ScottMonaghan/robud-pi/robud_face/Images/robud_eye.png

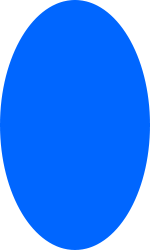
robud_face/Images/robud_eye.png
