ScottMonaghan/robud-pi/data/stl/base/Battery Fastener FR.stl

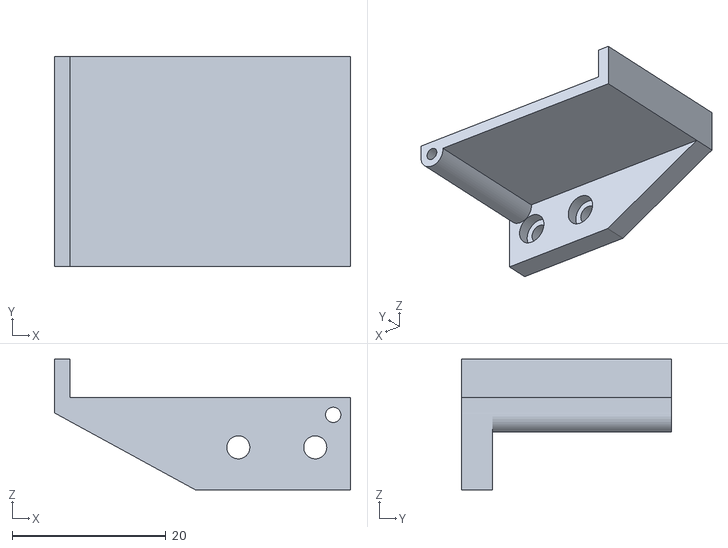
[picture p3: CAD file, 2023-02-08]
data/stl/base/Battery Fastener FR.stl
38.5 x 27.2 x 17.0
