ScottMonaghan/robud-pi/data/stl/robud-head-barrel-wall.stl

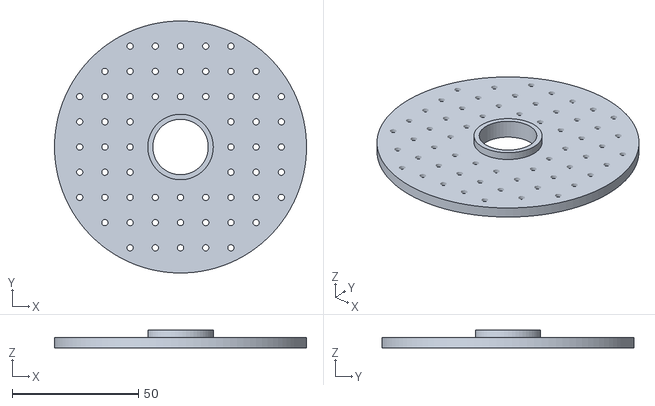
[picture p4: CAD file, 2022-10-22]
data/stl/robud-head-barrel-wall.stl
100.0 x 100.0 x 7.00
