ScottMonaghan/robud-pi/data/stl/tracks/Outer-Chassis-Brace_Left.stl

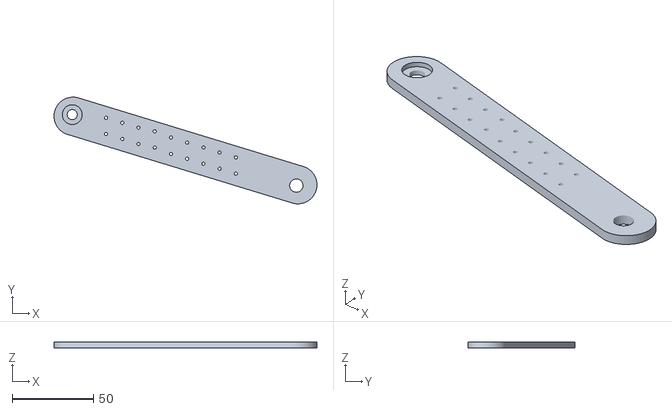
[picture p5: CAD file, 2023-03-19]
data/stl/tracks/Outer-Chassis-Brace_Left.stl
162.1 x 65.8 x 4.00
