ScottMonaghan/robud-pi/data/stl/robud-servo-adapter.stl

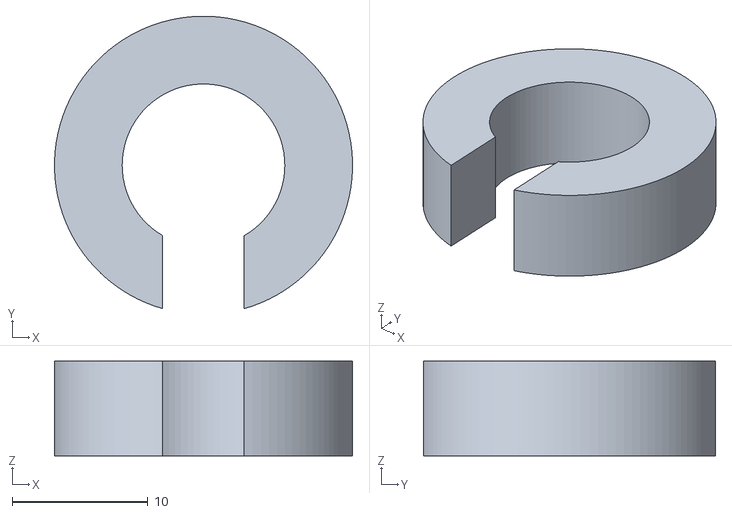
[picture p6: CAD file, 2022-10-22]
data/stl/robud-servo-adapter.stl
22.0 x 21.6 x 7.00
