ScottMonaghan/robud-pi/data/stl/tracks/Front Wheel 1.stl

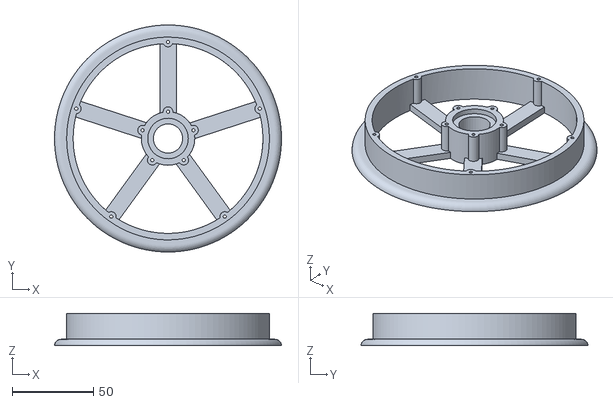
[picture p7: CAD file, 2023-03-19]
data/stl/tracks/Front Wheel 1.stl
140.0 x 140.0 x 20.0
