ScottMonaghan/robud-pi/data/stl/base/Board Fastener.stl

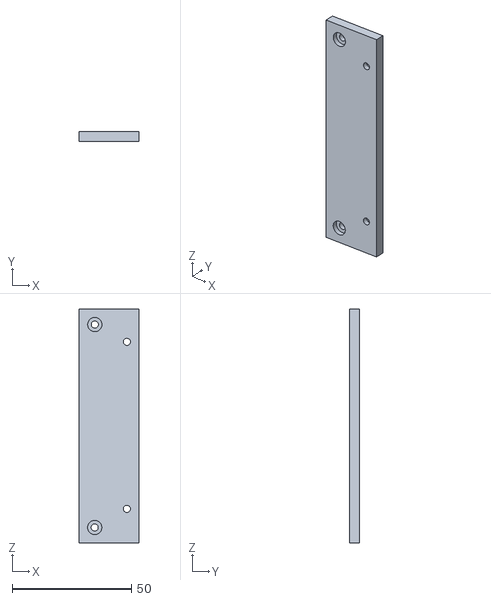
[picture p8: CAD file, 2023-02-08]
data/stl/base/Board Fastener.stl
25.0 x 4.00 x 98.0
