ScottMonaghan/robud-pi/data/stl/robud-display-fastener.stl

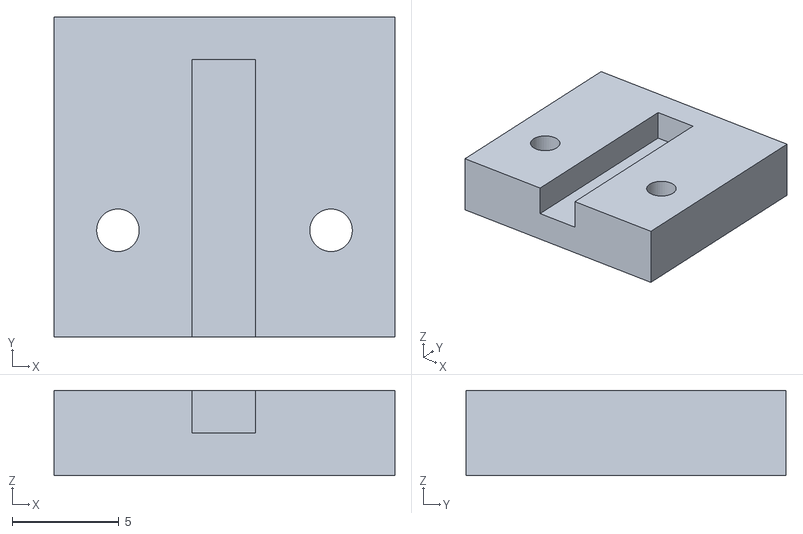
[picture p9: CAD file, 2022-10-22]
data/stl/robud-display-fastener.stl
16.0 x 15.0 x 4.00
