ScottMonaghan/robud-pi/data/stl/tracks/Bearing Peg & Spacer.stl

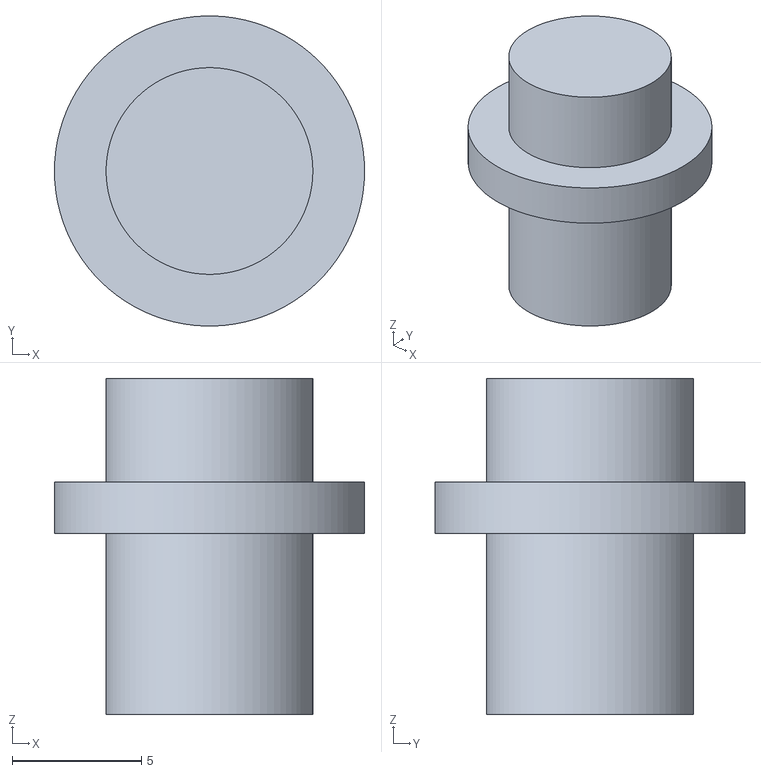
[picture p10: CAD file, 2023-03-19]
data/stl/tracks/Bearing Peg & Spacer.stl
12.0 x 12.0 x 13.0
