ScottMonaghan/robud-pi/data/stl/robud-1-hole-fastener.stl

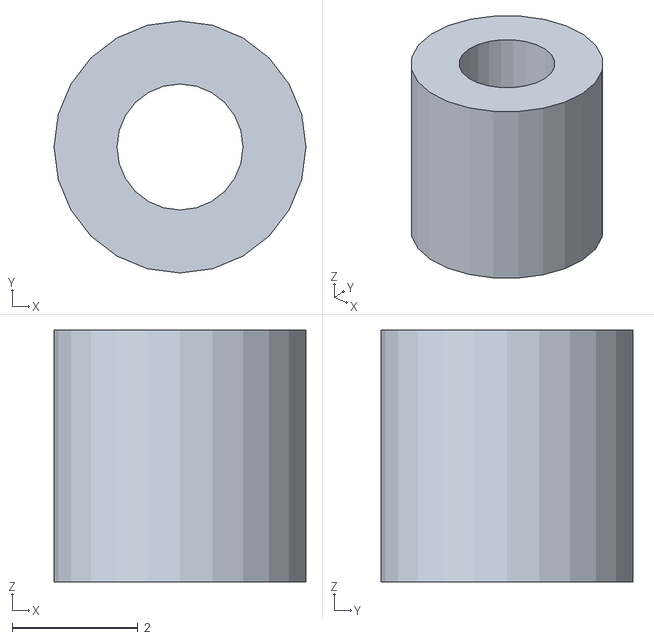
[picture p11: CAD file, 2022-10-22]
data/stl/robud-1-hole-fastener.stl
4.00 x 4.00 x 4.00
