ScottMonaghan/robud-pi/data/stl/robud-horizontal-brace.stl

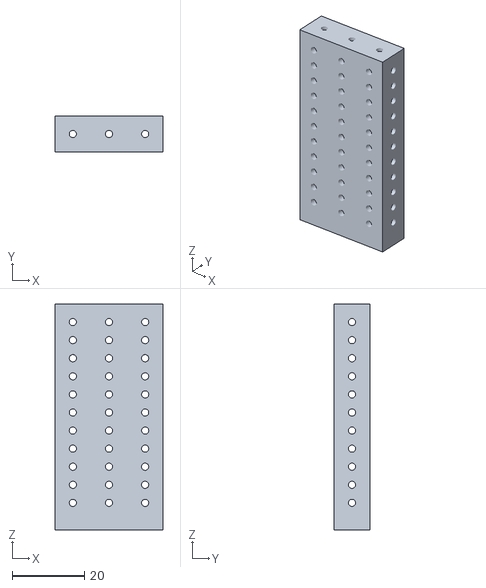
[picture p12: CAD file, 2022-10-22]
data/stl/robud-horizontal-brace.stl
30.0 x 10.0 x 62.5
