ScottMonaghan/robud-pi/data/stl/tracks/Front Wheel Hubcap.stl

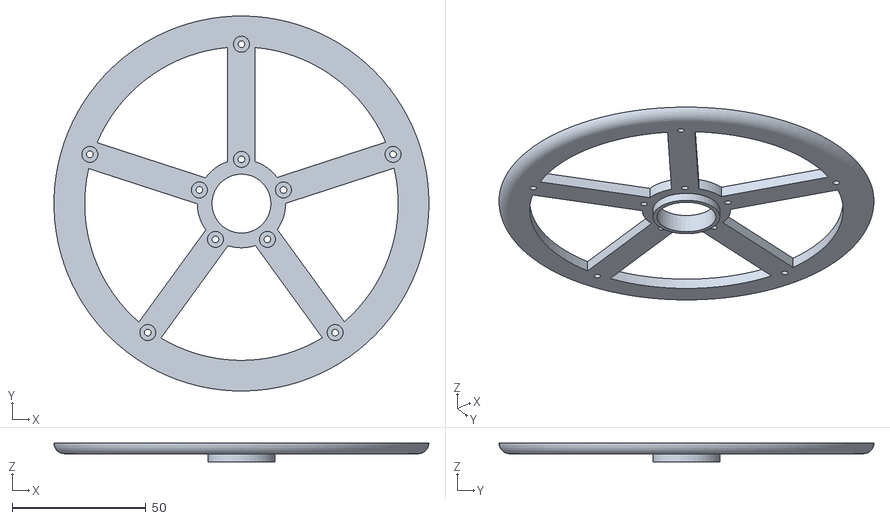
[picture p13: CAD file, 2023-03-19]
data/stl/tracks/Front Wheel Hubcap.stl
140.0 x 140.0 x 7.00
