ScottMonaghan/robud-pi/data/stl/robud-3-hole-fastener.stl

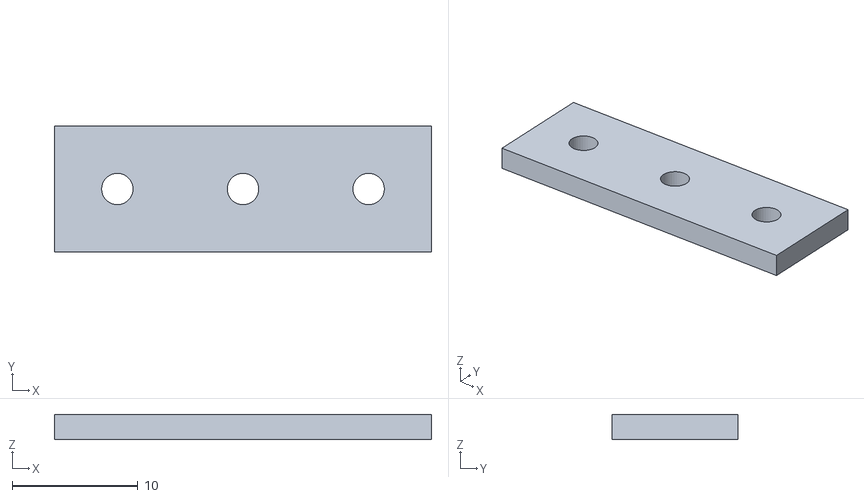
[picture p14: CAD file, 2022-10-22]
data/stl/robud-3-hole-fastener.stl
30.0 x 10.0 x 2.00
