ScottMonaghan/robud-pi/data/stl/tracks/Inner-Chassis-Brace_Right.stl

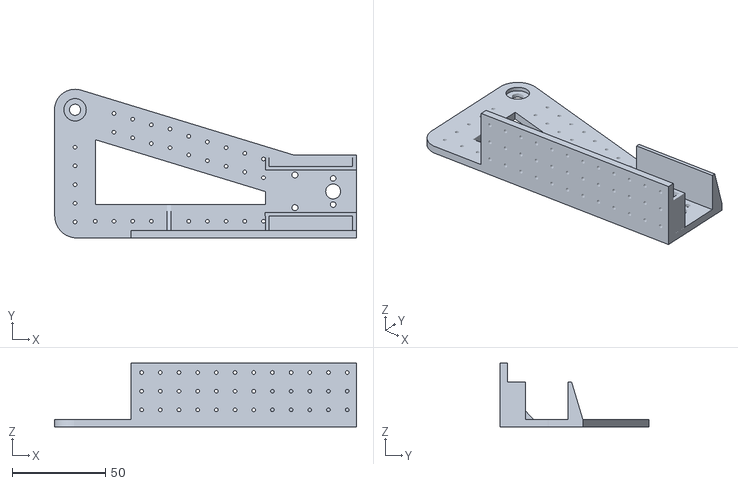
[picture p15: CAD file, 2023-03-19]
data/stl/tracks/Inner-Chassis-Brace_Right.stl
161.6 x 79.5 x 34.0
