ScottMonaghan/robud-pi/data/stl/robud-head-L-bracket.stl

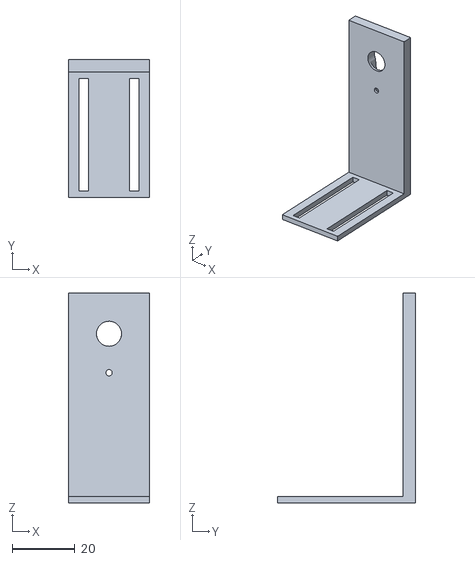
[picture p16: CAD file, 2022-10-22]
data/stl/robud-head-L-bracket.stl
26.0 x 44.0 x 67.0
