ScottMonaghan/robud-pi/data/stl/tracks/hub fastener.stl

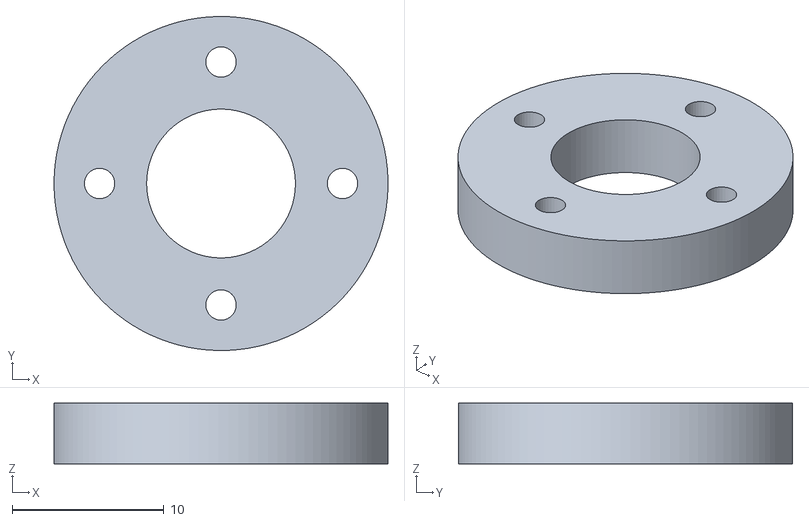
[picture p17: CAD file, 2023-03-19]
data/stl/tracks/hub fastener.stl
22.0 x 22.0 x 4.00
