ScottMonaghan/robud-pi/data/stl/tracks/Printable Belt.stl

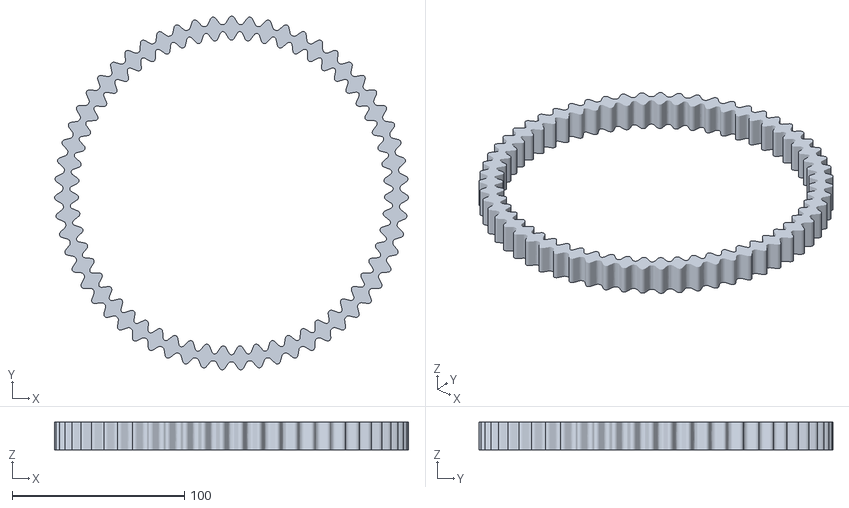
[picture p18: CAD file, 2023-03-19]
data/stl/tracks/Printable Belt.stl
205.4 x 205.3 x 16.0
