ScottMonaghan/robud-pi/data/stl/tracks/Back Wheel Cap.stl

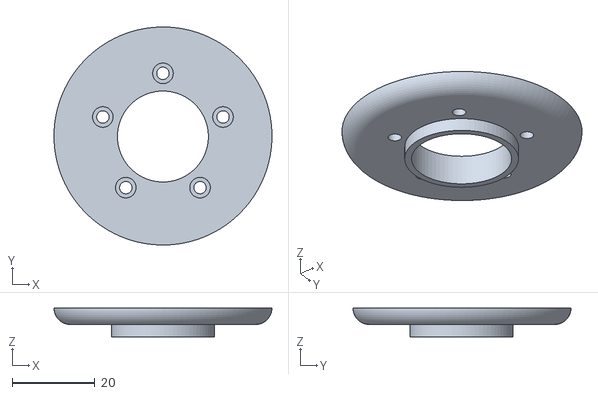
[picture p19: CAD file, 2023-03-19]
data/stl/tracks/Back Wheel Cap.stl
52.7 x 52.7 x 7.00
