ScottMonaghan/robud-pi/data/stl/tracks/Back Wheel Sprocket.stl

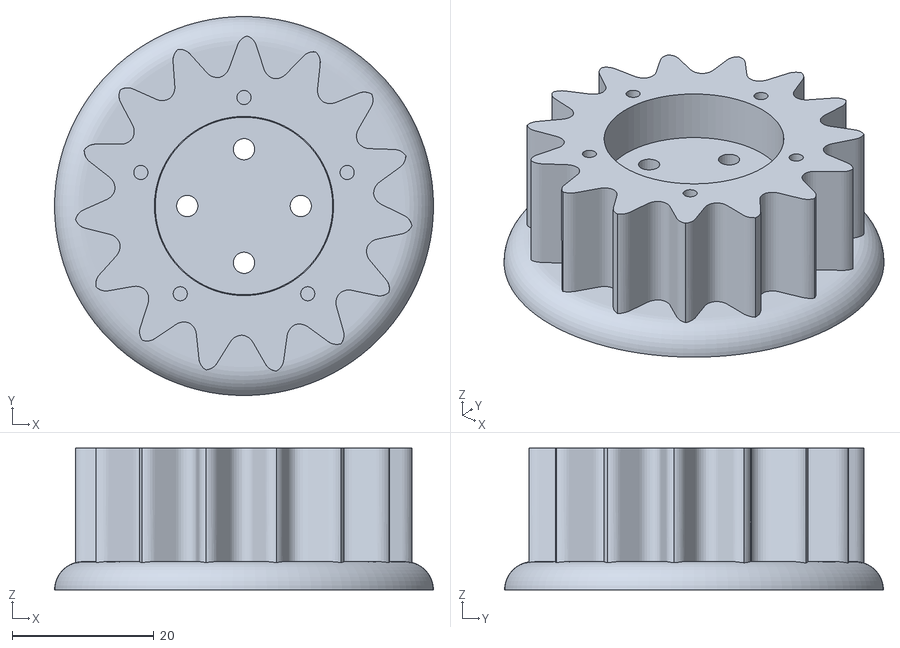
[picture p20: CAD file, 2023-03-19]
data/stl/tracks/Back Wheel Sprocket.stl
53.4 x 53.4 x 20.0
