ScottMonaghan/robud-pi/(list of files, cad)

Other CAD files:
data/stl/base/Battery Fastener FL.stl
data/stl/tracks/Outer-Chassis-Brace_Right.stl
data/stl/robud-head-shaft-adapter.stl
data/stl/tracks/Inner-Chassis-Brace_Left.stl
data/stl/tracks/Washer-large-inner-diameter.stl
data/stl/tracks/Washer-small-inner-diameter.stl
