ScottMonaghan/robud-pi/doc/build-instructions/head-assembly.md

## Head Assembly
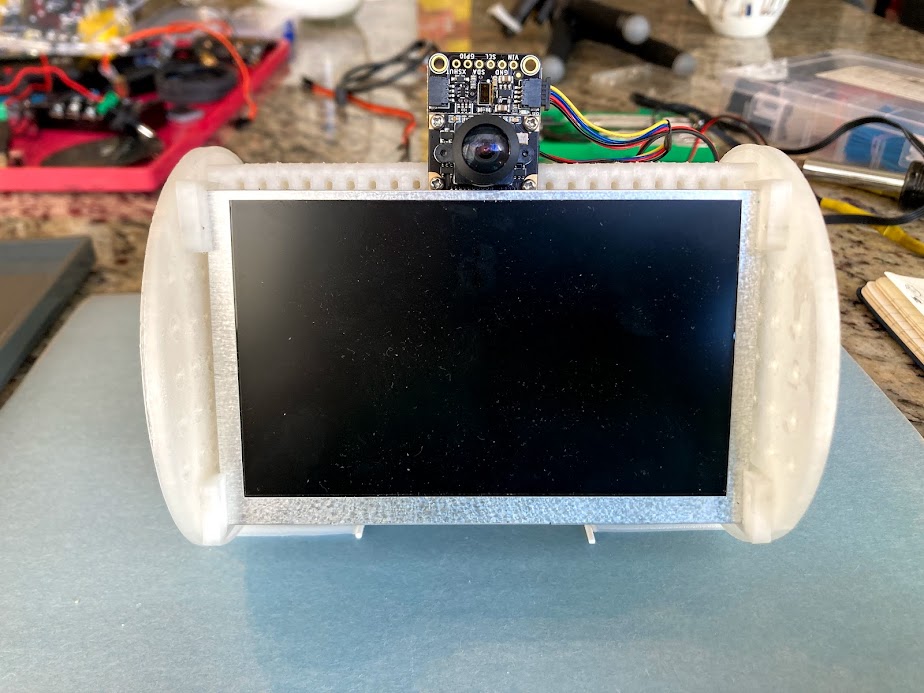
[picture p21: data/images/build-instructions/IMG_3664.jpg]

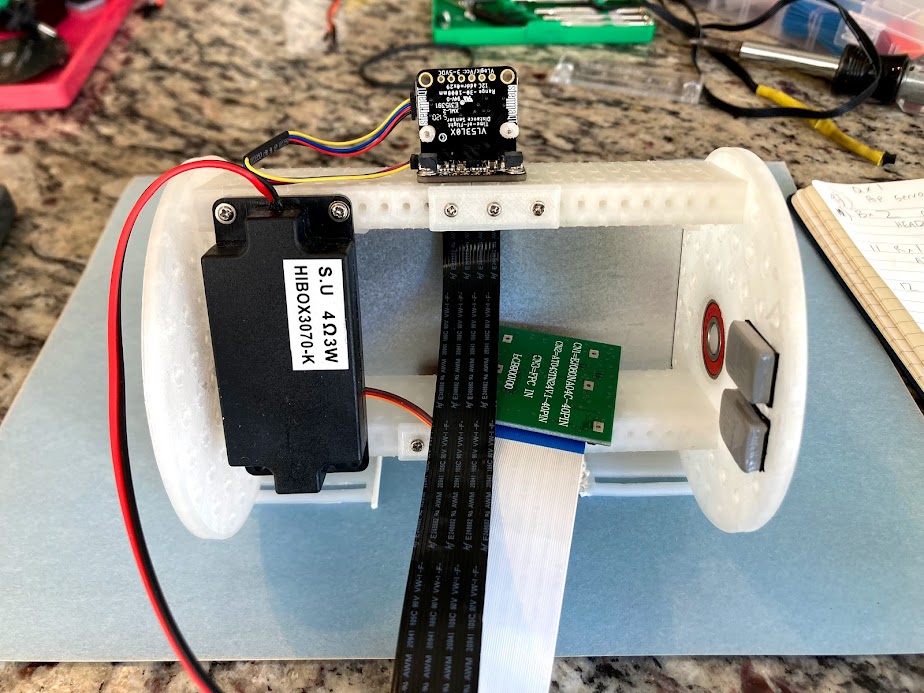
[picture p22: data/images/build-instructions/IMG_3666.jpg]


### 1. Attach two horizontal braces(A) with 3-hole fastener(B) & attach BNO-055  orientation sensor(E)  

**Parts:**  
   * x2 A. horizontal braces  
   * x1 B. 3-hole fastener  
   * x3 C. 2x8mm round-head self-tapping screws  
   * x4 D. 2x8mm pan-head-with-washer self-tapping screws  
   * x1 E. BNO055 orientation sensor  

>_**Notes:**_ 
>   * _Make sure Y axis of BNO055(E) points toward picture as shown in image_
>   * _Only fasten one side of the horizontal braces(E)_
     
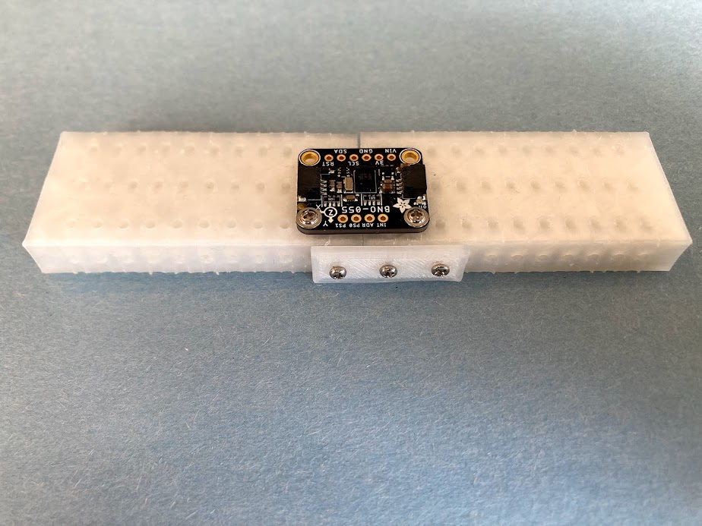
[picture p23: data/images/build-instructions/IMG_3640.jpg]


---
### 2. Turn 180 degrees and attach camera(F) 

**Parts:**  
   * x1 F. SainSmart IMX219 Camera Module
   * x2 C. 2x8mm round-head self-tapping screws

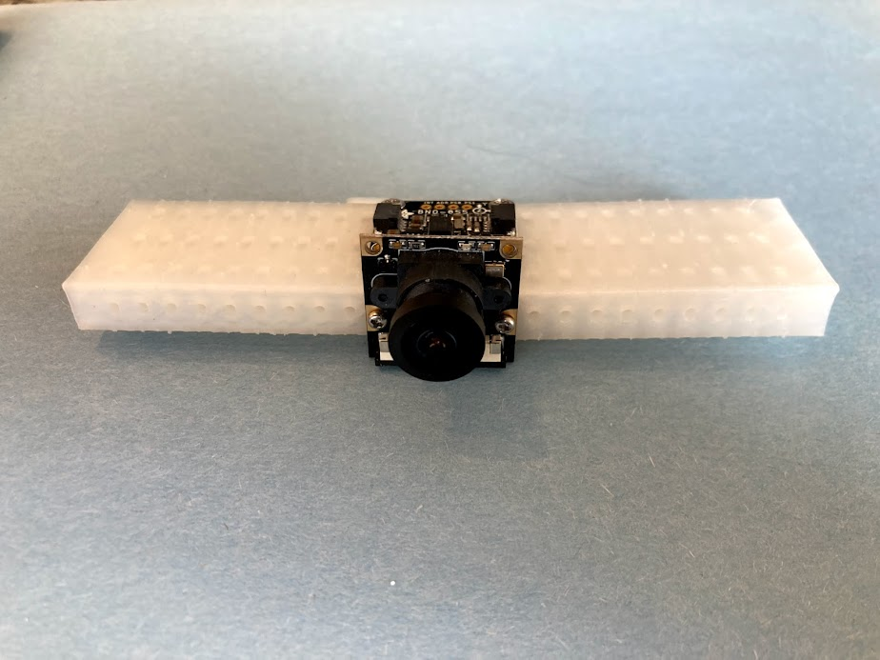
[picture p24: data/images/build-instructions/IMG_3642.jpg]
Head Assembly Step 2


---    
### 3. Attach VL53L0X time-of-flight distance sensor(G) 

**Parts:** 
  * x2 H. 1-hole 2mm screw fastener  
  * x2 C. 2x8mm round-head self-tapping screws  
  * x1 G. VL53L0X time-of-flight distance sensor  
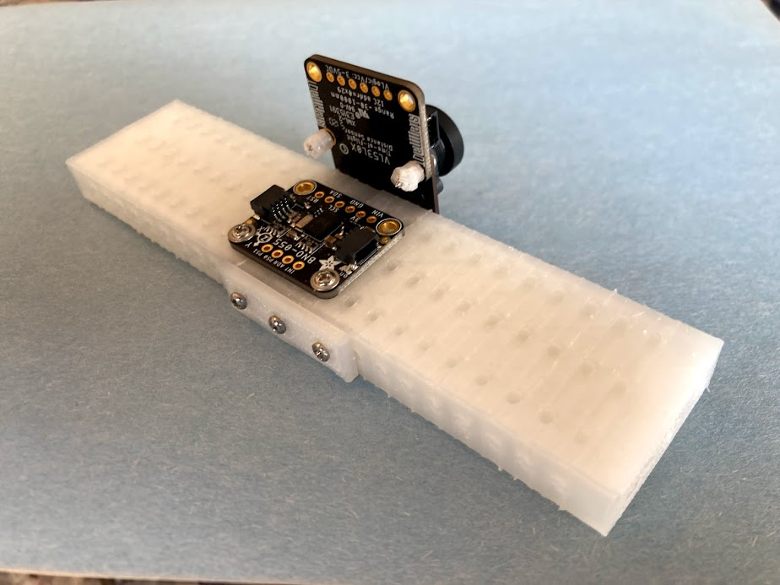
[picture p25: data/images/build-instructions/IMG_3644.jpg]

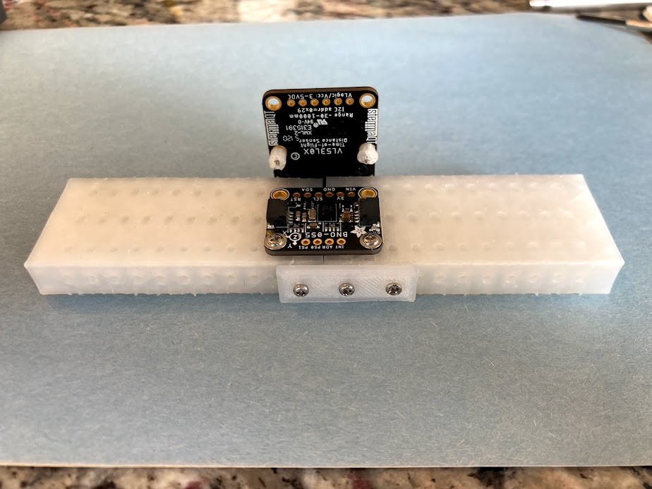
[picture p26: data/images/build-instructions/IMG_3645.jpg]


---     
### 4. Attach camera 15-pin ribbon(I) cable & STEMMA QT cable(J)

**Parts:** 
  * x1 I. 300mm 15-pin camera ribbon cable
  * x1 J. 100mm Stemma QT JST SH 4-pin cable

>_**Notes:**_ 
>   * _Make sure pins of ribbon cable are facing toward contacts and fastened securely_
>   * _Attatch STEMMA QT cable(J) securely to right STEMMA sockets on VL53L0X(G) and BNO055(E)_
   
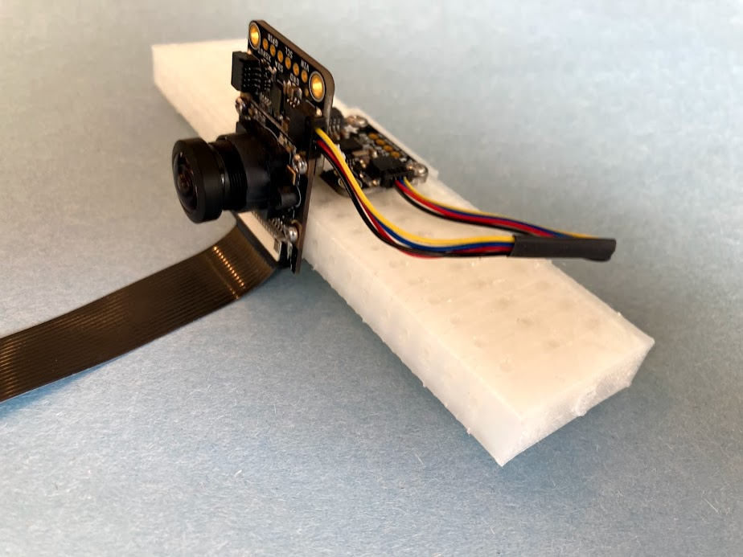
[picture p27: data/images/build-instructions/IMG_3646.jpg]
Head Assembly Step 4


---   
### 5. Attach display fasteners(K) and servo adapter(L) to left barrel wall(M)
**Parts:**  
 * x1 M. head barrel wall
 * x1 L. servo adapter
 * x2 K. display fastener
 * x4 D. 2x8mm pan-head-with-washer self-tapping screws

>_**Notes:**_
>   * _Make sure fasteners and raised center lip are on opposite sides_
>   * _Make sure slotted sides of the display fasteners(K) are face up, with open sides pointed inside the circle, and closed ends are pointed out_
>   * _Make sure servo adapter is oriented as shown in image_
>   * _If servo adapter cannot be popped in, soften with a hair dryer or heat gun_
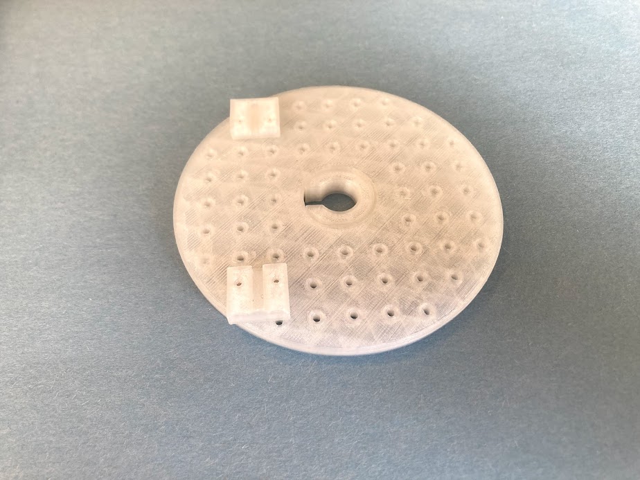
[picture p28: data/images/build-instructions/IMG_3647.jpg]

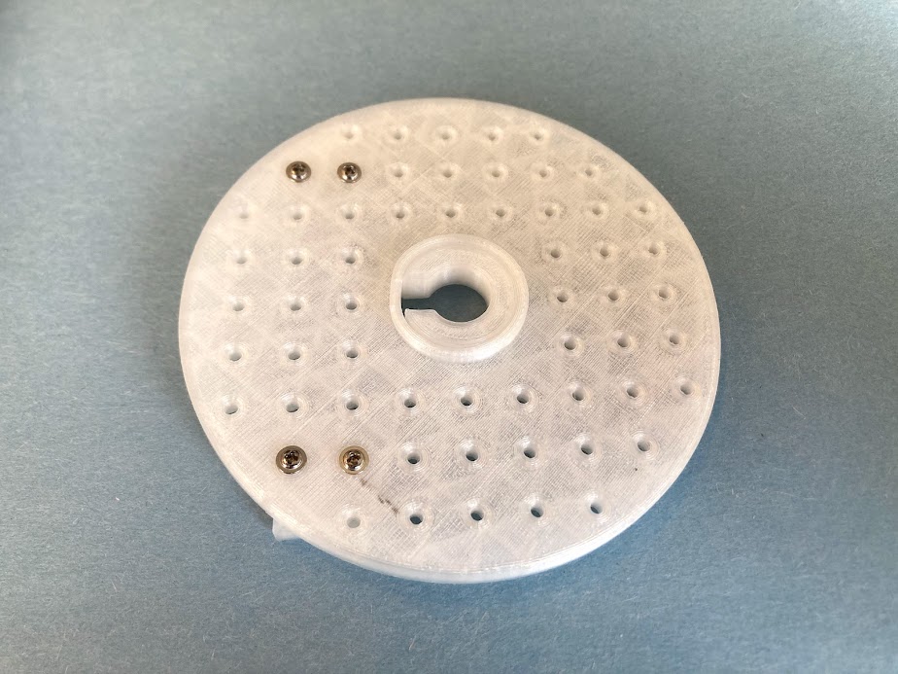
[picture p29: data/images/build-instructions/IMG_3648.jpg]


---   
### 6. Backdrive servo to 90 degrees
**Parts:**  
   * x1 Q. MG90S 9G micro servo  

>_**Notes:**_
>   * _Suggested steps:_
>     * _Use pliars to gently turn the servo shaft counter-clockwise until you hit the physical stop._
>     * _Then position your pliars at the top at 12:00 as shown in the first picture._
>     * _Finally, carefully turn the shaft clockwise 90 degrees to 3:00 as shown in the second picture._  
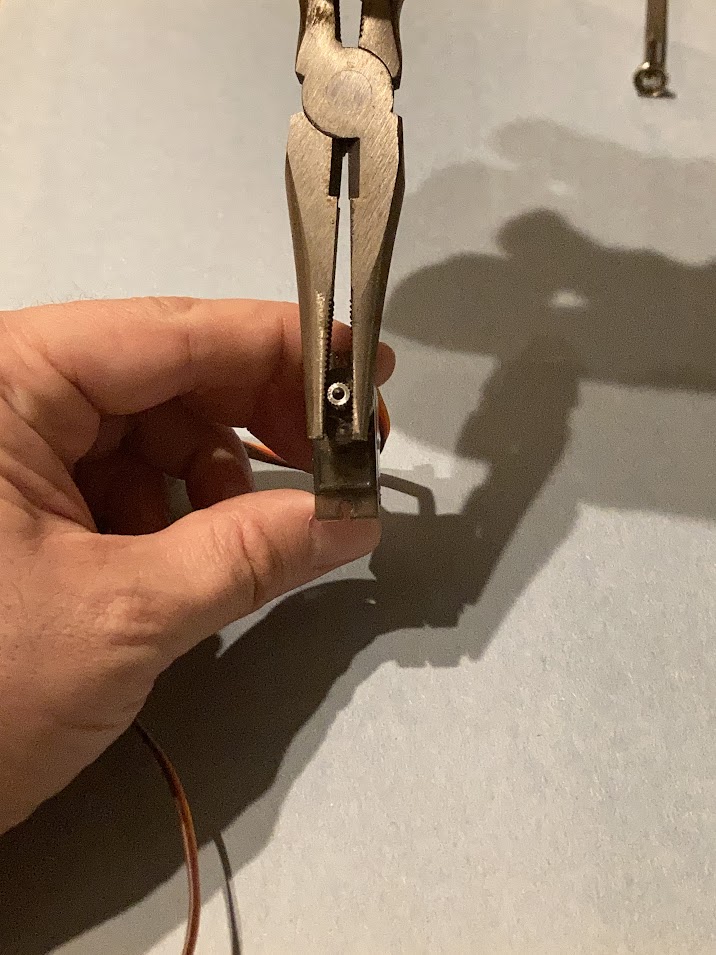
[picture p30: data/images/build-instructions/IMG_3672.jpg]

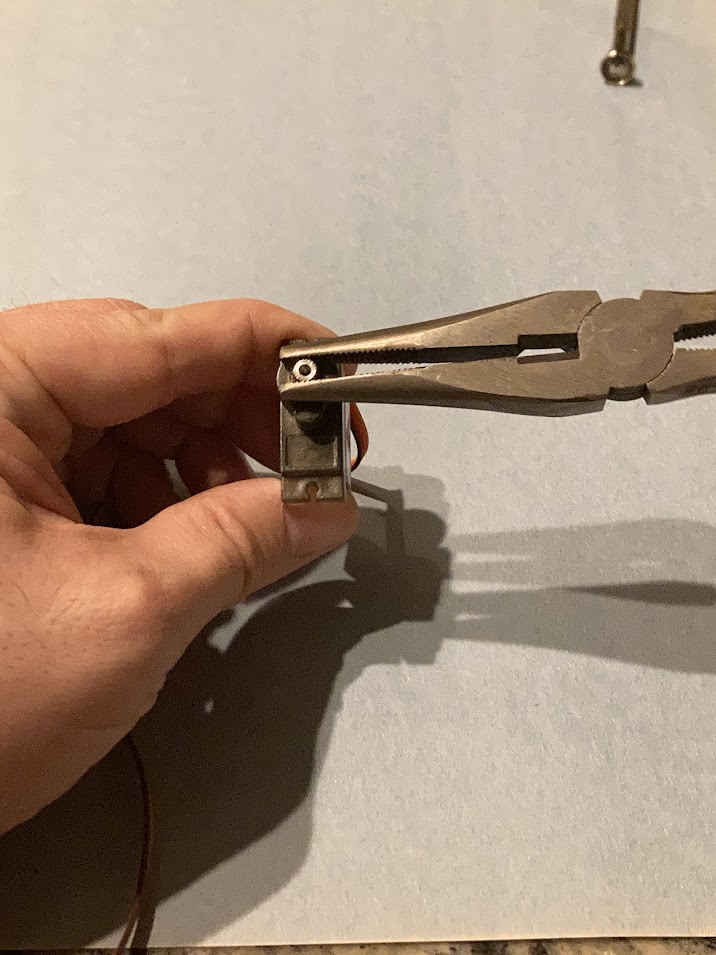
[picture p31: data/images/build-instructions/IMG_3684.jpg]


---   
### 7. Pop servo(Q) into left barrel wall(M)
**Parts:**  
   * x1 Q. MG90S 9G micro servo  
   * x2 M. left barrel wall(M) from step 5  

>_**Notes:**_
>   * _Body of servo should be on same side as fasteners from step 5_  
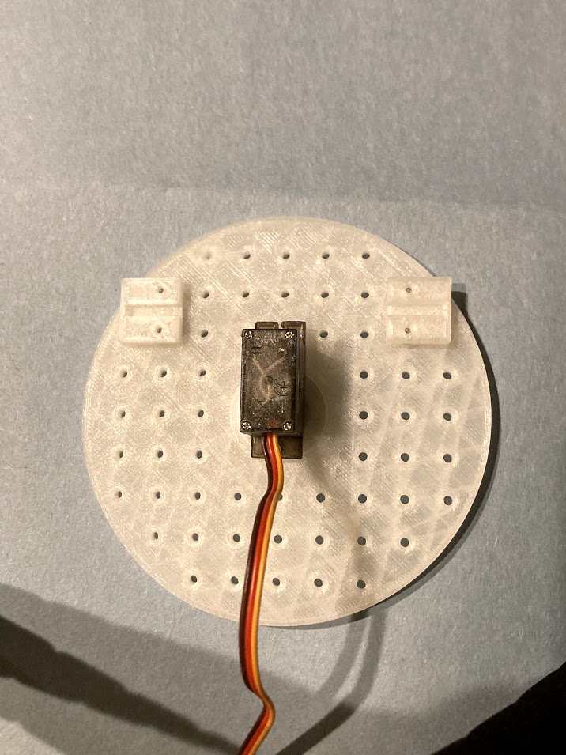
[picture p32: data/images/build-instructions/IMG_3689.jpg]


---   
### 8. Add shaft(N) to bearing(O)
**Parts:**  
 * x1 N. head shaft adapter 
 * x1 O. bearing 

>_**Notes:**_
>   * _If shaft cannot be popped in, soften with a hair dryer or heat gun_
>   * _The longer side of the shaft should be in the bearing_
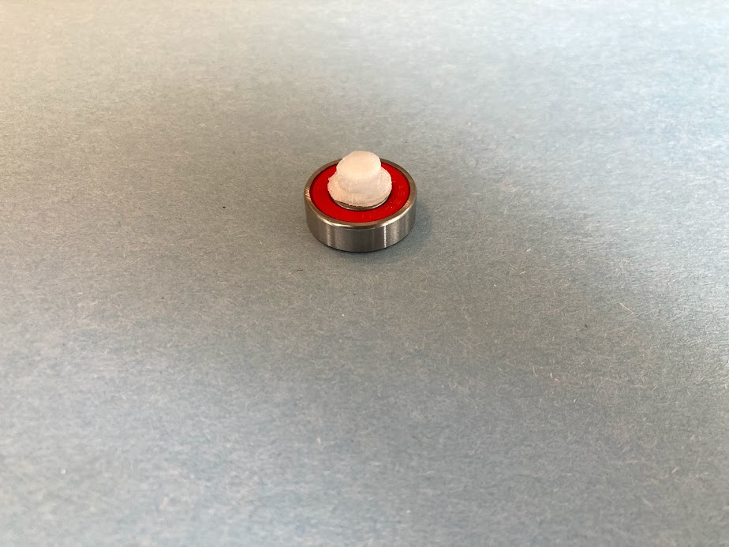
[picture p33: data/images/build-instructions/IMG_3650.jpg]


---   
### 9. Attach display fasteners(K) and balance weights(L) to right barrel wall(M)
**Parts:**  
 * x1 M. head barrel wall
 * x2 K. display fastener
 * x2 P. balance weights

>_**Notes:**_
>  * _Make sure fasteners and raised center lip are on opposite sides_
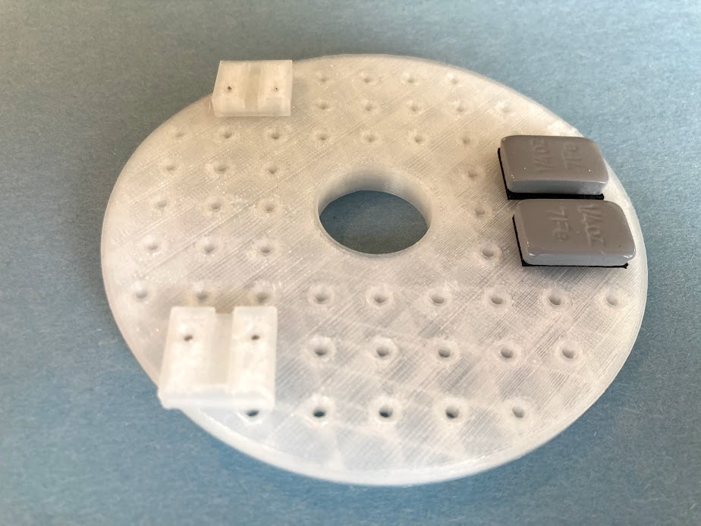
[picture p34: data/images/build-instructions/IMG_3651.jpg]


---   
### 10. Pop bearing(O) into right barrel wall(M)
**Parts:**  
 * x1 bearing(O) with shaft(N) from step 8
 * x1 right barrel wall(M) from step 9

>_**Notes:**_
>   * _Make sure shaft is on the opposite side of the clips & weights_
>   * _If bearing cannot be popped in, soften with a hair dryer or heat gun_
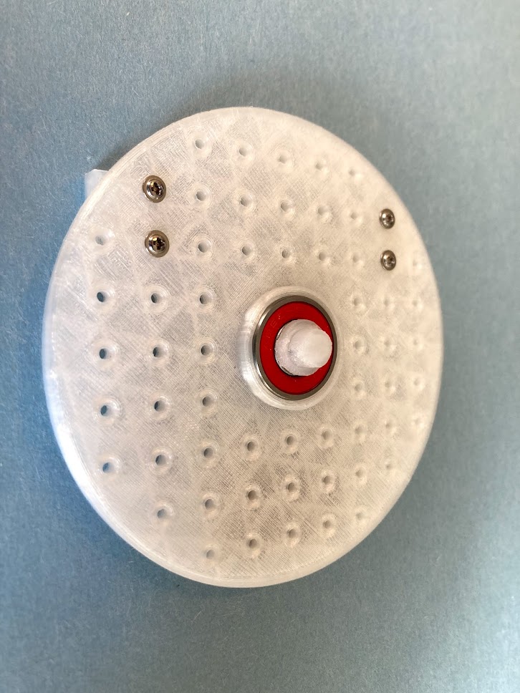
[picture p35: data/images/build-instructions/IMG_3652.jpg]


---   
### 11. Attach two horizontal braces(A) with two 3-hole fasteners(B) to create lower head brace
**Parts:**  
   * x2 A. horizontal braces  
   * x2 B. 3-hole fasteners  

>_**Notes:**_
>  * _Make sure to add 3-hole fastener(B) to both sides_
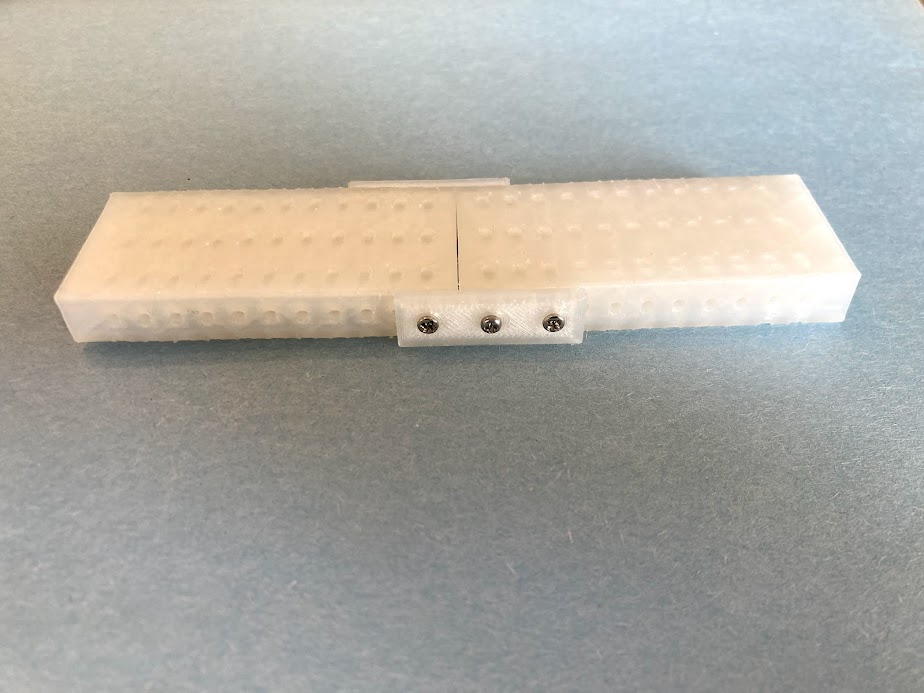
[picture p36: data/images/build-instructions/IMG_3653.jpg]


---   
### 12. Attach bottom head brace to left barrel wall
**Parts:**  
   * x1 Left barrel wall with servo (from step 7)  
   * x1 Lower horizontal head brace (from step 11)  
   * x2 D. 2x8mm pan-head-with-washer self-tapping screws
  
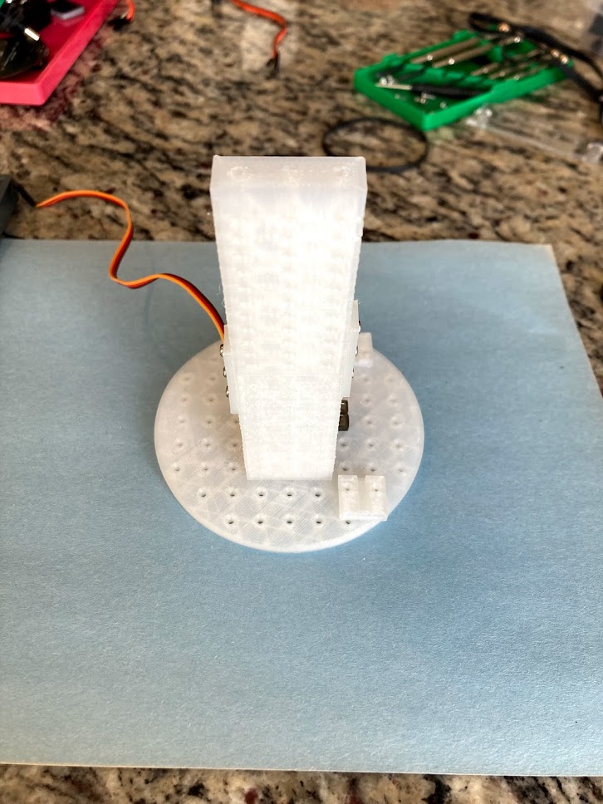
[picture p37: data/images/build-instructions/IMG_3654.jpg]

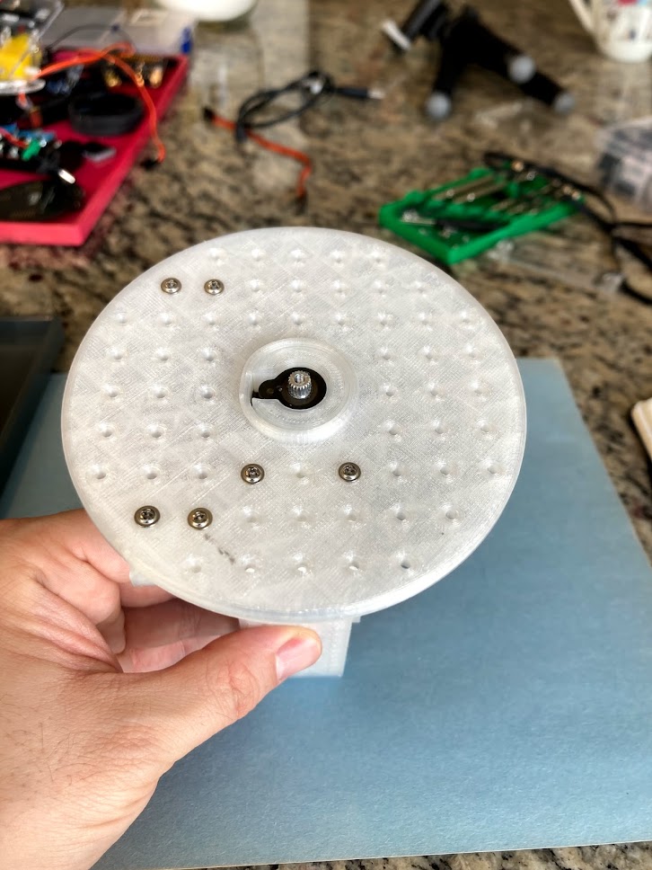
[picture p38: data/images/build-instructions/IMG_3655.jpg]


---   
### 13. Attach top head brace to left barrel wall
**Parts:**  
   * x1 Left barrel wall with servo (from step 12)  
   * x1 Top horizontal head brace with camera (from step 1)  
   * x2 D. 2x8mm pan-head-with-washer self-tapping screws
  
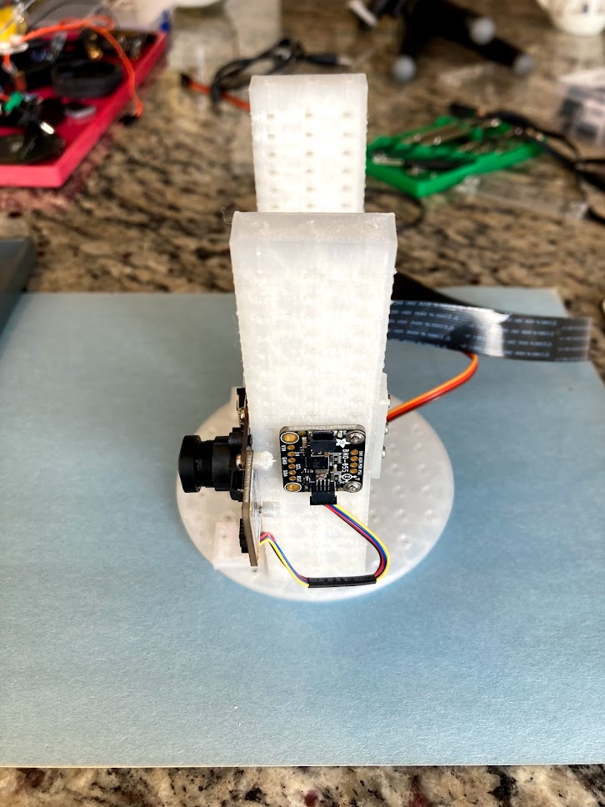
[picture p39: data/images/build-instructions/IMG_3656.jpg]

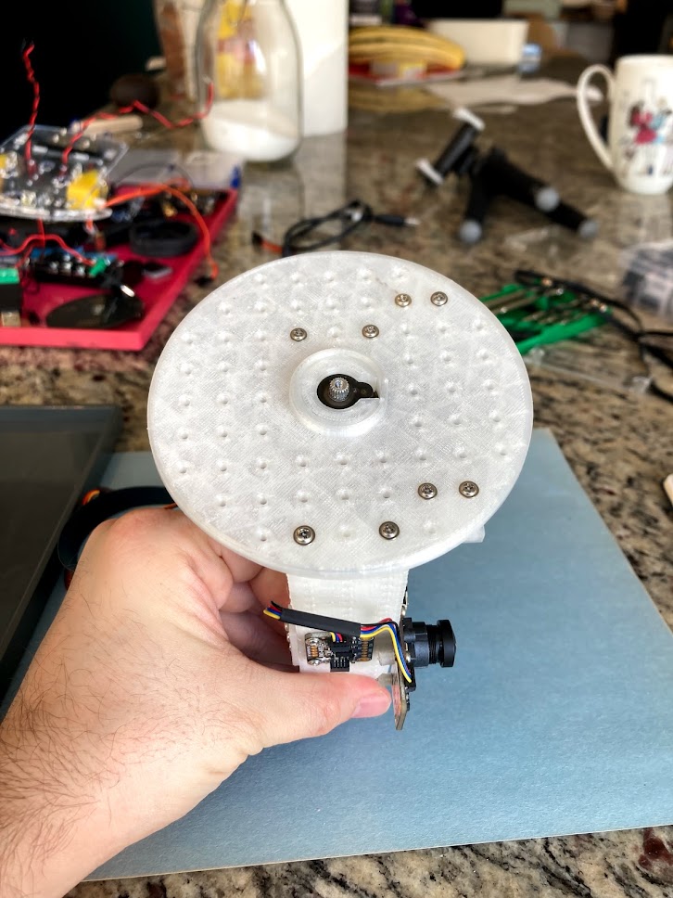
[picture p40: data/images/build-instructions/IMG_3657.jpg]


---   
### 14. Attach 40-pin display ribbon(S) to display(R)  
**Parts:**  
   * x1 R. 7in display  
   * x1 S. 250mm 40pin display ribbon cable  

>_**Notes:**_
>   * _Make sure pins of ribbon cable are facing toward contacts and fastened securely_
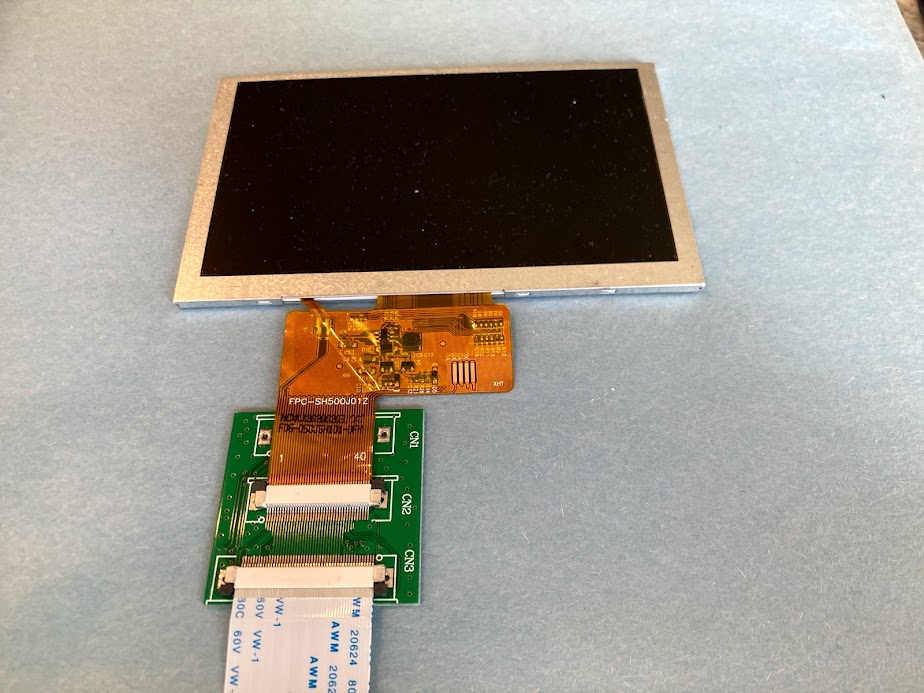
[picture p41: data/images/build-instructions/IMG_3658.jpg]


---   
### 15. Pop display(S) into clips of left barrel wall(M)
**Parts:**  
   * x1 R. 7in display  
   * x1 left barrel wall with servo (from step 12)  

>_**Notes:**_
>   * _Make sure the cables are on the bottom (opposite camera) and feed bewtween both horizontal braces_

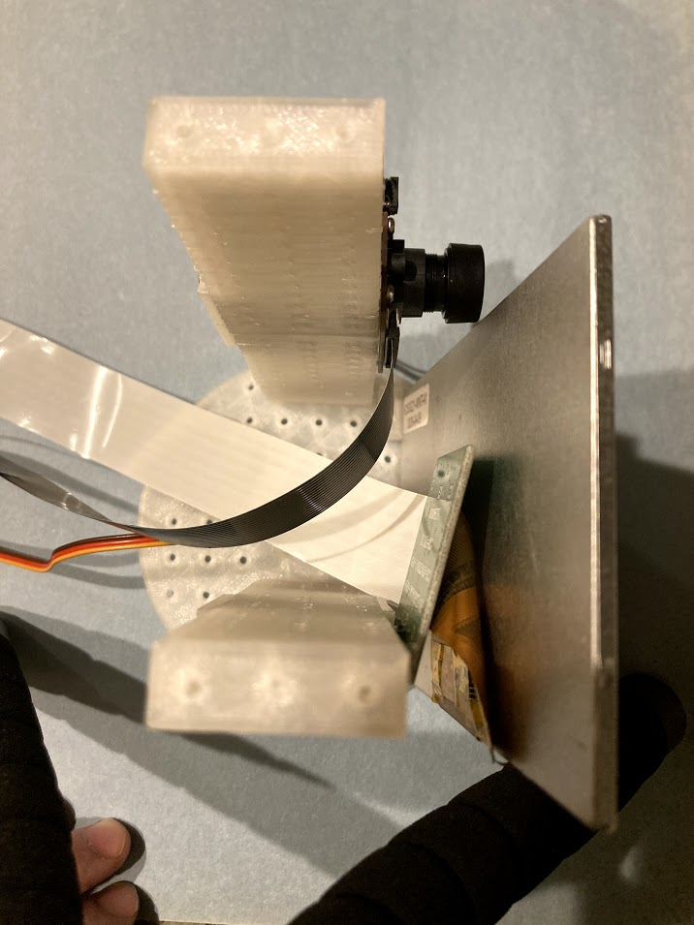
[picture p42: data/images/build-instructions/IMG_3690.jpg]


---   
### 16. Pop right barrel(M) display fasteners(K) onto display and secure to horizontal braces(A) 
**Parts:**  
   * x1 right barrel wall(M) with bearing and shaft (from step 10)
   * x2 D. 2x8mm pan-head-with-washer self-tapping screws

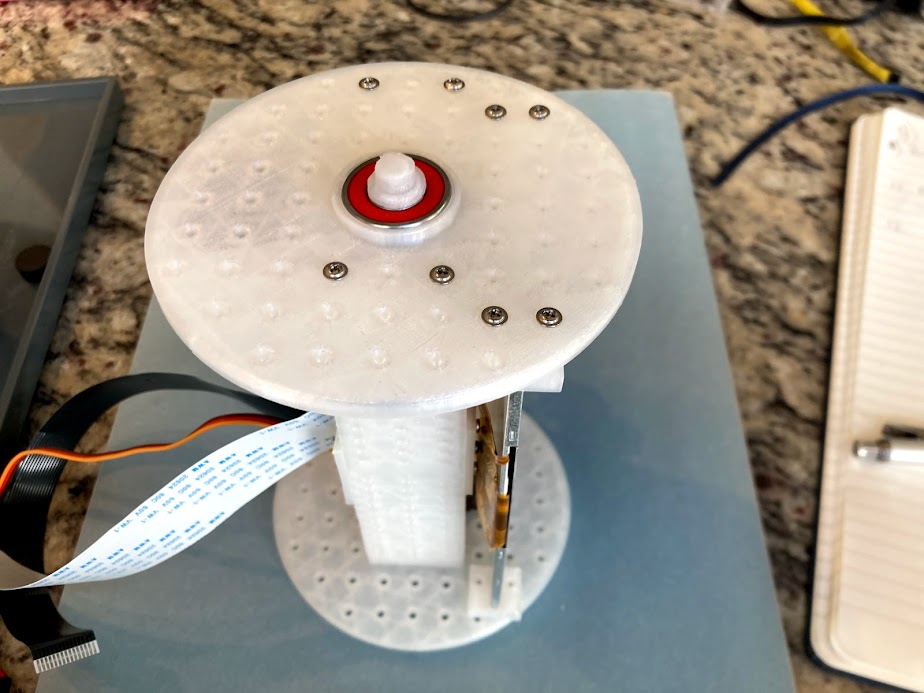
[picture p43: data/images/build-instructions/IMG_3659.jpg]


---   
### 17. Attach speaker(T)
**Parts:**  
   * x1 T. mono enclosed speaker - 3W 4 ohm
   * x2 D. 2x8mm pan-head-with-washer self-tapping screws

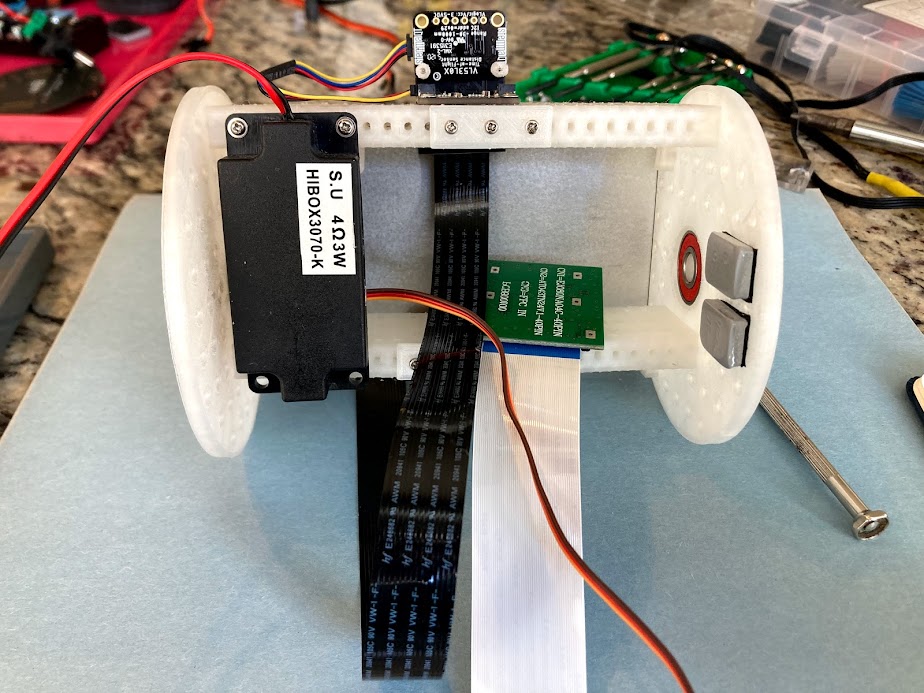
[picture p44: data/images/build-instructions/IMG_3660.jpg]


---   
### 18. Pop right L bracket(U) on bearing shaft
**Parts:**  
   * x1 U. head L bracket

>_**Notes:**_
>   * _If shaft does not pop onto L bracket, use hair dryer or heat gun to soften_

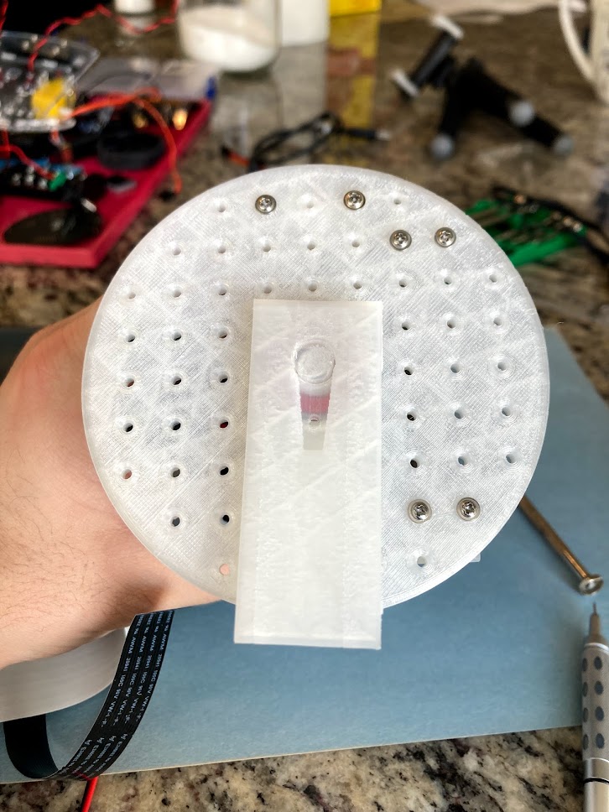
[picture p45: data/images/build-instructions/IMG_3661.jpg]


---   
### 19. Attatch servo horn to remaining L bracket(L) and secure with screw(D)
**Parts:**  
   * x1 U. head L bracket
   * x1 V. servo horn
   * x1 D. 2x8mm pan-head-with-washer self-tapping screw

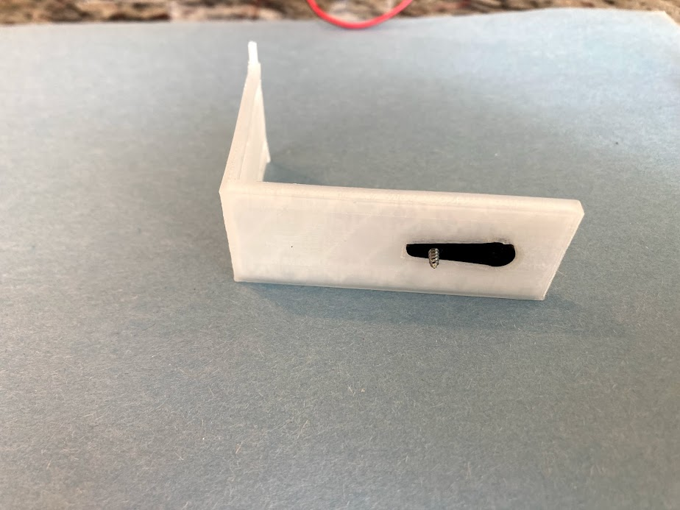
[picture p46: data/images/build-instructions/IMG_3662.jpg]

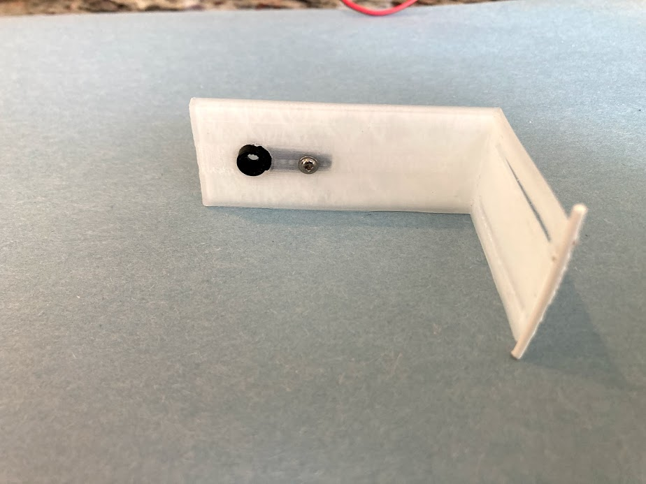
[picture p47: data/images/build-instructions/IMG_3663.jpg]


---   
### 20. Secure left L bracket to head with servo screw(W)
**Parts:**  
   * x1 W. server screw

>_**Notes:**_
>  * _IMPORTANT: The servo horn should be pointing straight down attached with screen pointing straight left_
>  * _Be careful not to turn servo shaft when attaching. If you do, repeat step 6._

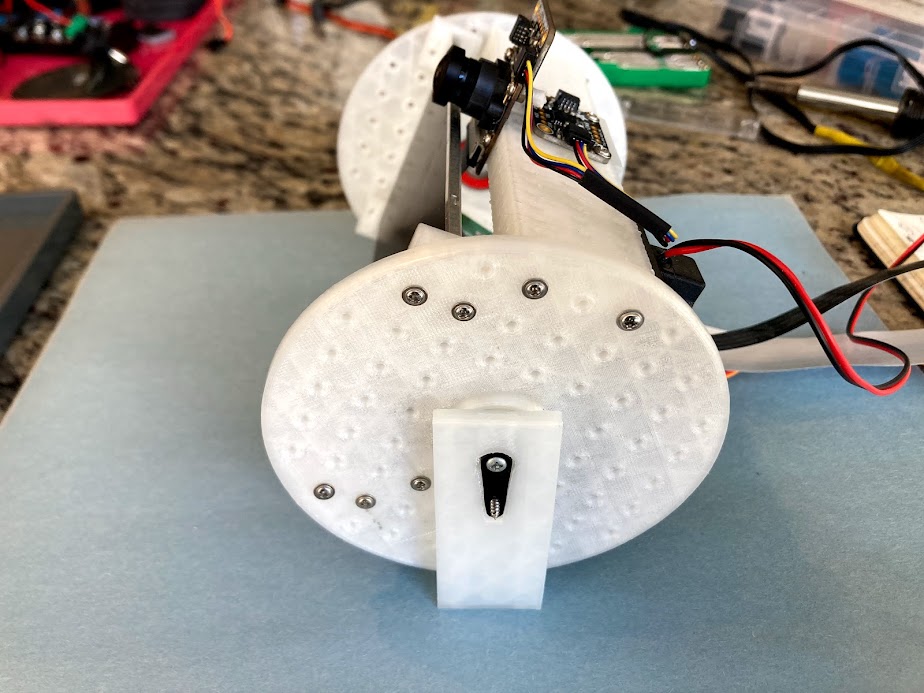
[picture p48: data/images/build-instructions/IMG_3665.jpg]


---   
### 21. The head is now complete and should match the images below:  

Head Assembly Step 5
Head Assembly Step 5
Head Assembly Step 5
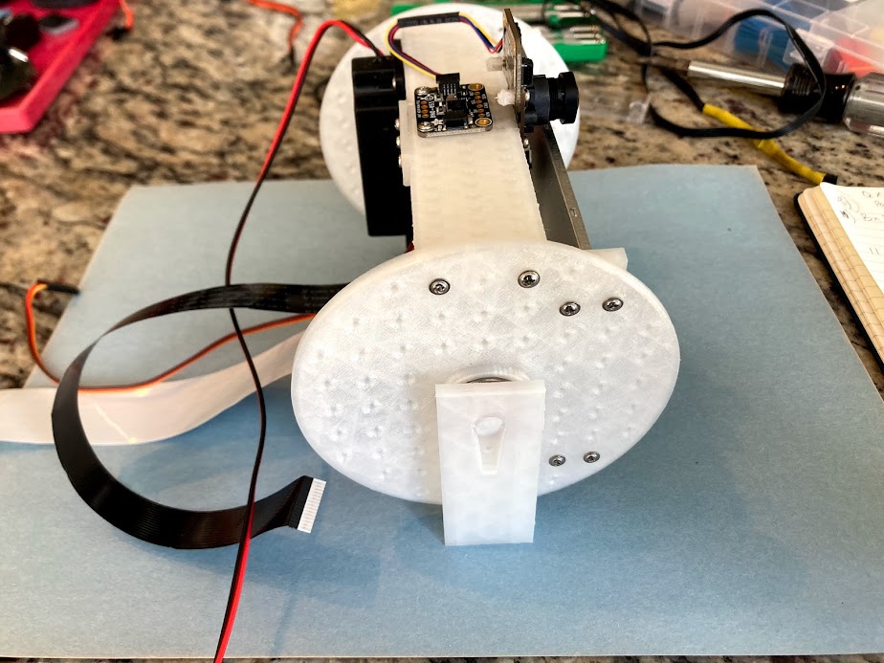
[picture p49: data/images/build-instructions/IMG_3667.jpg]


[Return to Readme](../../README.md#table-of-contents)
