ScottMonaghan/robud-pi/data/images/build-instructions/IMG_3643.jpg

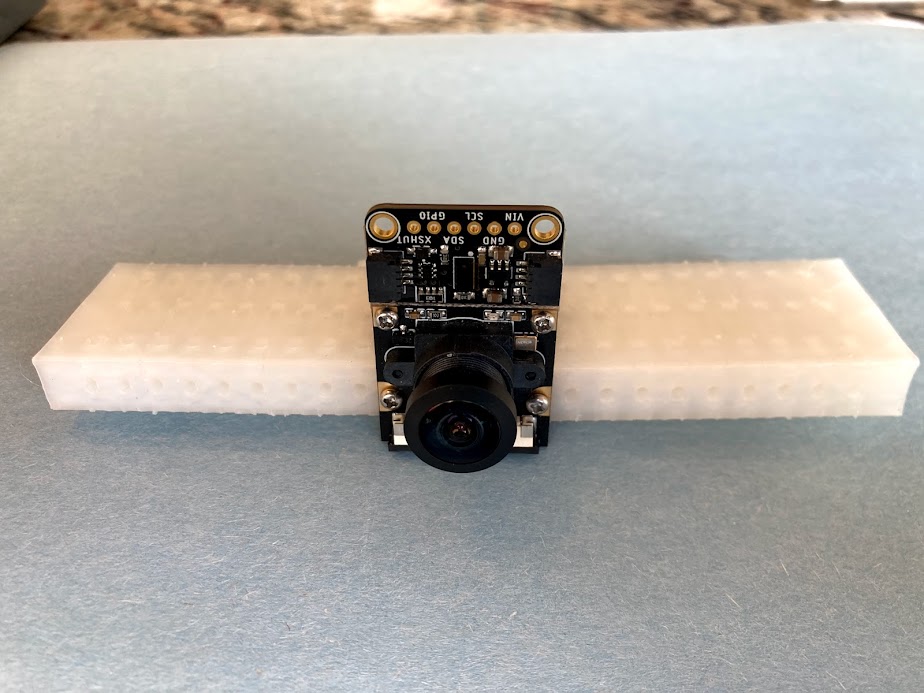
data/images/build-instructions/IMG_3643.jpg
