ScottMonaghan/robud-pi/data/images/build-instructions/IMG_3691.jpg

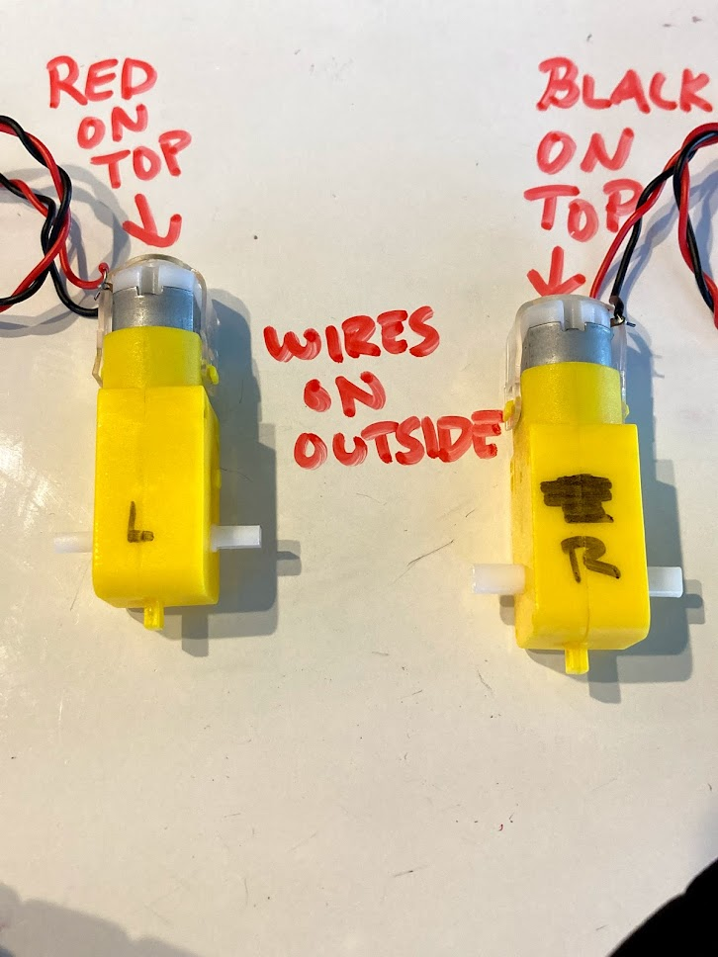
data/images/build-instructions/IMG_3691.jpg
