ScottMonaghan/robud-pi/data/images/build-instructions/IMG_3692.jpg

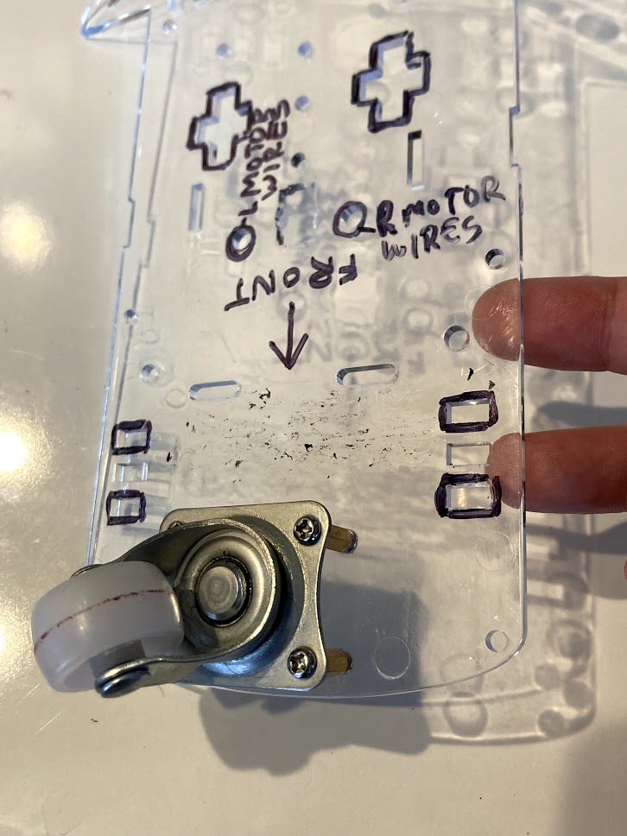
data/images/build-instructions/IMG_3692.jpg
