ScottMonaghan/robud-pi/data/images/build-instructions/IMG_3693.jpg

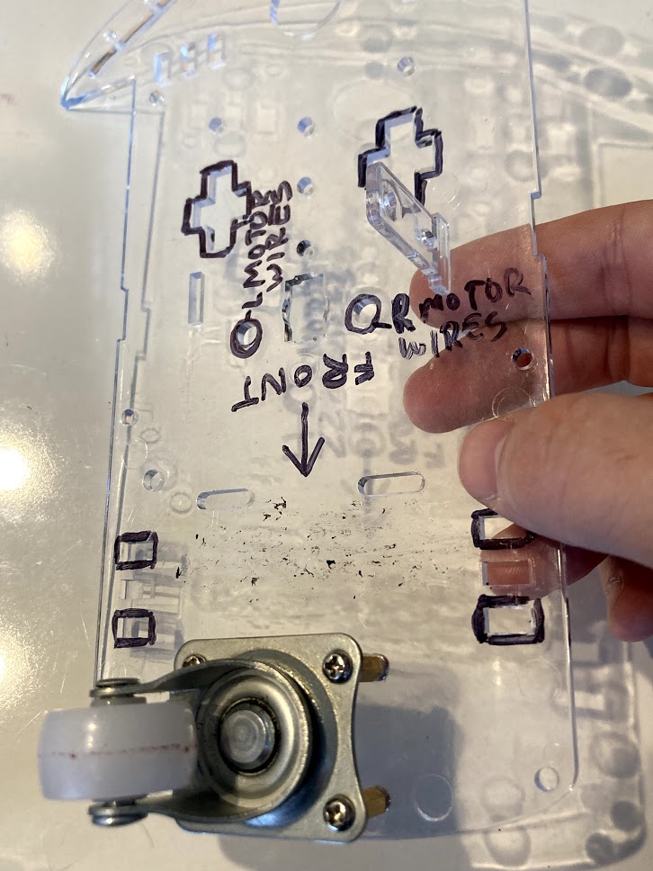
data/images/build-instructions/IMG_3693.jpg
