ScottMonaghan/robud-pi/data/images/build-instructions/IMG_3694.jpg

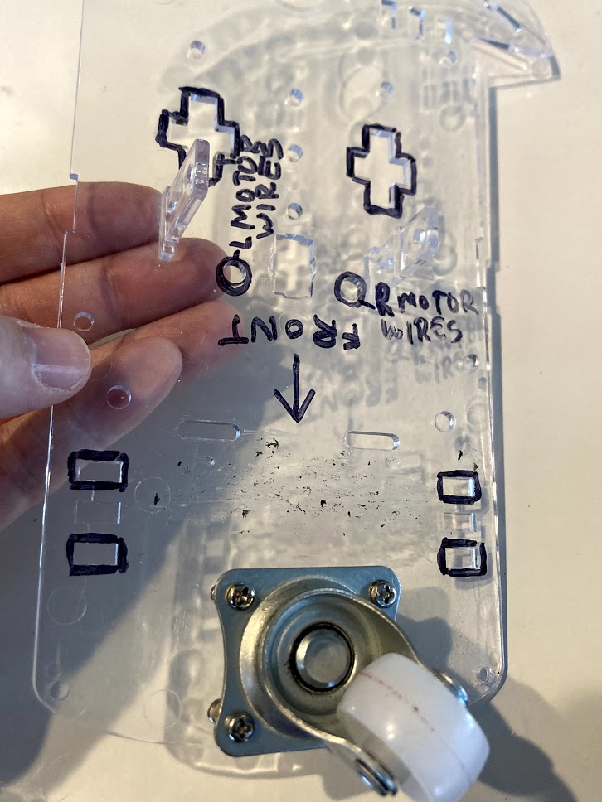
data/images/build-instructions/IMG_3694.jpg
