ScottMonaghan/robud-pi/data/images/build-instructions/IMG_3702.JPG

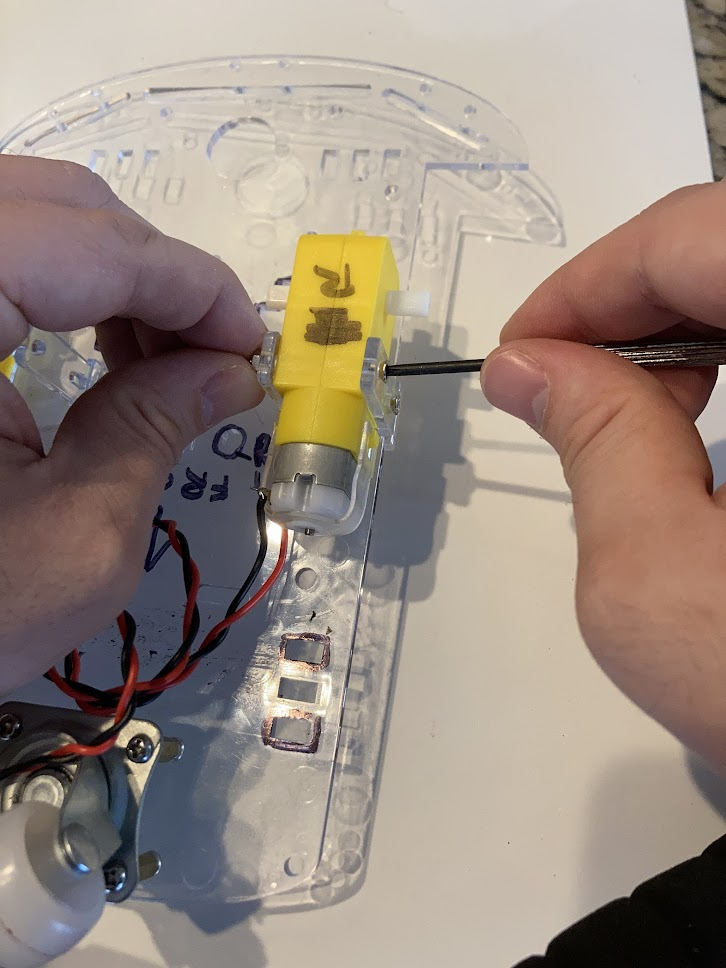
data/images/build-instructions/IMG_3702.JPG
