ScottMonaghan/robud-pi/data/images/build-instructions/IMG_3710.JPG

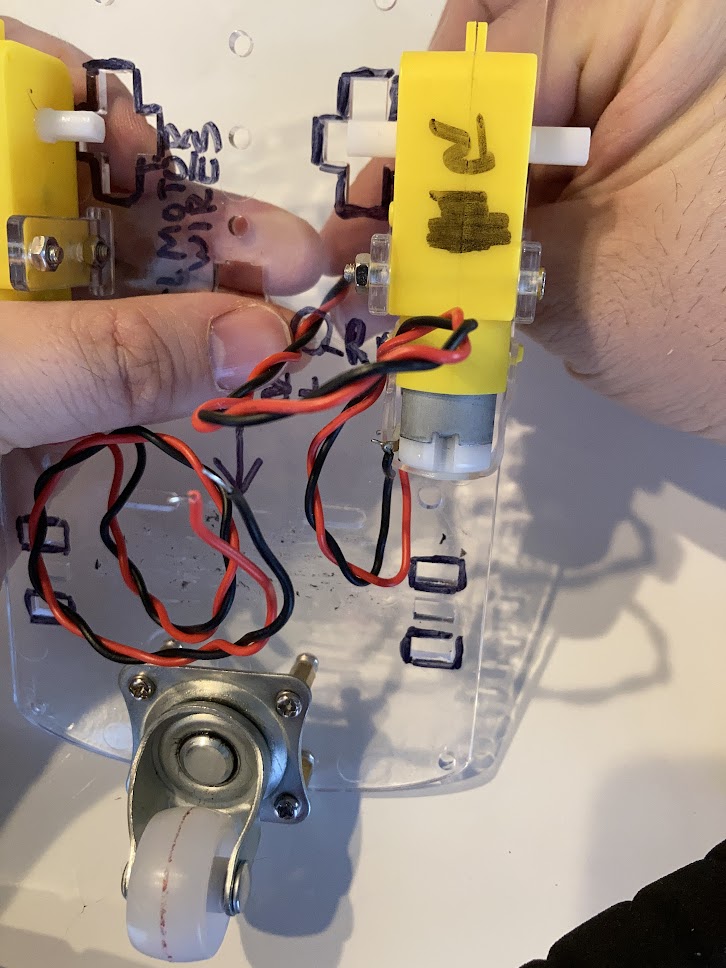
data/images/build-instructions/IMG_3710.JPG
