ScottMonaghan/robud-pi/data/images/build-instructions/IMG_3716.JPG

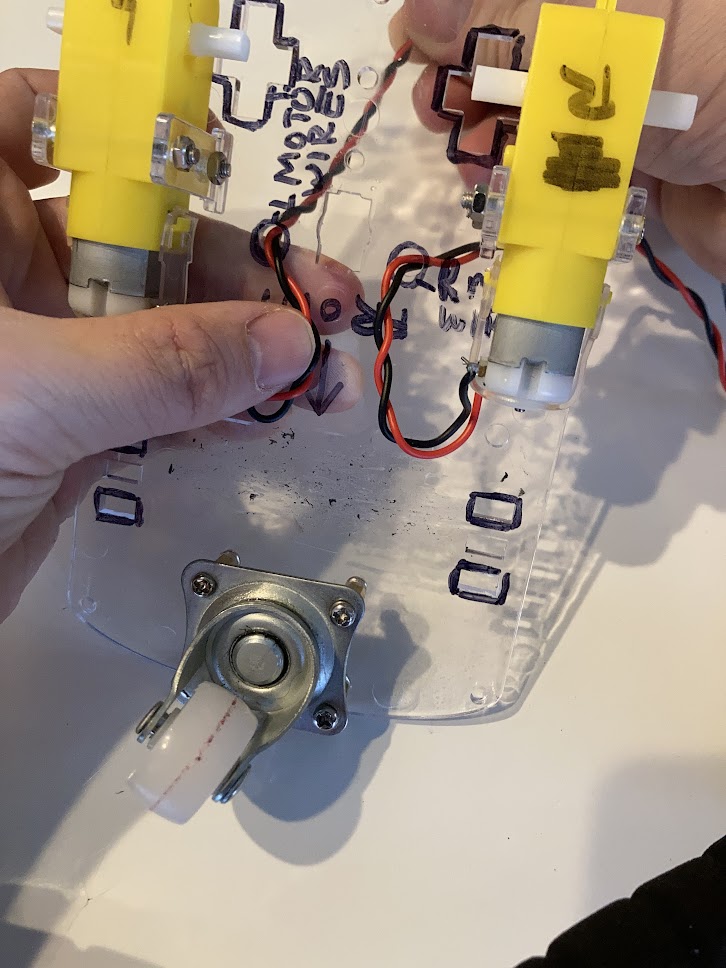
data/images/build-instructions/IMG_3716.JPG
