ScottMonaghan/robud-pi/data/images/build-instructions/IMG_3725.jpg

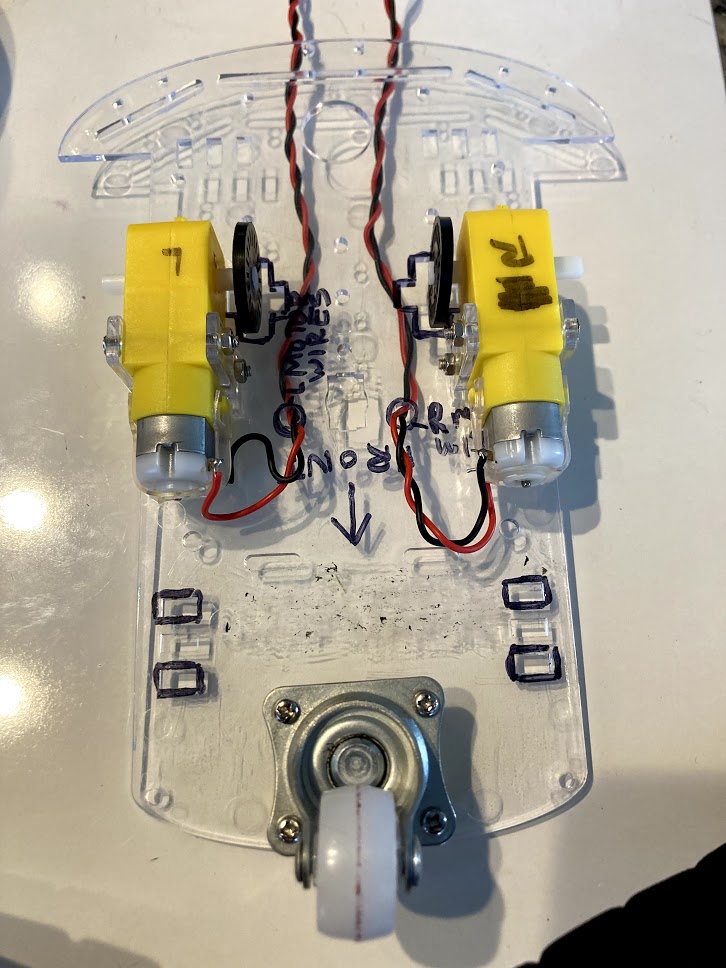
data/images/build-instructions/IMG_3725.jpg
