ScottMonaghan/robud-pi/data/images/build-instructions/IMG_3726.jpg

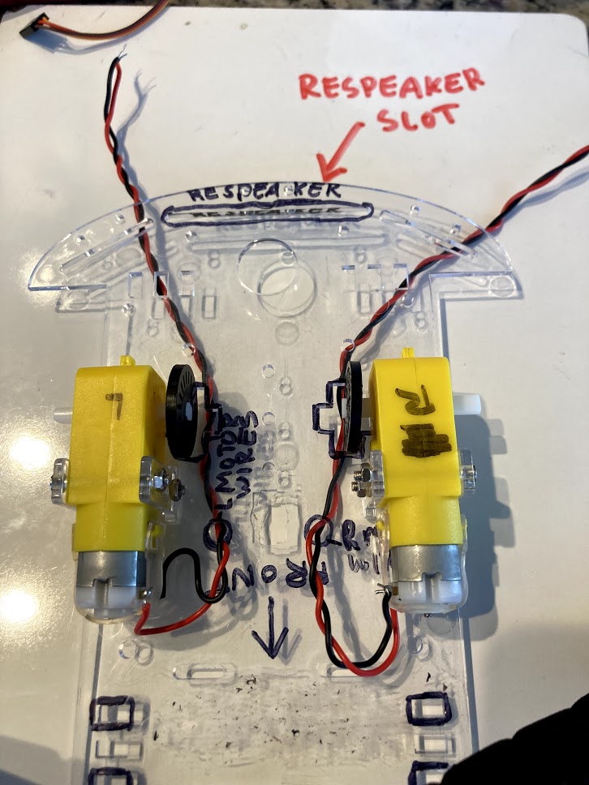
data/images/build-instructions/IMG_3726.jpg
