ScottMonaghan/robud-pi/data/images/build-instructions/IMG_3728.jpg

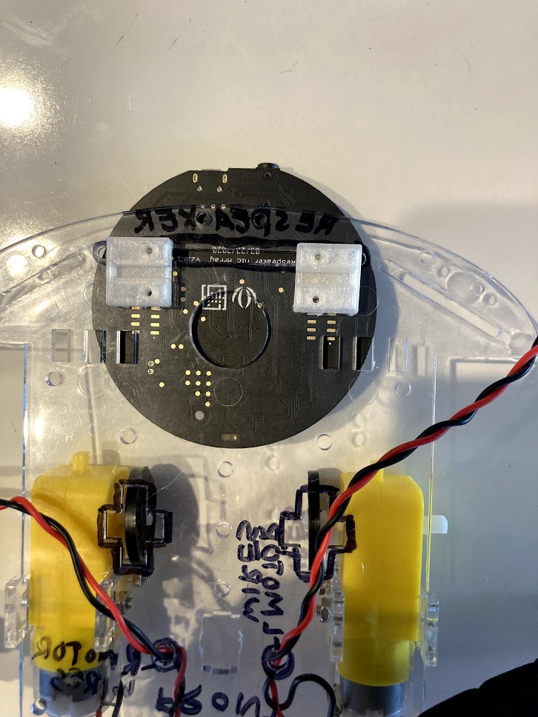
data/images/build-instructions/IMG_3728.jpg
