ScottMonaghan/robud-pi/data/images/build-instructions/IMG_3729.jpg

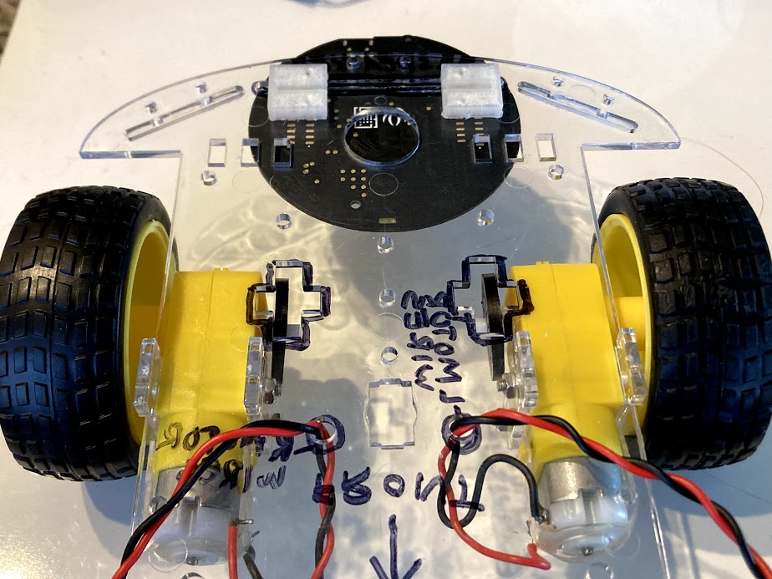
data/images/build-instructions/IMG_3729.jpg
