ScottMonaghan/robud-pi/data/images/build-instructions/IMG_3730.jpg

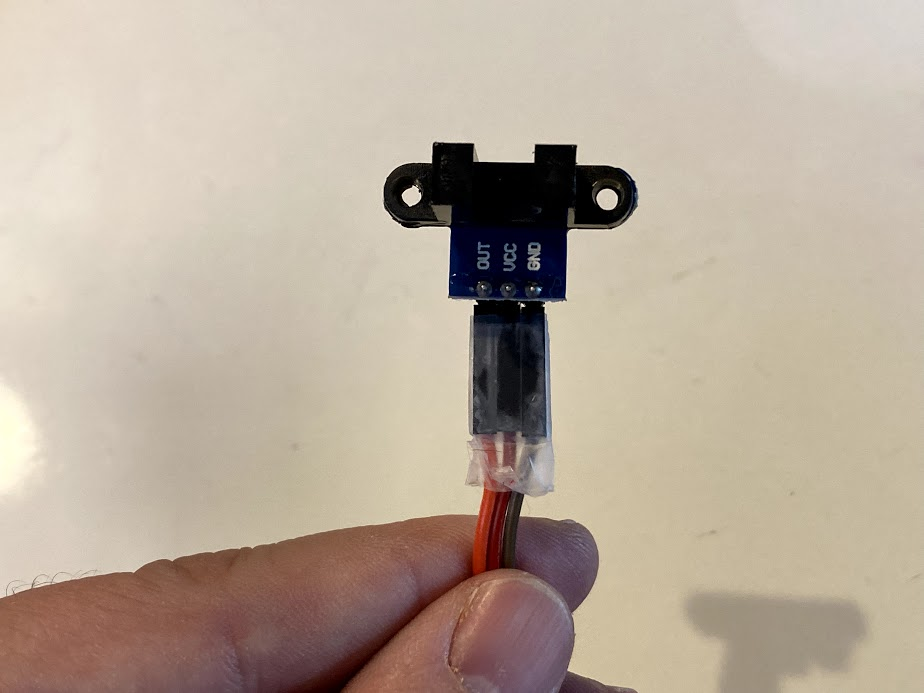
data/images/build-instructions/IMG_3730.jpg
