ScottMonaghan/robud-pi/data/images/build-instructions/IMG_3731.jpg

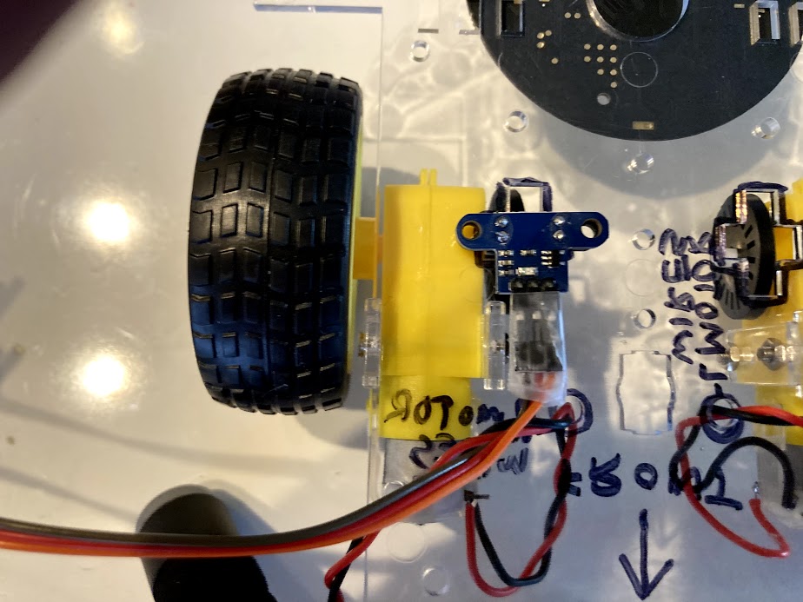
data/images/build-instructions/IMG_3731.jpg
