ScottMonaghan/robud-pi/data/images/build-instructions/IMG_3734.jpg

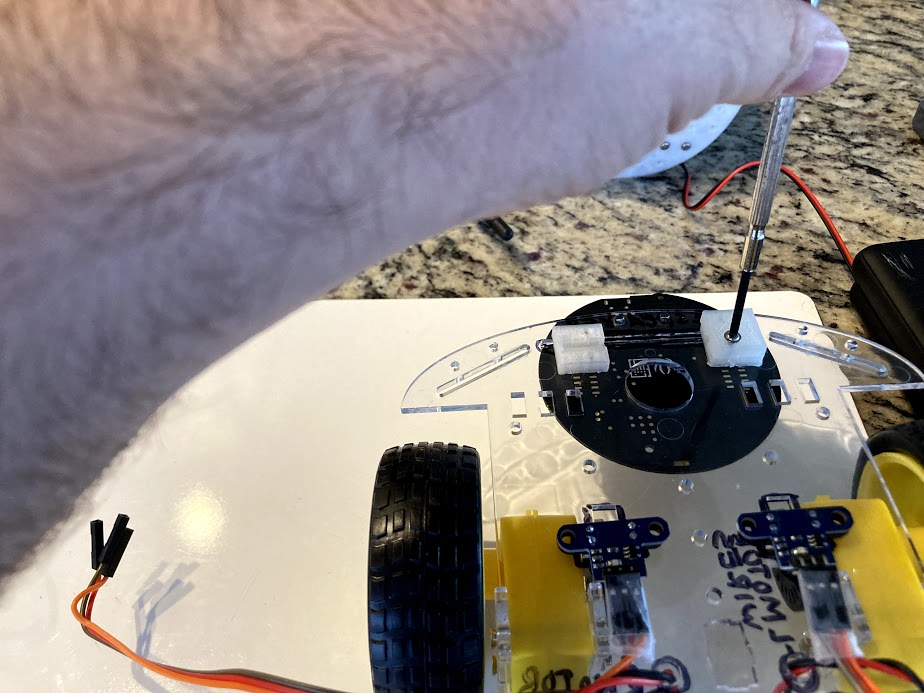
data/images/build-instructions/IMG_3734.jpg
