ScottMonaghan/robud-pi/data/images/build-instructions/IMG_3735.jpg

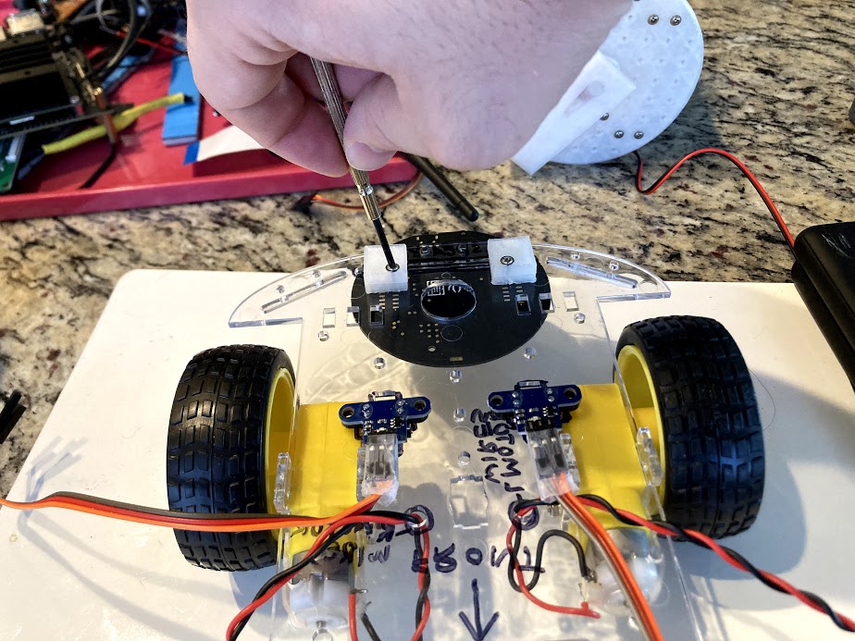
data/images/build-instructions/IMG_3735.jpg
