ScottMonaghan/robud-pi/data/images/build-instructions/IMG_3736.jpg

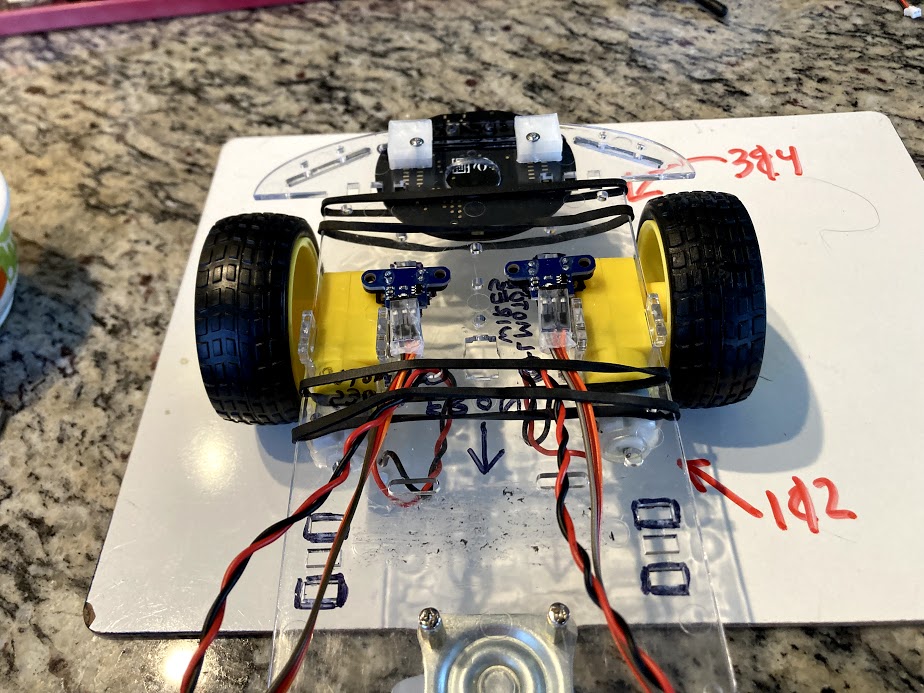
data/images/build-instructions/IMG_3736.jpg
