ScottMonaghan/robud-pi/data/images/build-instructions/IMG_3744.JPG

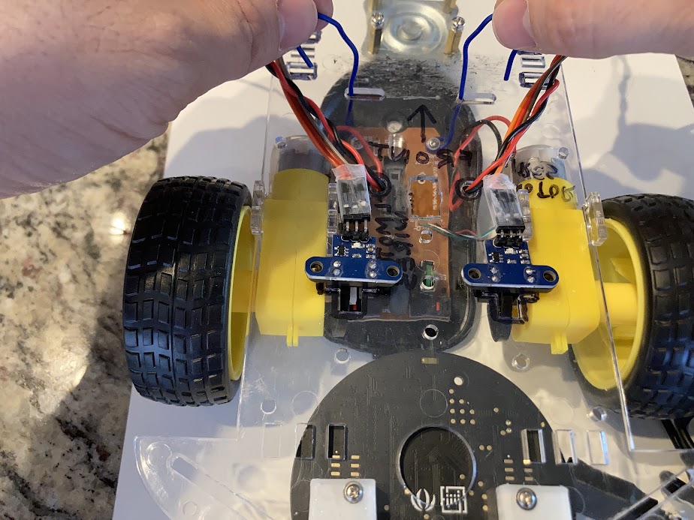
data/images/build-instructions/IMG_3744.JPG
