ScottMonaghan/robud-pi/data/images/build-instructions/IMG_3752.JPG

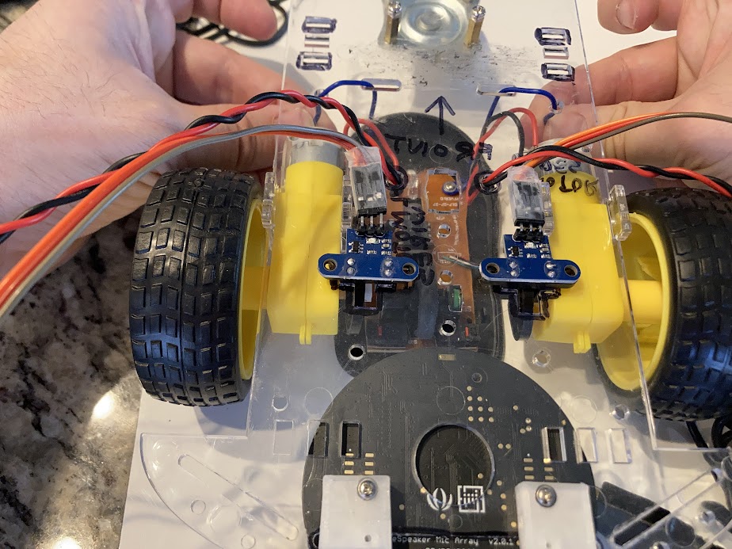
data/images/build-instructions/IMG_3752.JPG
