ScottMonaghan/robud-pi/data/images/build-instructions/IMG_3785.JPG

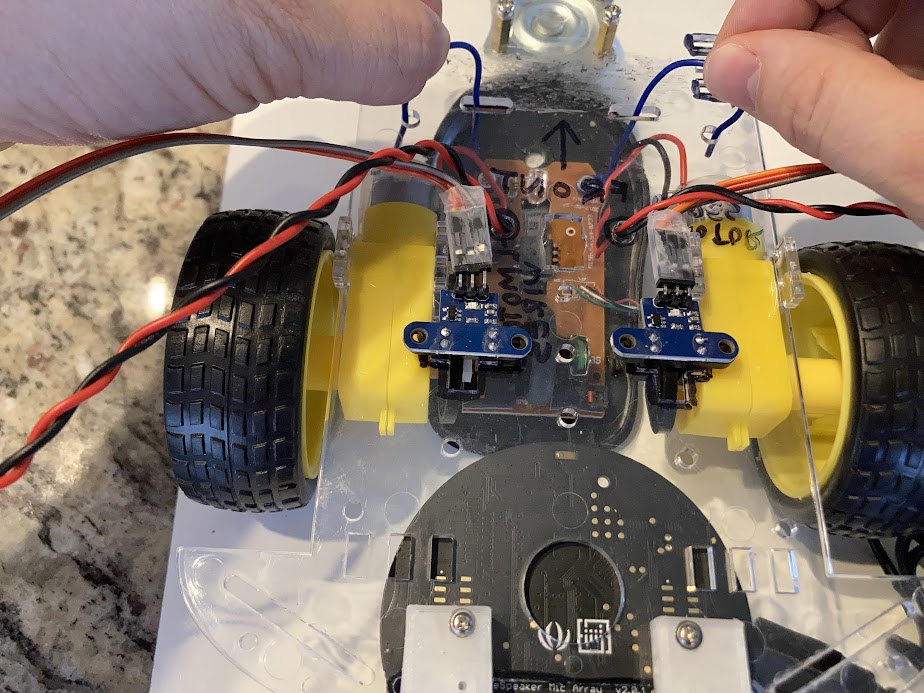
data/images/build-instructions/IMG_3785.JPG
