ScottMonaghan/robud-pi/data/images/build-instructions/IMG_3789.jpg

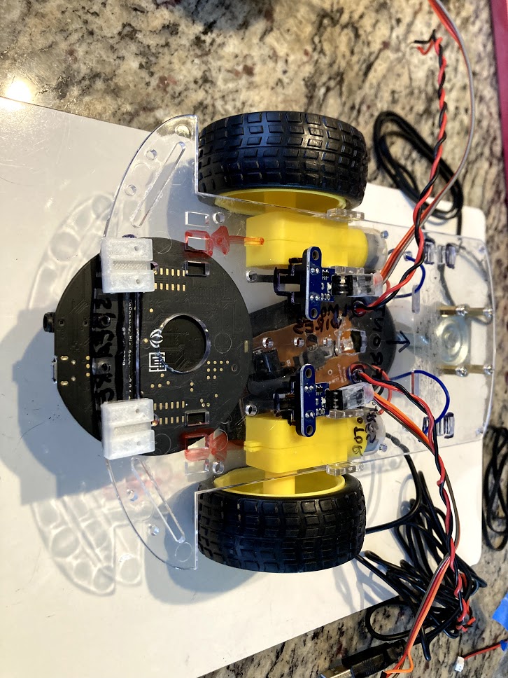
data/images/build-instructions/IMG_3789.jpg
