ScottMonaghan/robud-pi/data/images/build-instructions/IMG_3790.jpg

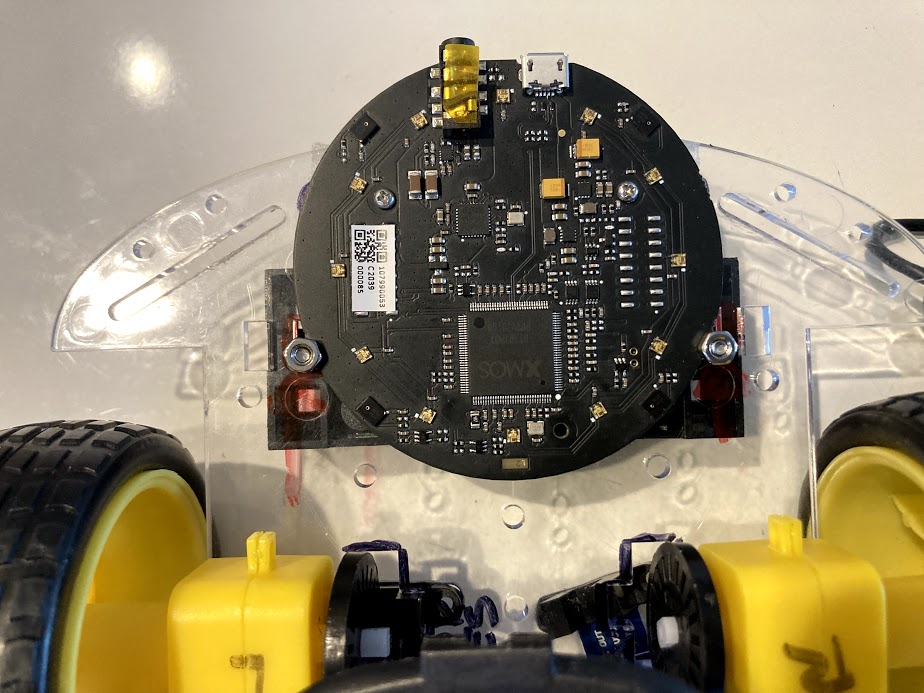
data/images/build-instructions/IMG_3790.jpg
