ScottMonaghan/robud-pi/data/images/build-instructions/IMG_3791.jpg

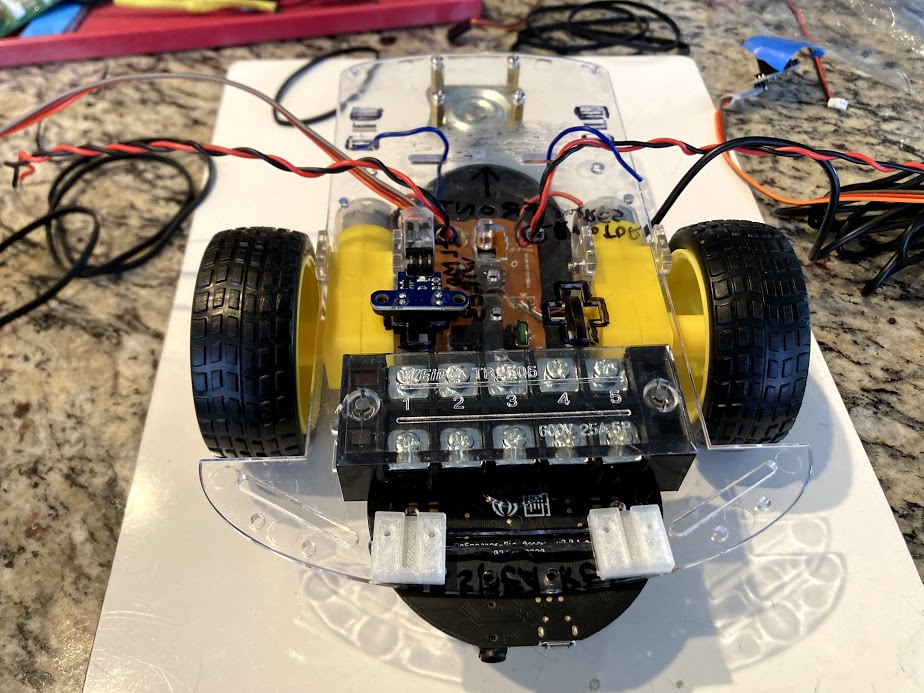
data/images/build-instructions/IMG_3791.jpg
