ScottMonaghan/robud-pi/data/images/build-instructions/IMG_3795.JPG

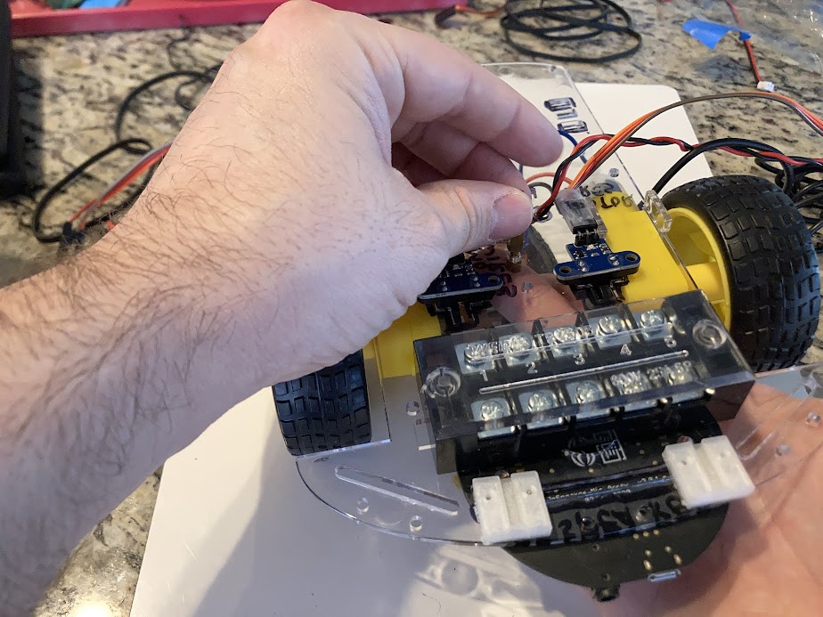
data/images/build-instructions/IMG_3795.JPG
