ScottMonaghan/robud-pi/data/images/build-instructions/IMG_3805.jpg

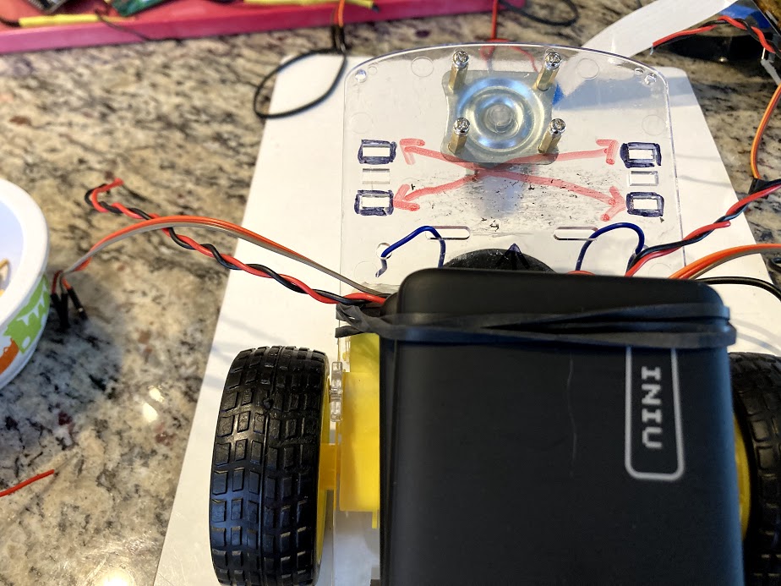
data/images/build-instructions/IMG_3805.jpg
