ScottMonaghan/robud-pi/data/images/build-instructions/IMG_3812.JPG

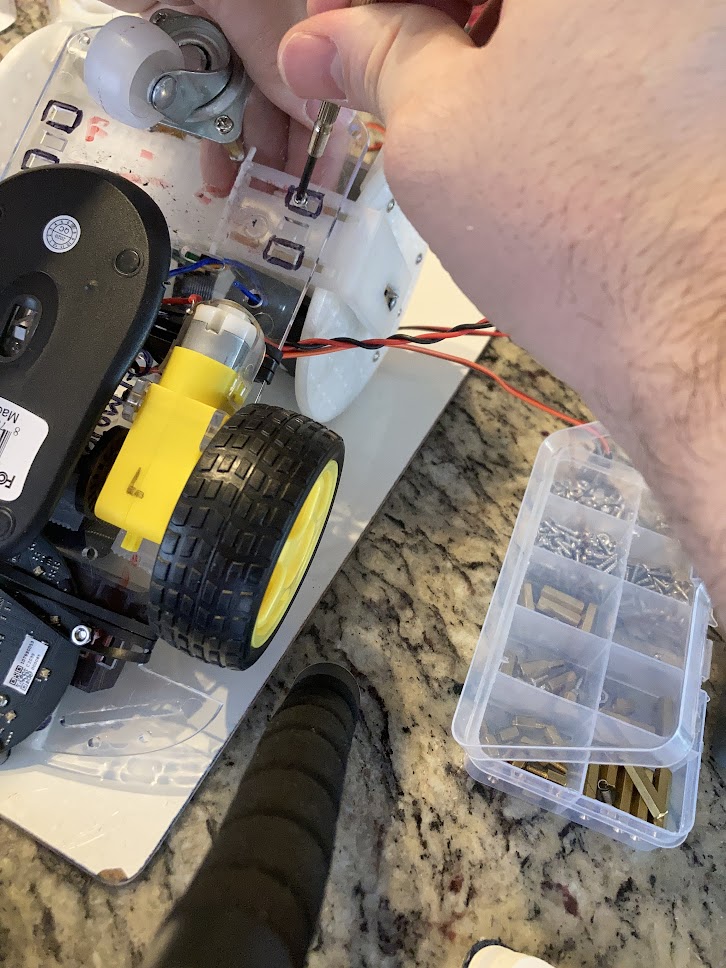
data/images/build-instructions/IMG_3812.JPG
