ScottMonaghan/robud-pi/data/images/build-instructions/IMG_3818.JPG

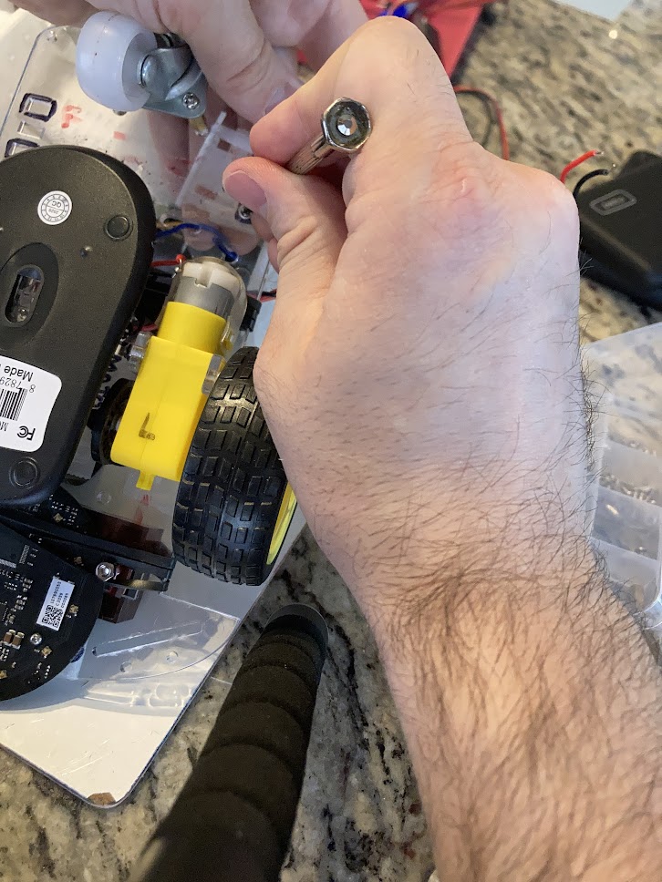
data/images/build-instructions/IMG_3818.JPG
