ScottMonaghan/robud-pi/data/images/build-instructions/IMG_3838.JPG

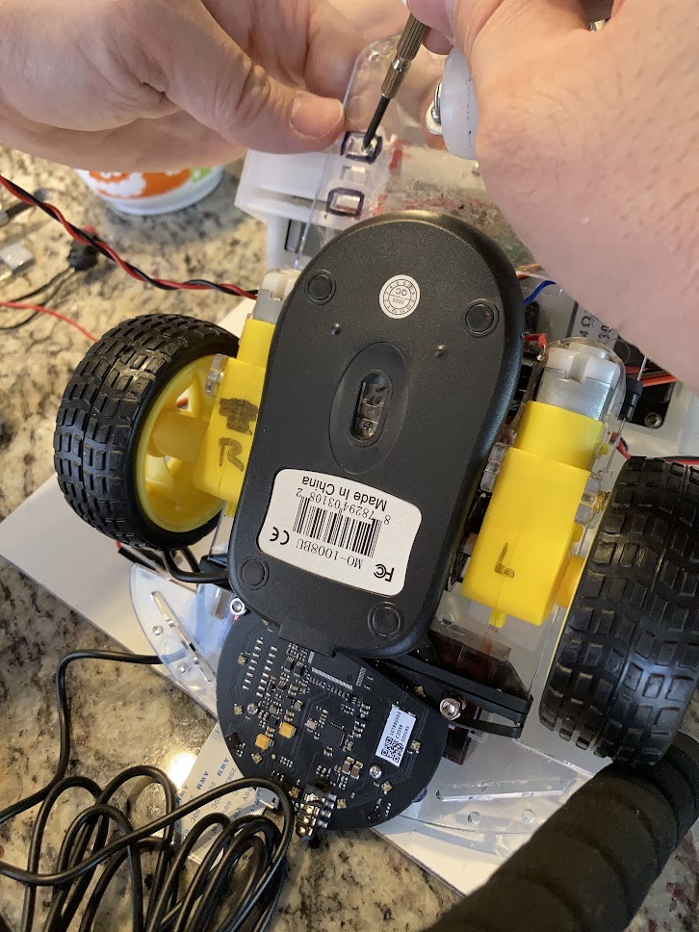
data/images/build-instructions/IMG_3838.JPG
