ScottMonaghan/robud-pi/data/images/build-instructions/IMG_3848.JPG

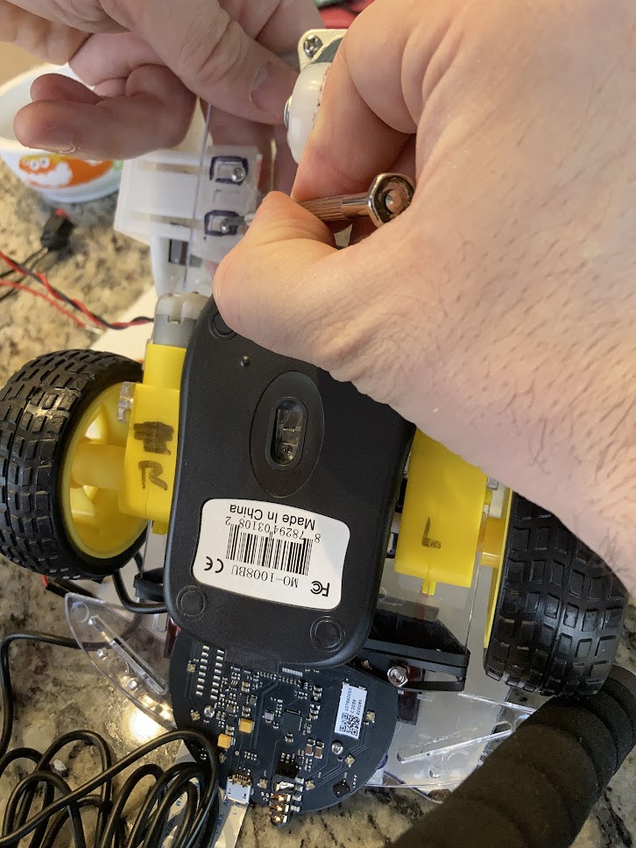
data/images/build-instructions/IMG_3848.JPG
