ScottMonaghan/robud-pi/data/images/build-instructions/IMG_3859.JPG

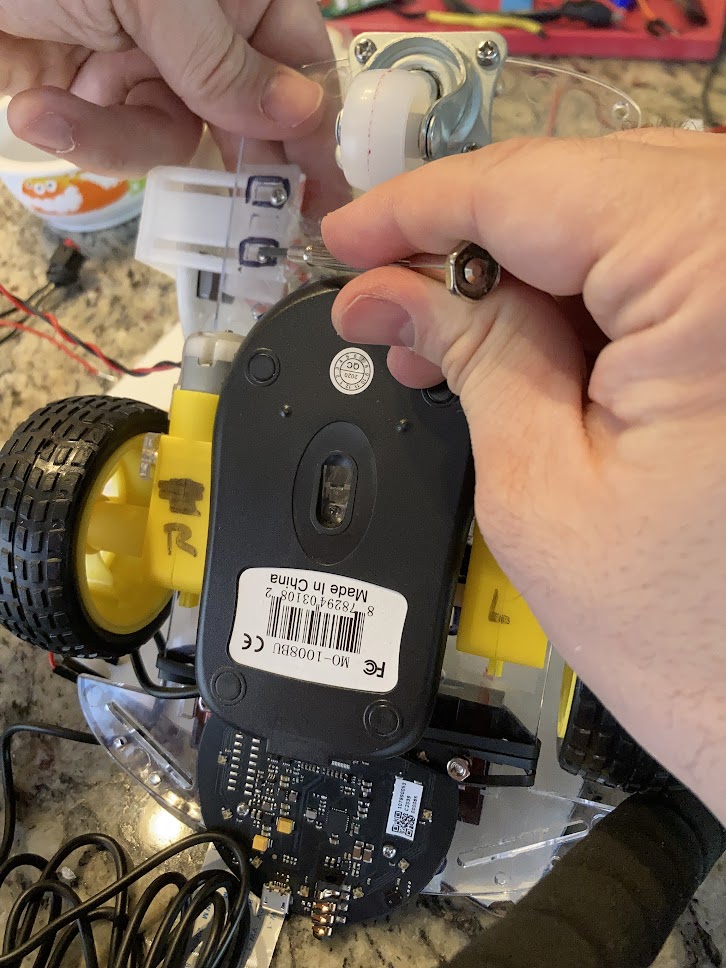
data/images/build-instructions/IMG_3859.JPG
