ScottMonaghan/robud-pi/data/images/build-instructions/IMG_3870.JPG

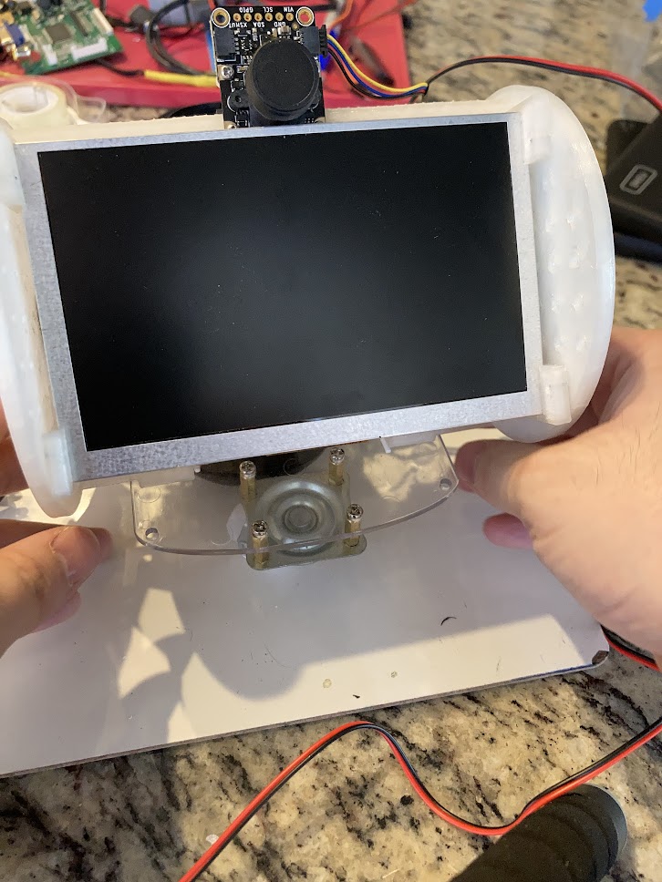
data/images/build-instructions/IMG_3870.JPG
