ScottMonaghan/robud-pi/data/images/build-instructions/IMG_3882.JPG

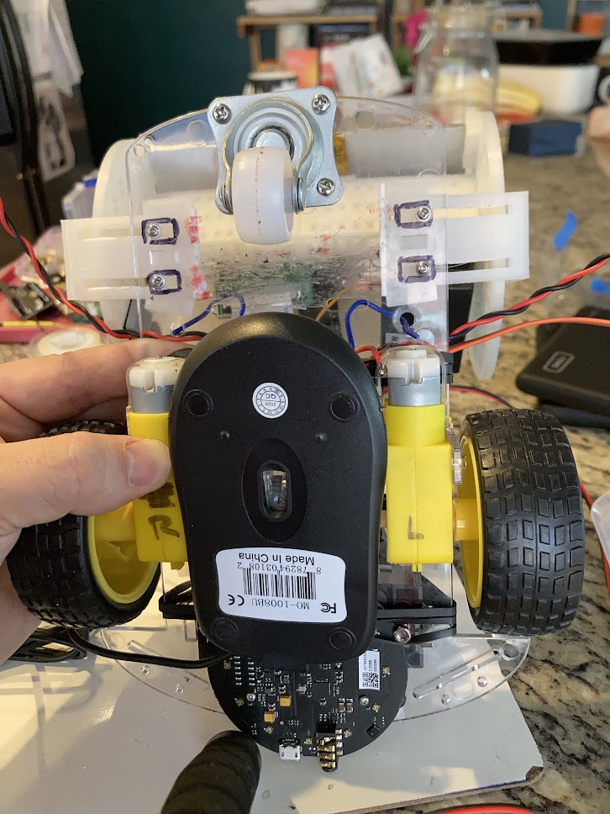
data/images/build-instructions/IMG_3882.JPG
