ScottMonaghan/robud-pi/data/images/build-instructions/IMG_3897.jpg

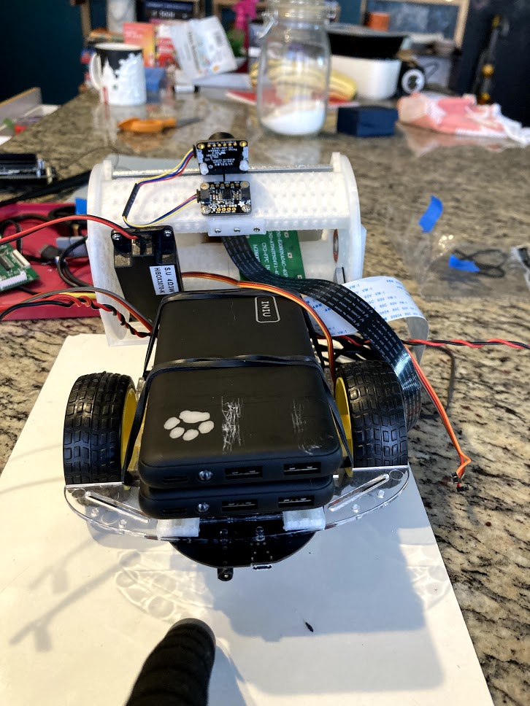
data/images/build-instructions/IMG_3897.jpg
