ScottMonaghan/robud-pi/data/images/build-instructions/IMG_3898.jpg

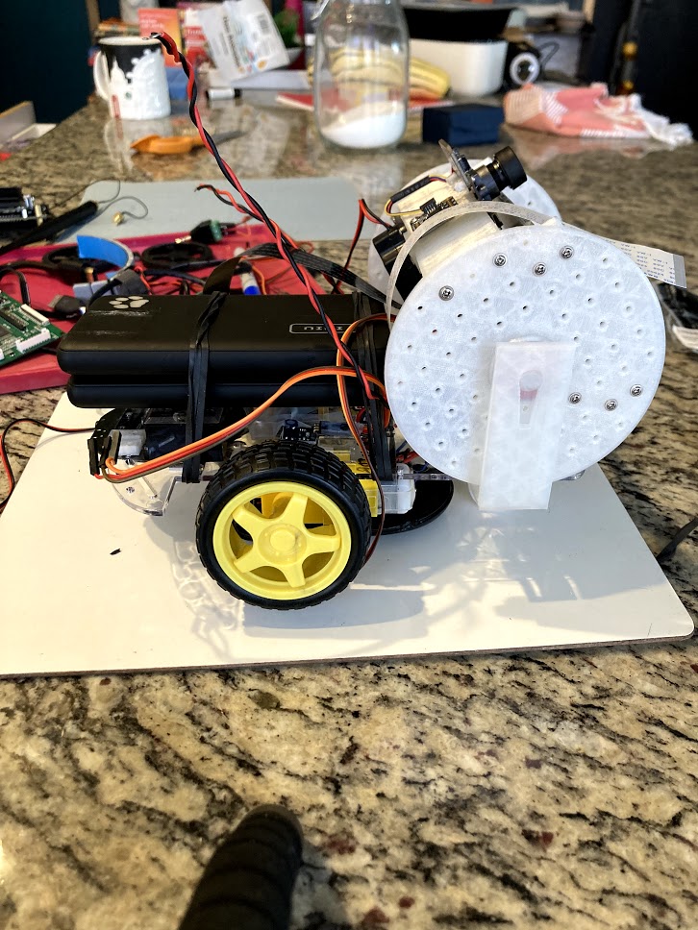
data/images/build-instructions/IMG_3898.jpg
