ScottMonaghan/robud-pi/data/images/build-instructions/IMG_3899.jpg

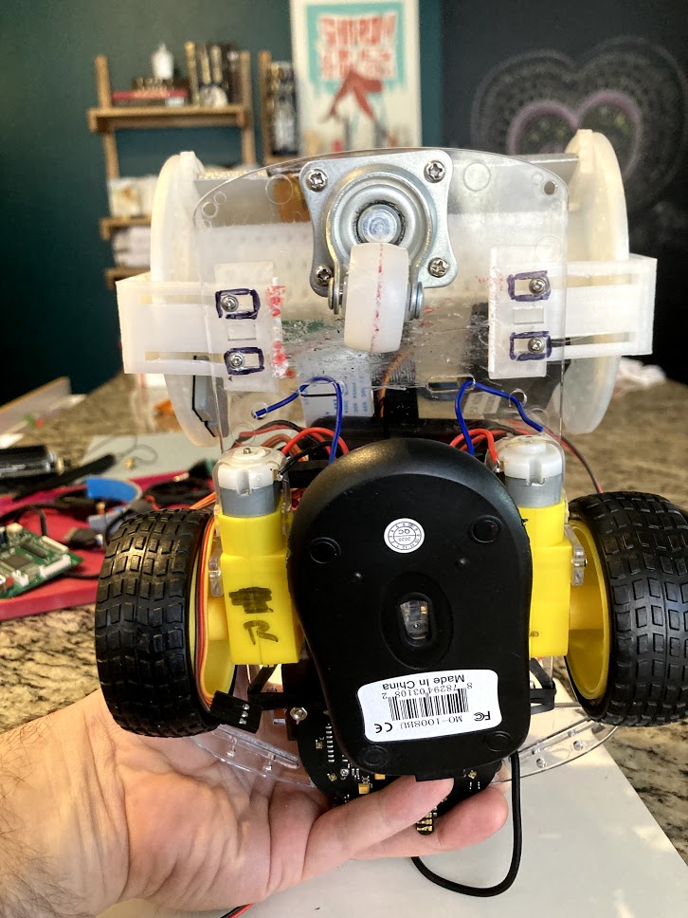
data/images/build-instructions/IMG_3899.jpg
