ScottMonaghan/robud-pi/data/images/build-instructions/IMG_3901.jpg

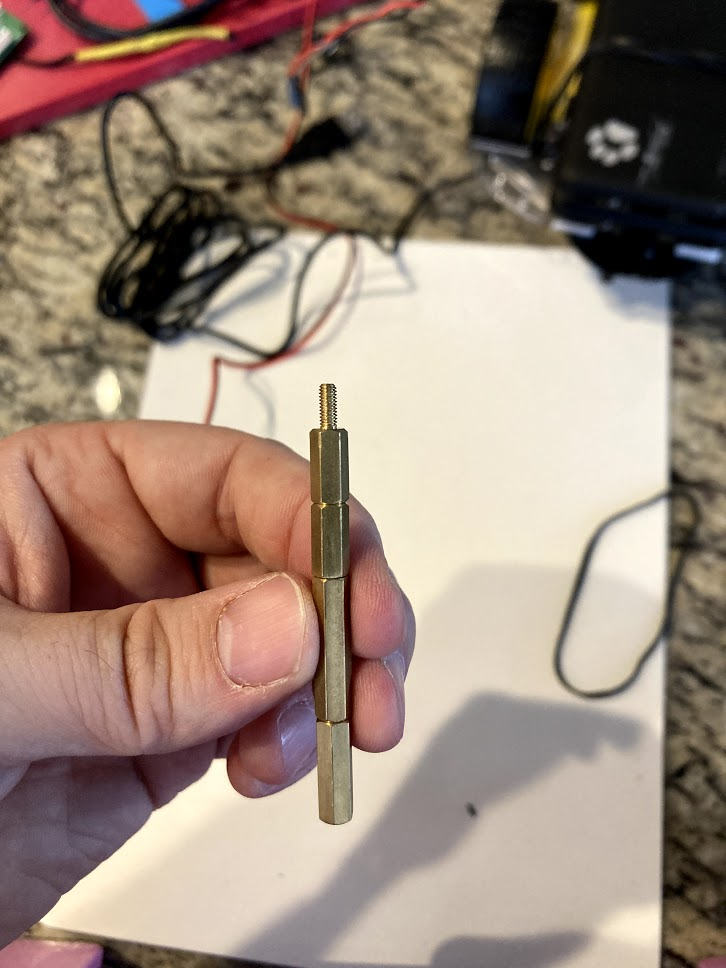
data/images/build-instructions/IMG_3901.jpg
