ScottMonaghan/robud-pi/data/images/build-instructions/IMG_3916.JPG

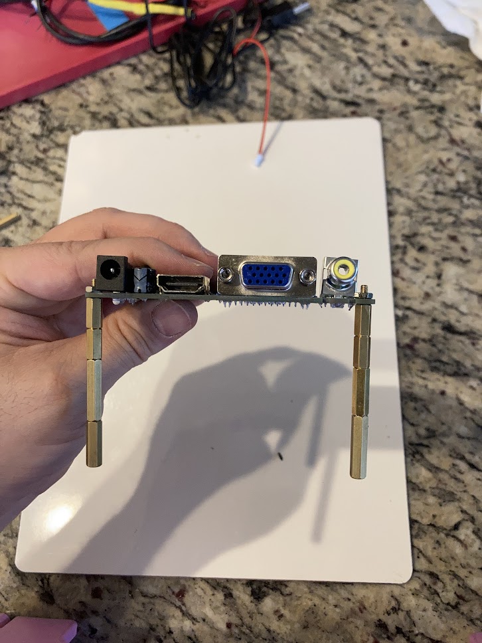
data/images/build-instructions/IMG_3916.JPG
