ScottMonaghan/robud-pi/data/images/build-instructions/IMG_3925.JPG

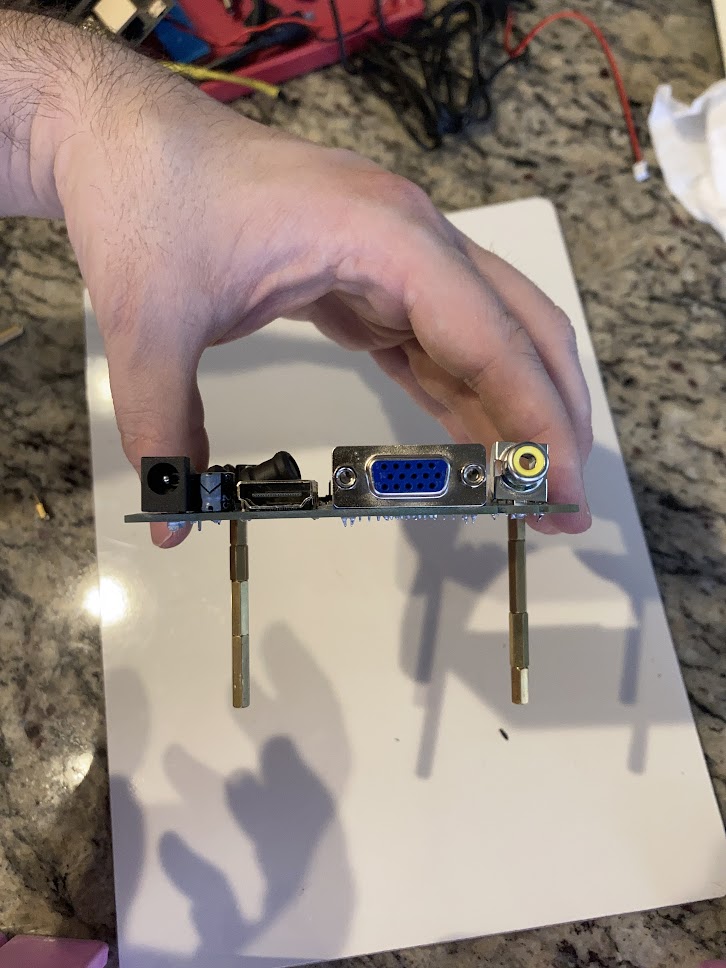
data/images/build-instructions/IMG_3925.JPG
