ScottMonaghan/robud-pi/data/images/build-instructions/IMG_3961.JPG

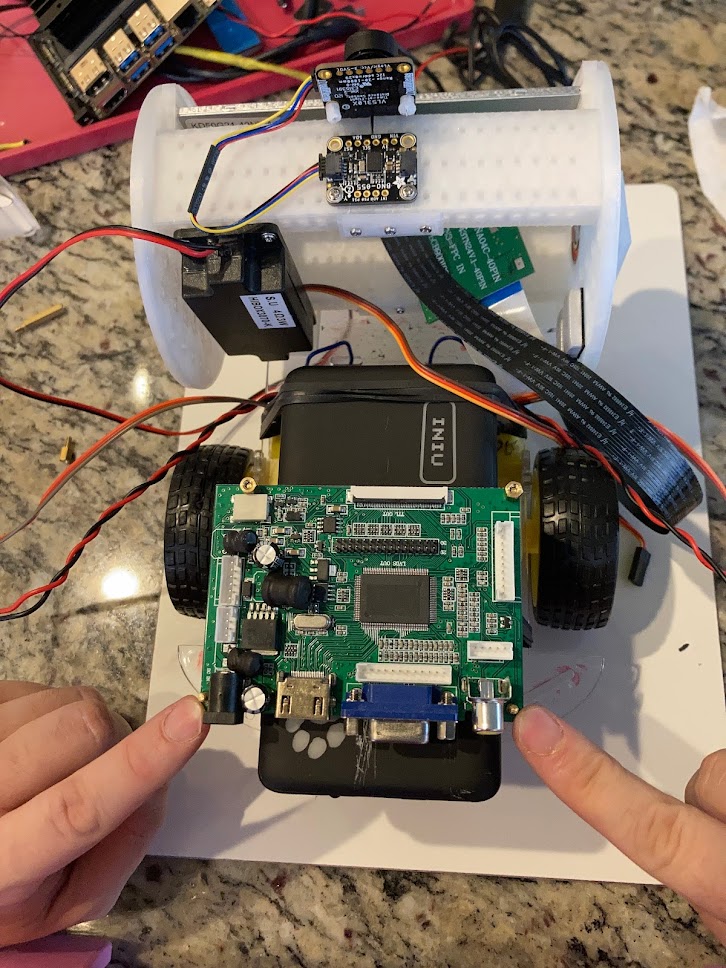
data/images/build-instructions/IMG_3961.JPG
