ScottMonaghan/robud-pi/data/images/build-instructions/IMG_4002.JPG

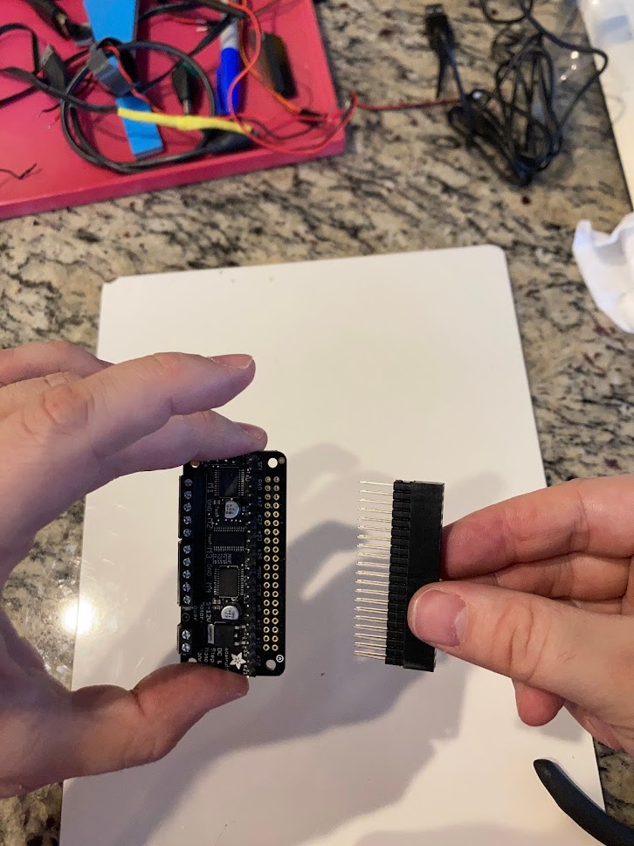
data/images/build-instructions/IMG_4002.JPG
