ScottMonaghan/robud-pi/data/images/build-instructions/IMG_4011.JPG

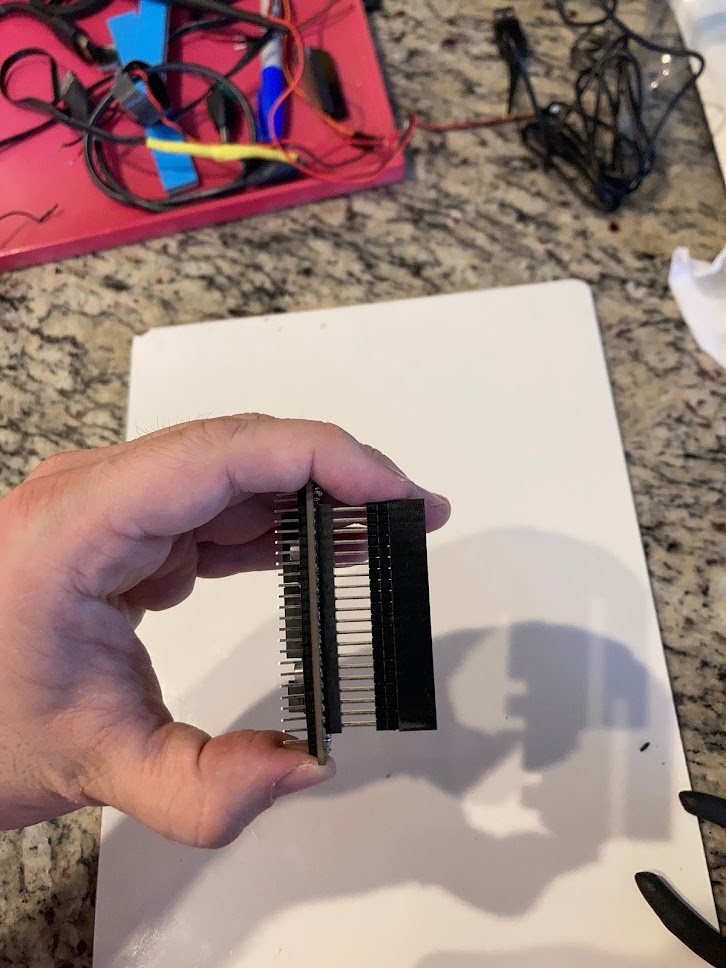
data/images/build-instructions/IMG_4011.JPG
