ScottMonaghan/robud-pi/data/images/build-instructions/IMG_4041.JPG

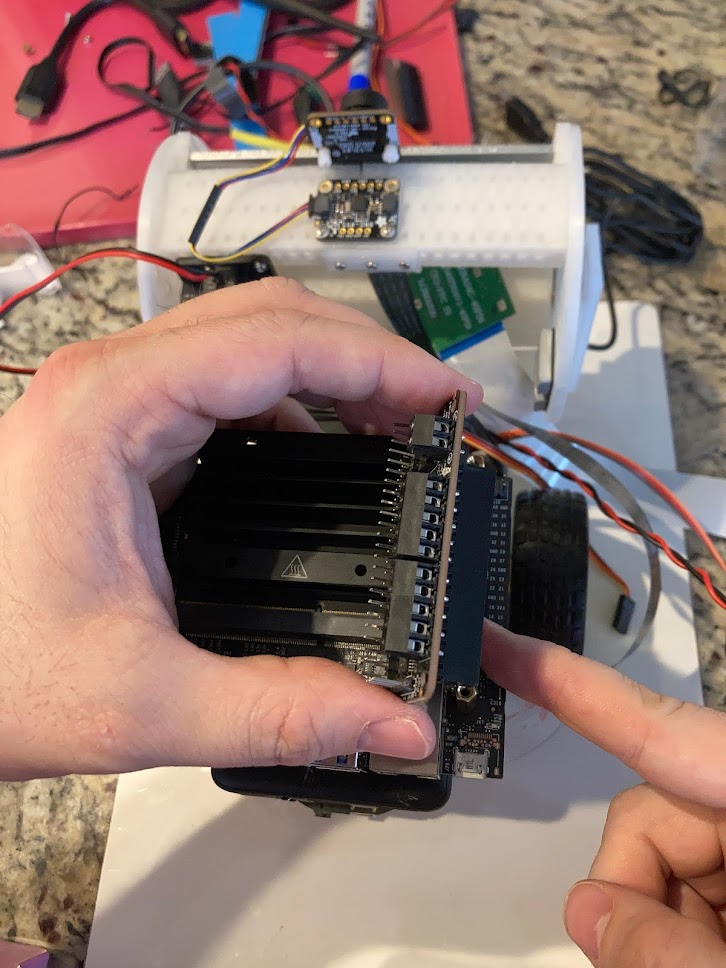
data/images/build-instructions/IMG_4041.JPG
