ScottMonaghan/robud-pi/data/images/build-instructions/IMG_4055.jpg

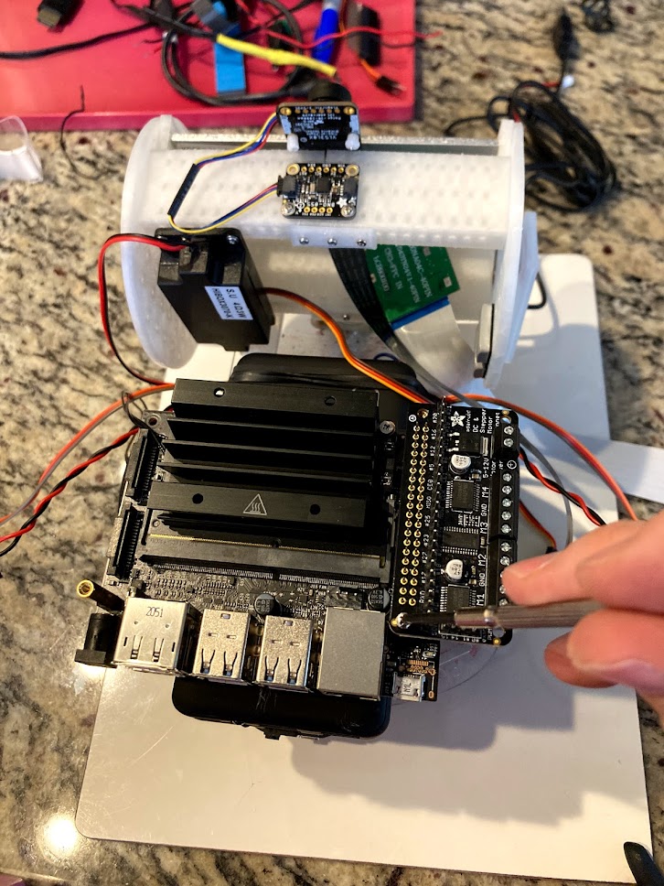
data/images/build-instructions/IMG_4055.jpg
