ScottMonaghan/robud-pi/data/images/build-instructions/IMG_4056.jpg

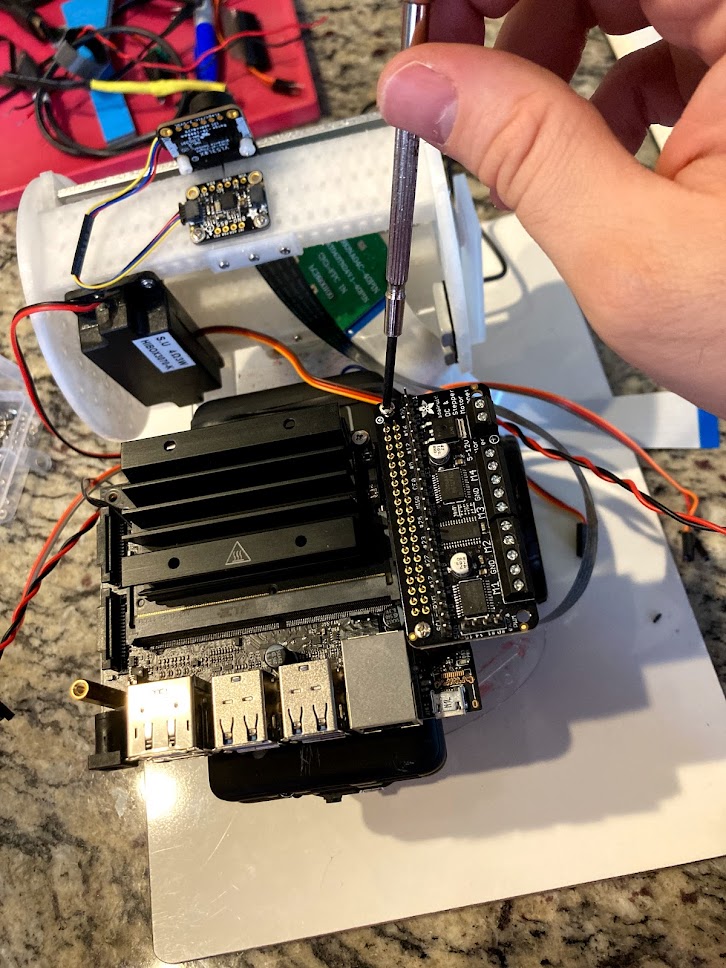
data/images/build-instructions/IMG_4056.jpg
