ScottMonaghan/robud-pi/data/images/build-instructions/IMG_4057.jpg

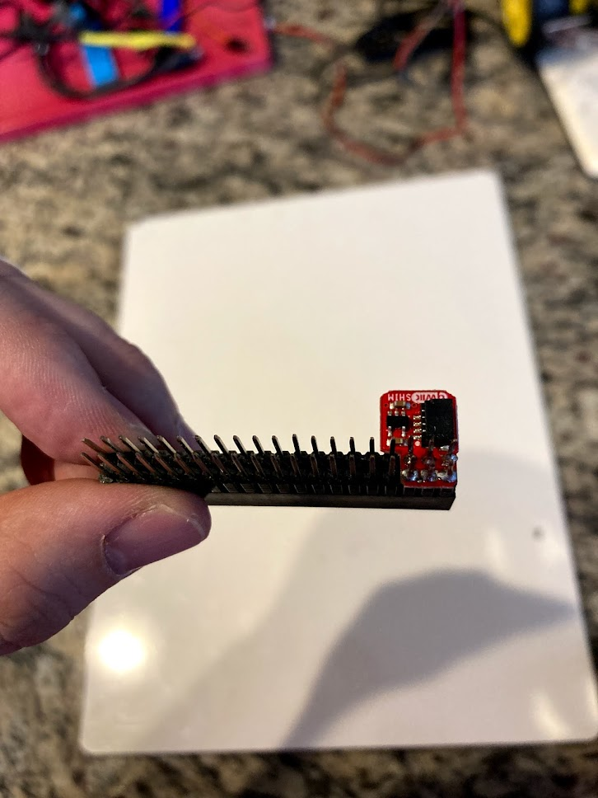
data/images/build-instructions/IMG_4057.jpg
