ScottMonaghan/robud-pi/data/images/build-instructions/IMG_4058.jpg

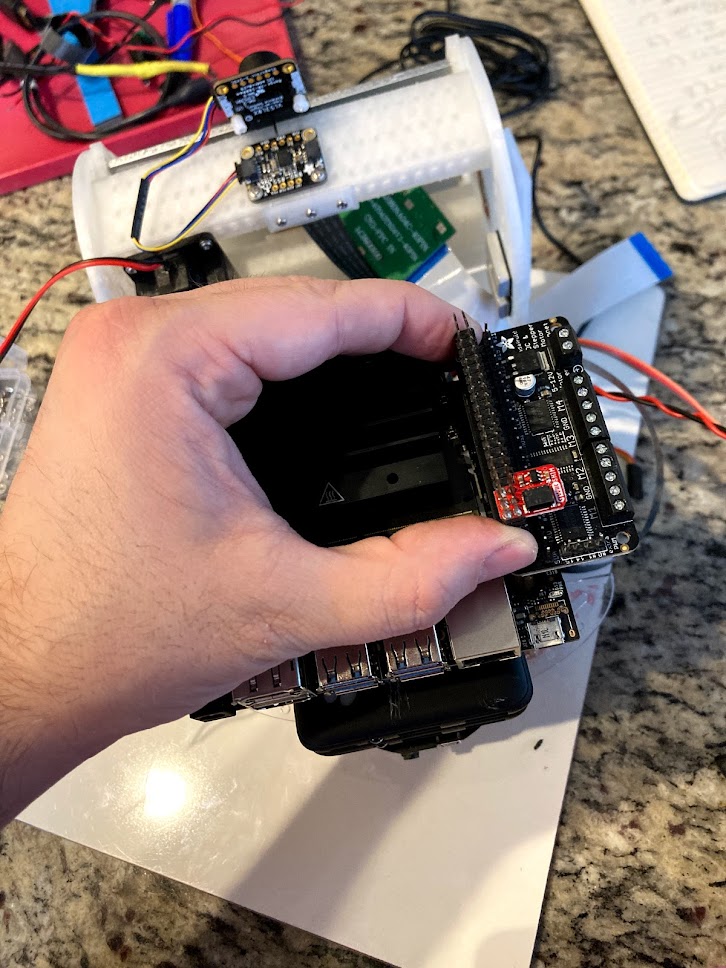
data/images/build-instructions/IMG_4058.jpg
