ScottMonaghan/robud-pi/data/images/build-instructions/IMG_4059.jpg

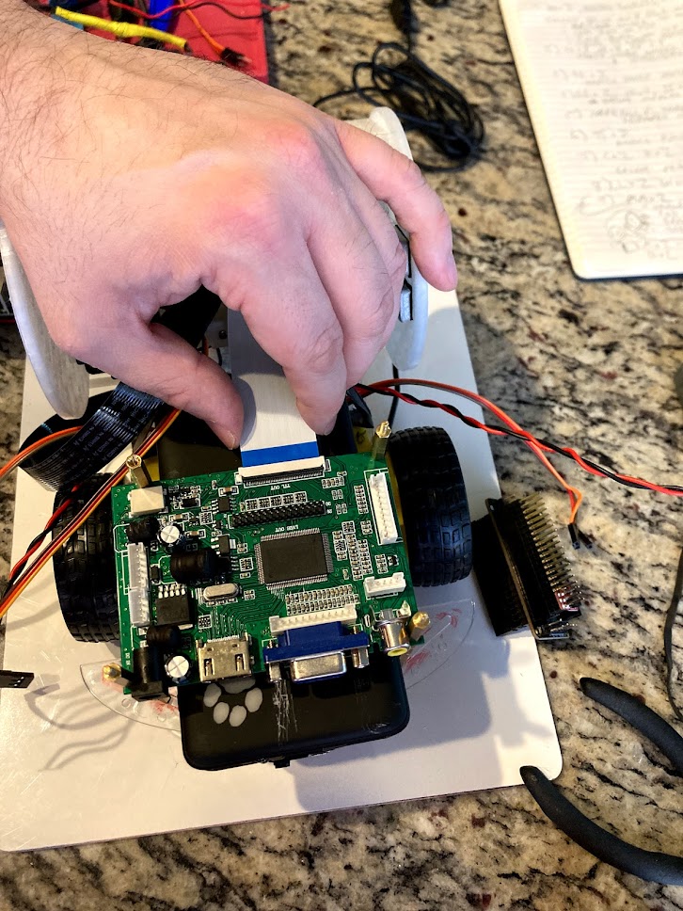
data/images/build-instructions/IMG_4059.jpg
