ScottMonaghan/robud-pi/data/images/build-instructions/IMG_4061.jpg

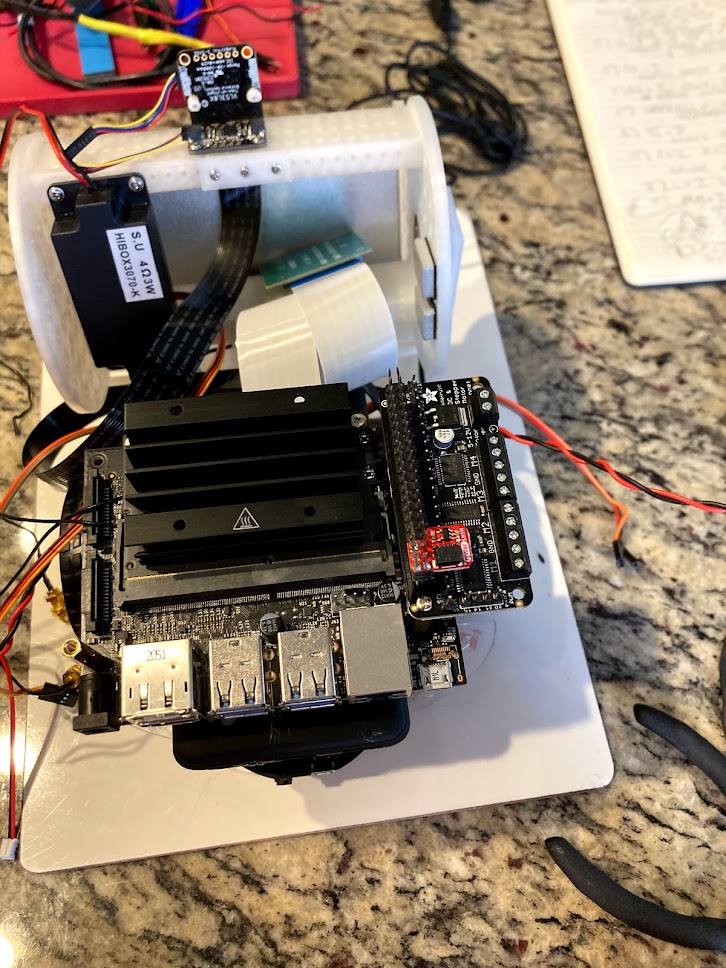
data/images/build-instructions/IMG_4061.jpg
