ScottMonaghan/robud-pi/data/images/build-instructions/IMG_4063.jpg

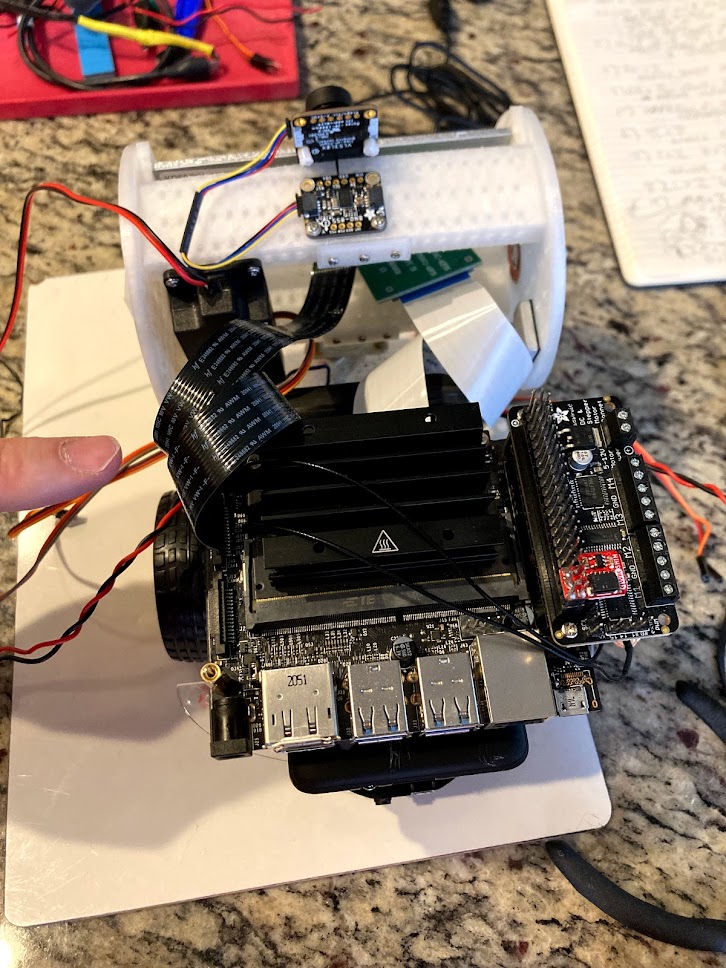
data/images/build-instructions/IMG_4063.jpg
