ScottMonaghan/robud-pi/data/images/build-instructions/IMG_4064.jpg

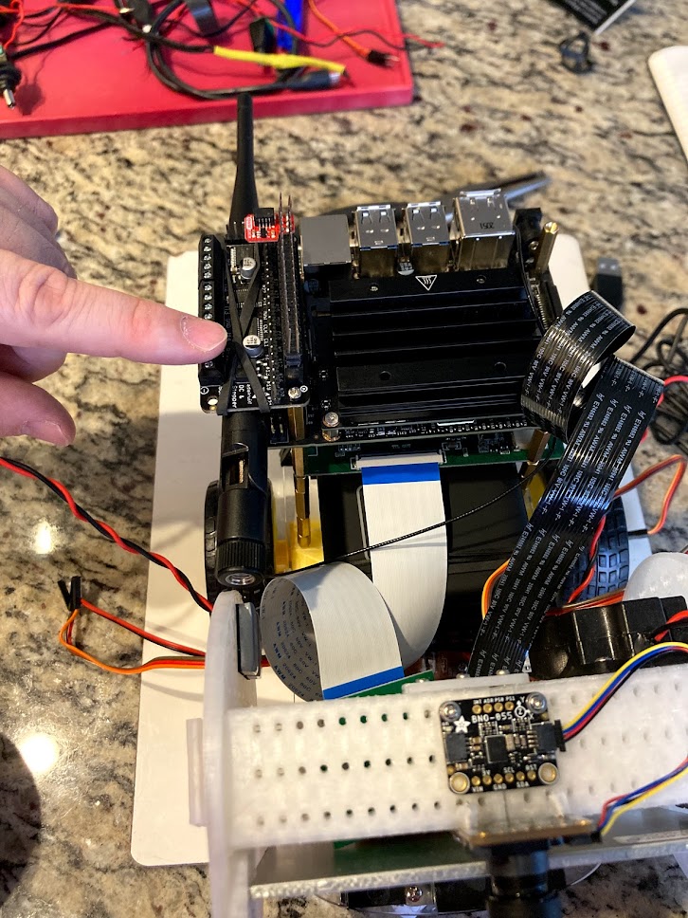
data/images/build-instructions/IMG_4064.jpg
