ScottMonaghan/robud-pi/data/images/build-instructions/IMG_4067.jpg

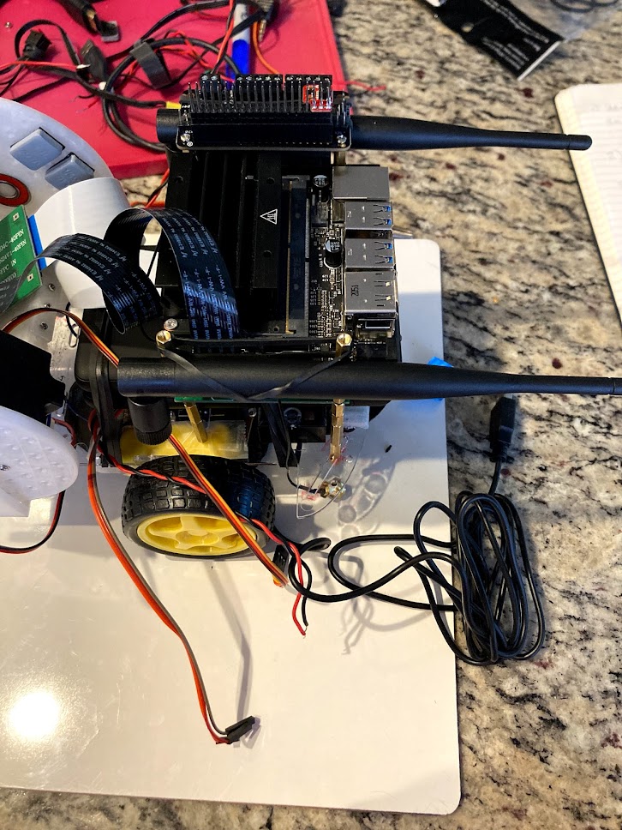
data/images/build-instructions/IMG_4067.jpg
