ScottMonaghan/robud-pi/data/images/build-instructions/IMG_4068.jpg

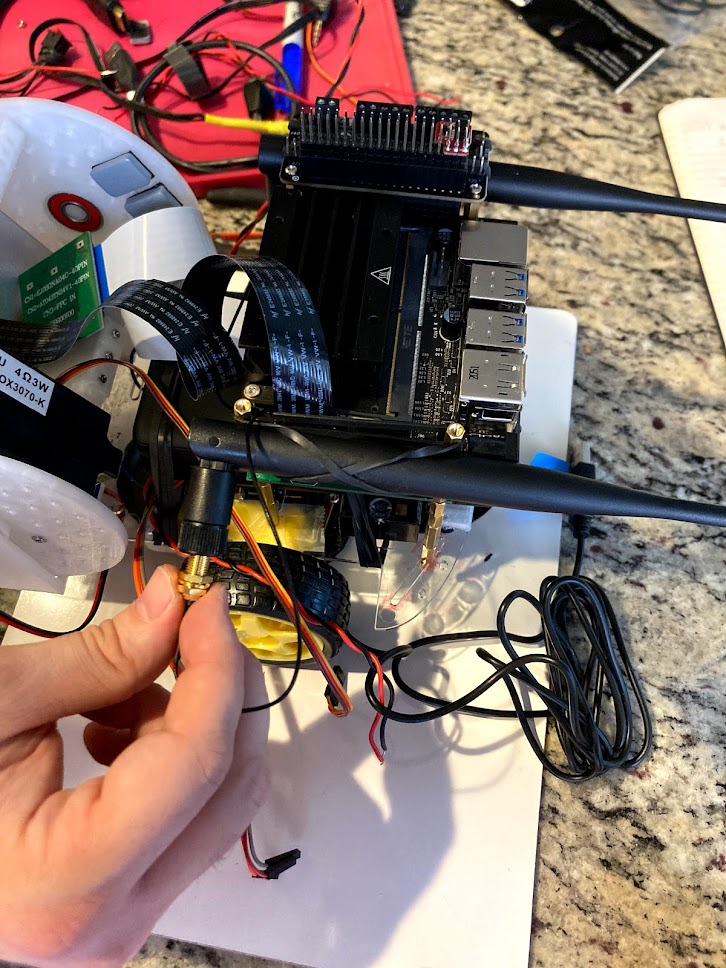
data/images/build-instructions/IMG_4068.jpg
