ScottMonaghan/robud-pi/data/images/build-instructions/IMG_4069.jpg

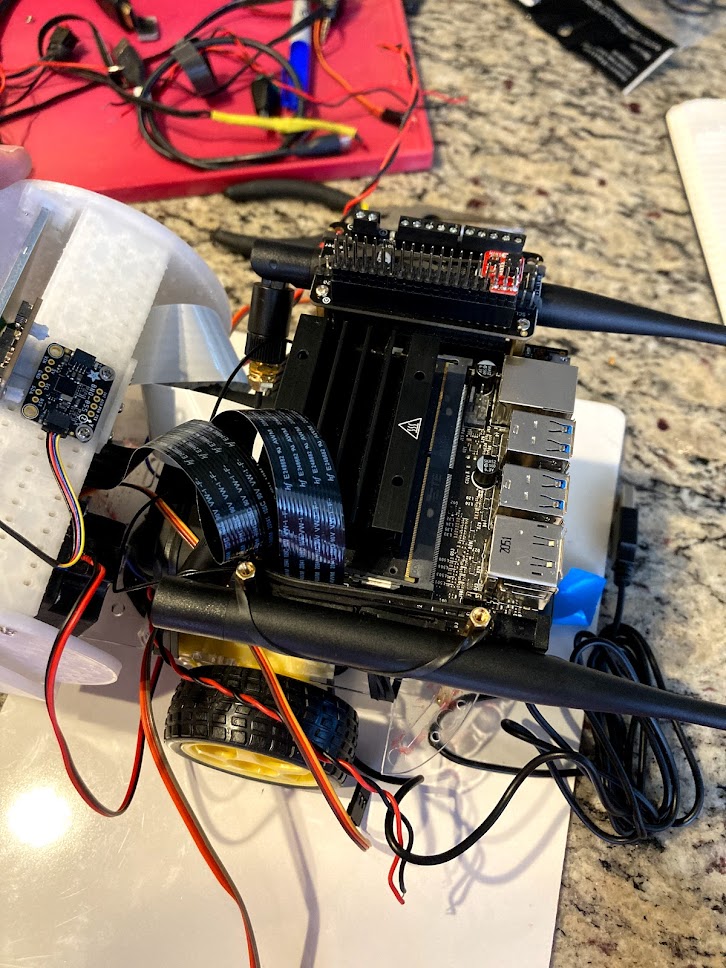
data/images/build-instructions/IMG_4069.jpg
