ScottMonaghan/robud-pi/data/images/build-instructions/IMG_4070.jpg

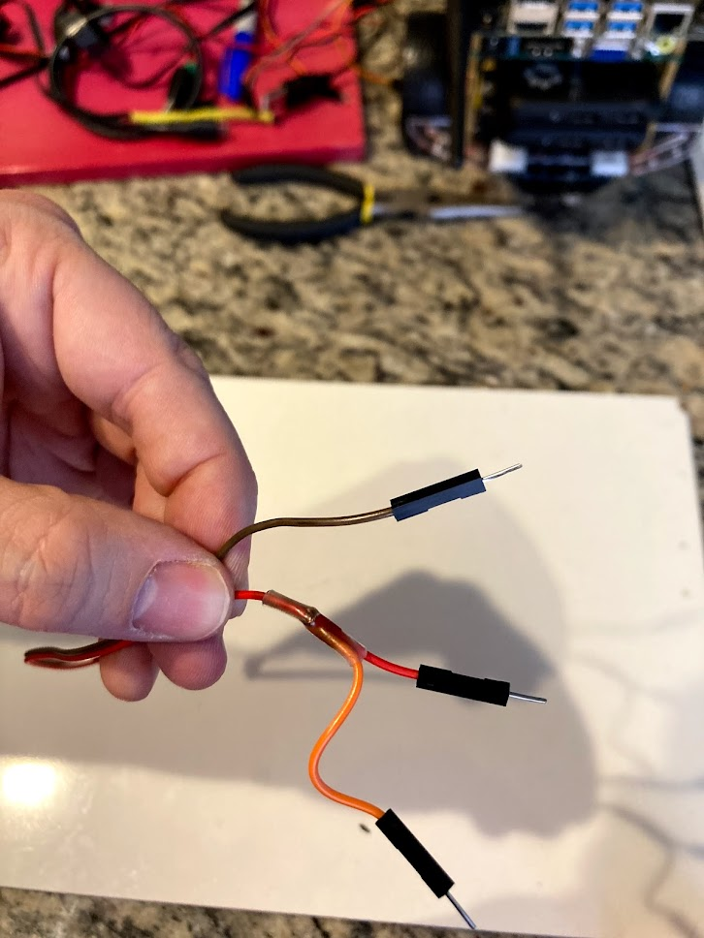
data/images/build-instructions/IMG_4070.jpg
