ScottMonaghan/robud-pi/data/images/build-instructions/IMG_4071.jpg

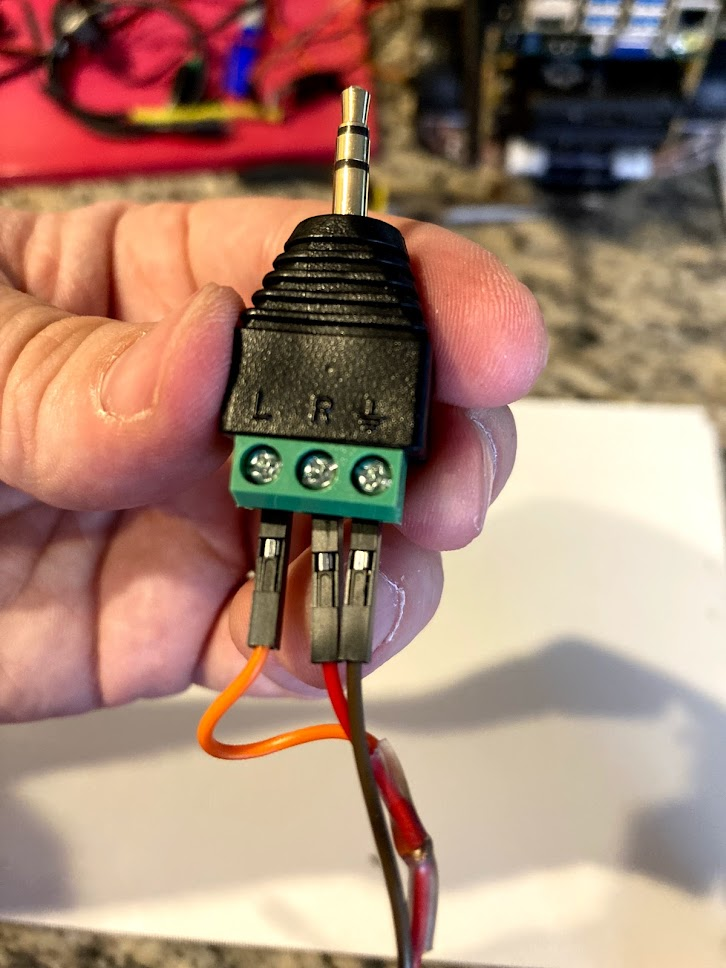
data/images/build-instructions/IMG_4071.jpg
