ScottMonaghan/robud-pi/data/images/build-instructions/IMG_4074.jpg

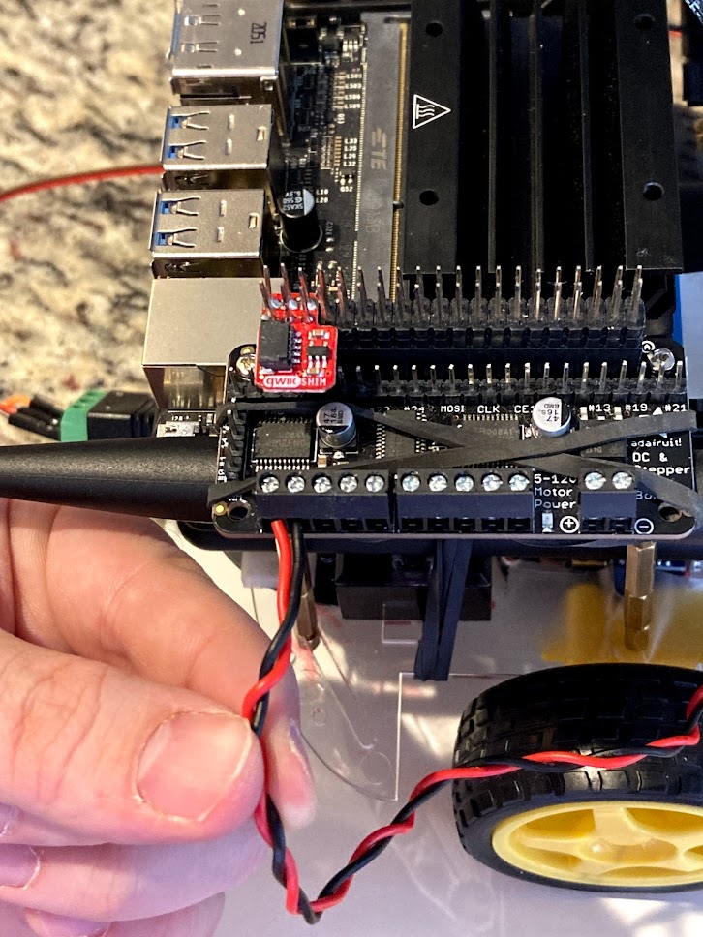
data/images/build-instructions/IMG_4074.jpg
