ScottMonaghan/robud-pi/data/images/build-instructions/IMG_4075.jpg

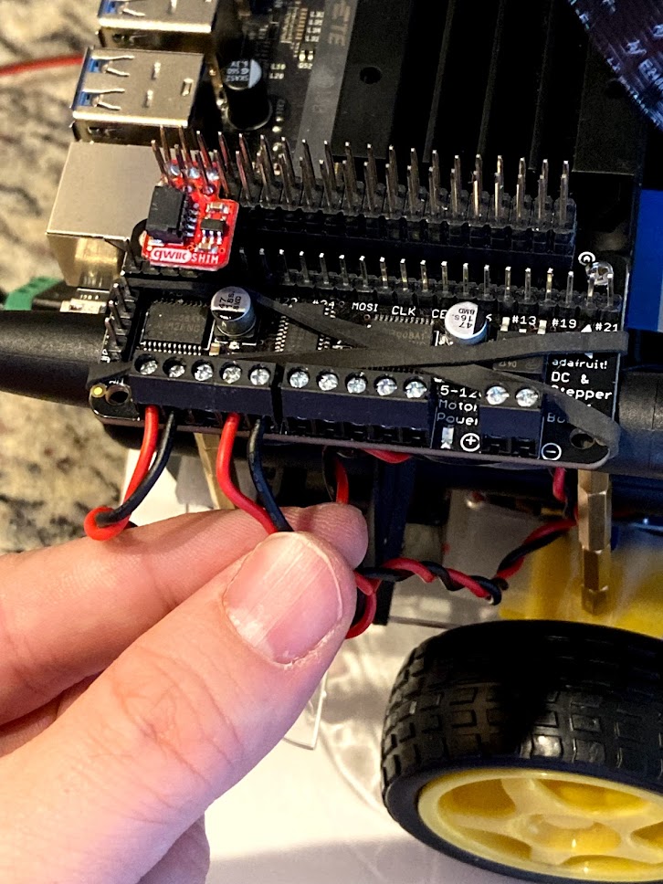
data/images/build-instructions/IMG_4075.jpg
