ScottMonaghan/robud-pi/data/images/build-instructions/IMG_4076.jpg

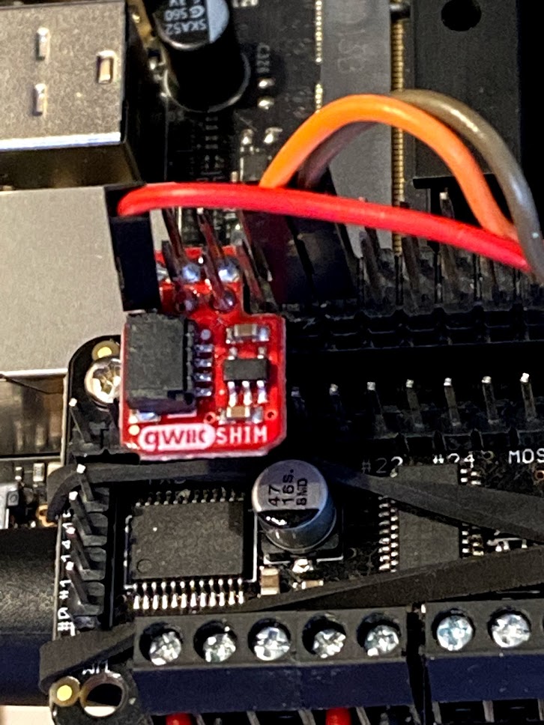
data/images/build-instructions/IMG_4076.jpg
