ScottMonaghan/robud-pi/data/images/build-instructions/IMG_4080.jpg

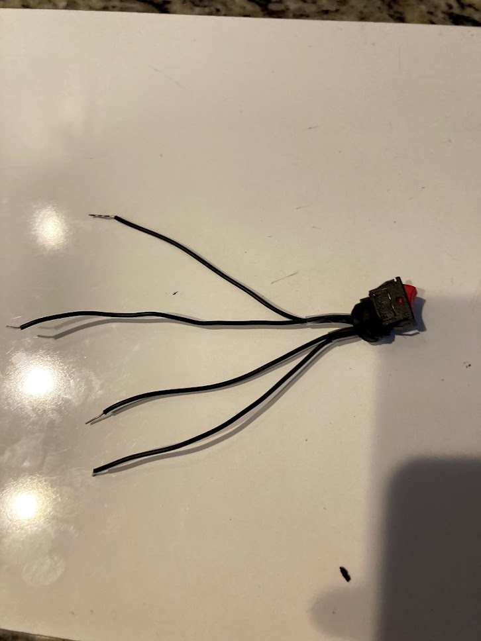
data/images/build-instructions/IMG_4080.jpg
