ScottMonaghan/robud-pi/data/images/build-instructions/IMG_4081.jpg

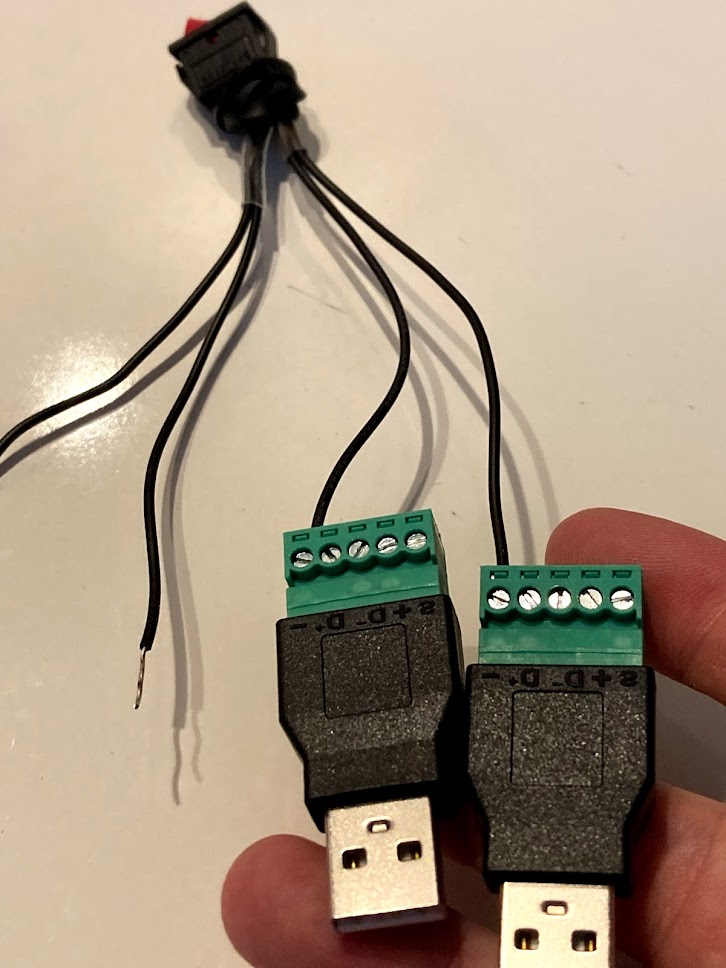
data/images/build-instructions/IMG_4081.jpg
