ScottMonaghan/robud-pi/data/images/build-instructions/IMG_4082.jpg

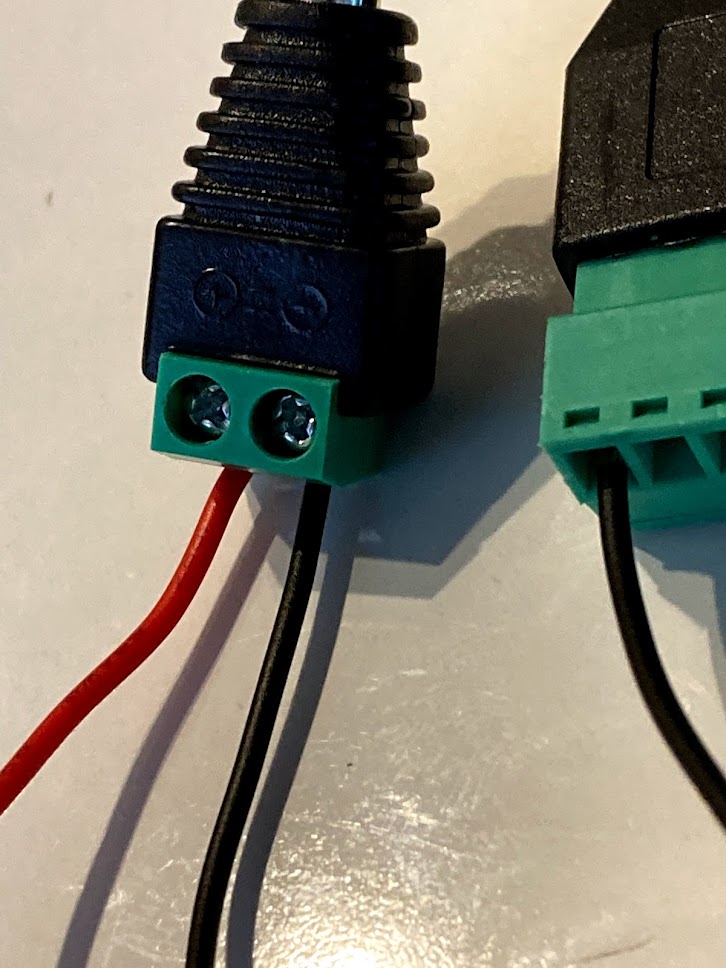
data/images/build-instructions/IMG_4082.jpg
