ScottMonaghan/robud-pi/data/images/build-instructions/IMG_4083.jpg

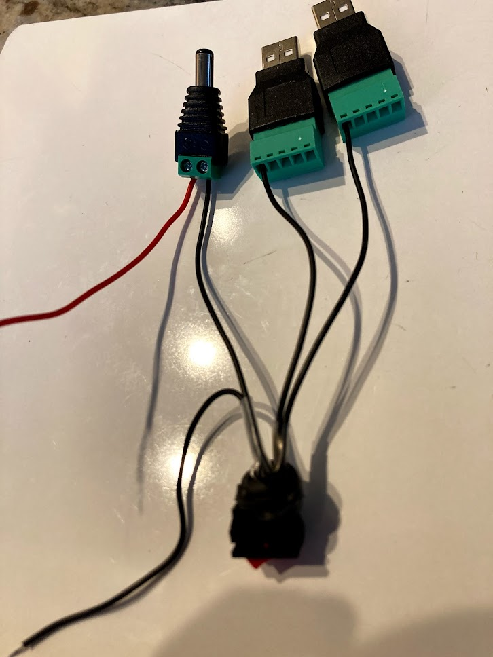
data/images/build-instructions/IMG_4083.jpg
