ScottMonaghan/robud-pi/data/images/build-instructions/IMG_4084.jpg

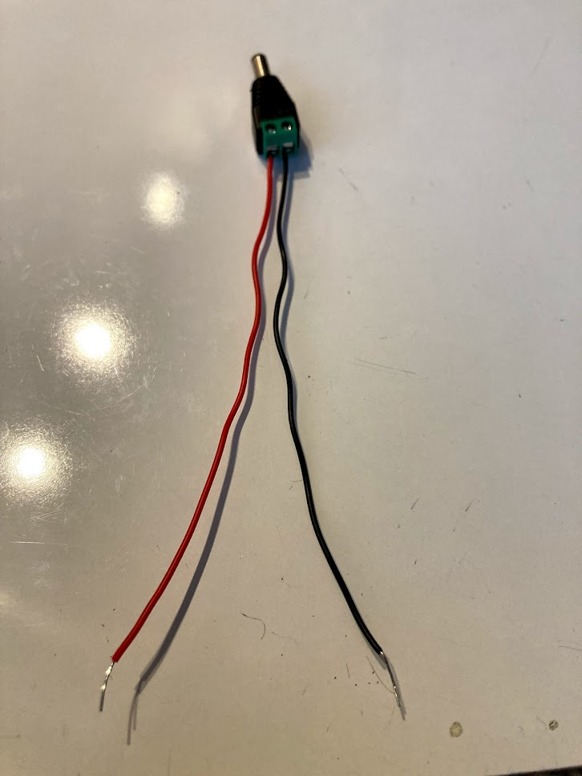
data/images/build-instructions/IMG_4084.jpg
