ScottMonaghan/robud-pi/data/images/build-instructions/IMG_4085.jpg

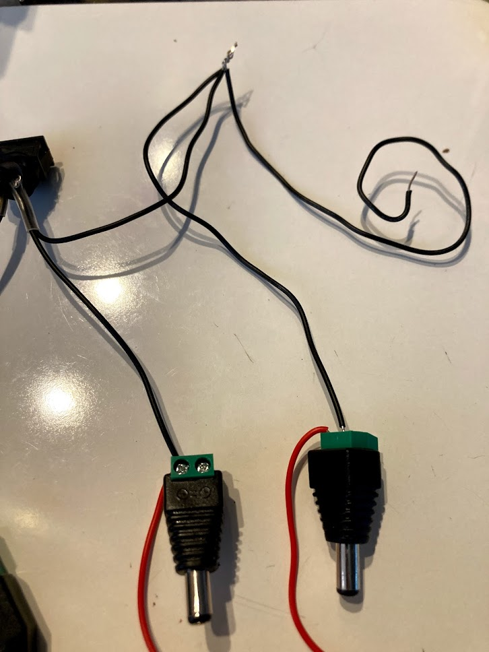
data/images/build-instructions/IMG_4085.jpg
