ScottMonaghan/robud-pi/data/images/build-instructions/IMG_4086.jpg

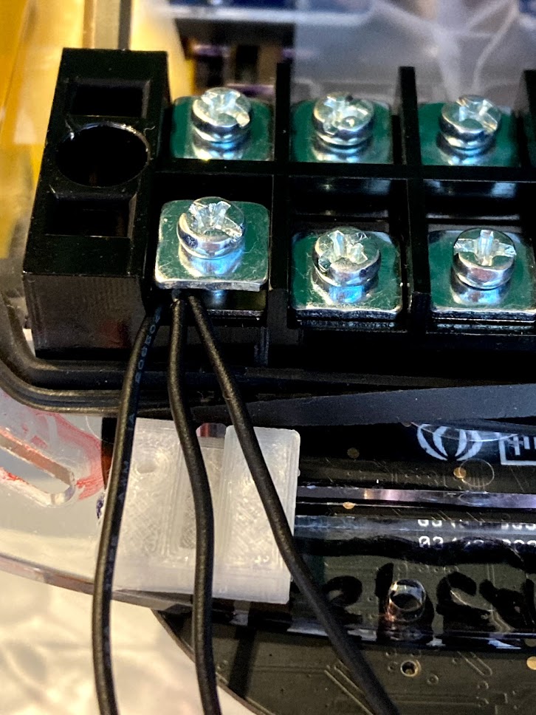
data/images/build-instructions/IMG_4086.jpg
