ScottMonaghan/robud-pi/data/images/build-instructions/IMG_4087.jpg

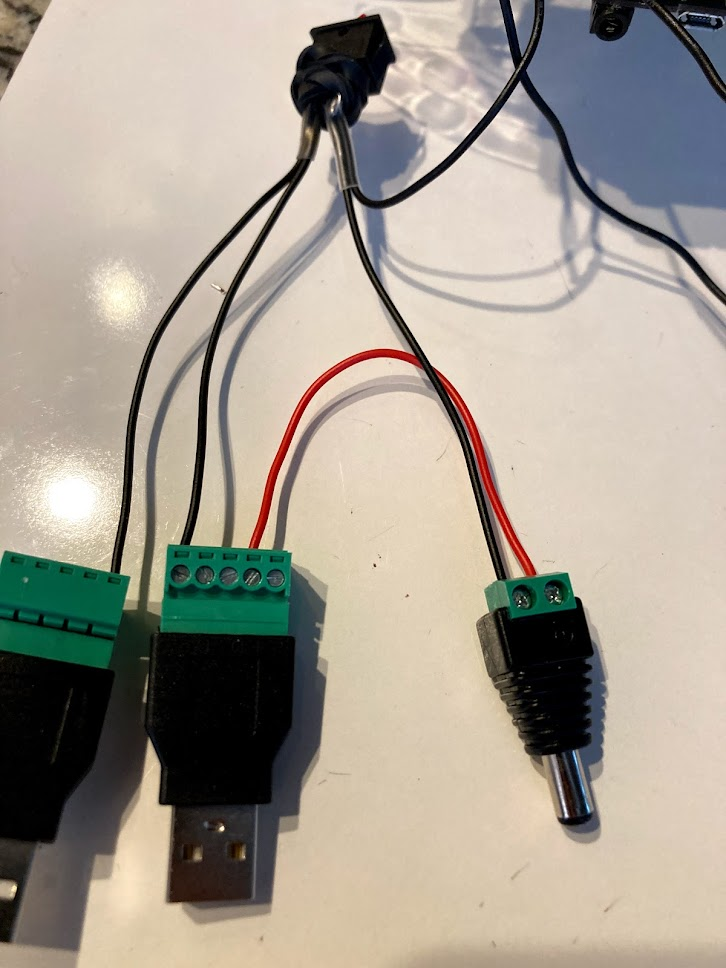
data/images/build-instructions/IMG_4087.jpg
