ScottMonaghan/robud-pi/data/images/build-instructions/IMG_4088.jpg

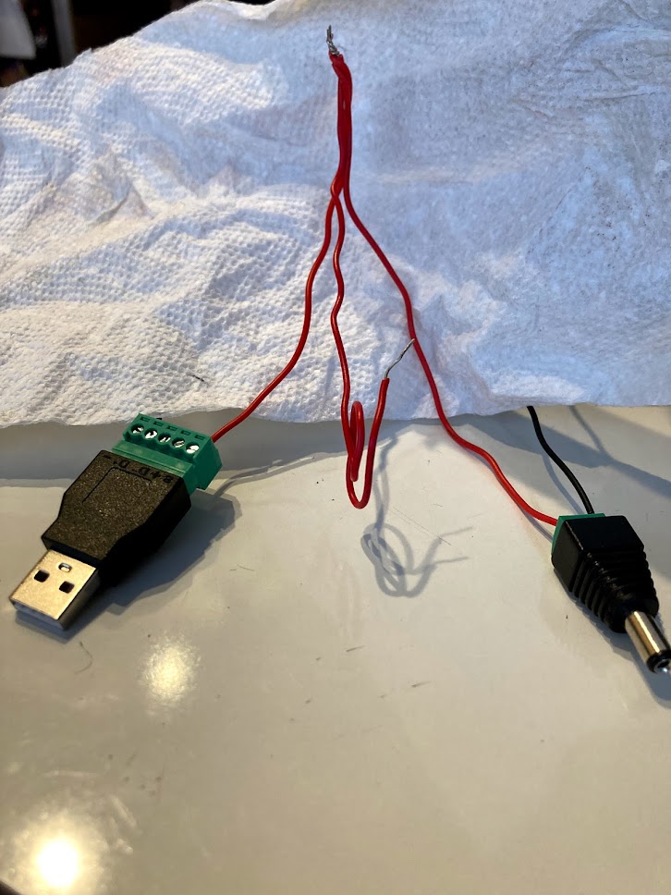
data/images/build-instructions/IMG_4088.jpg
