ScottMonaghan/robud-pi/data/images/build-instructions/IMG_4089.jpg

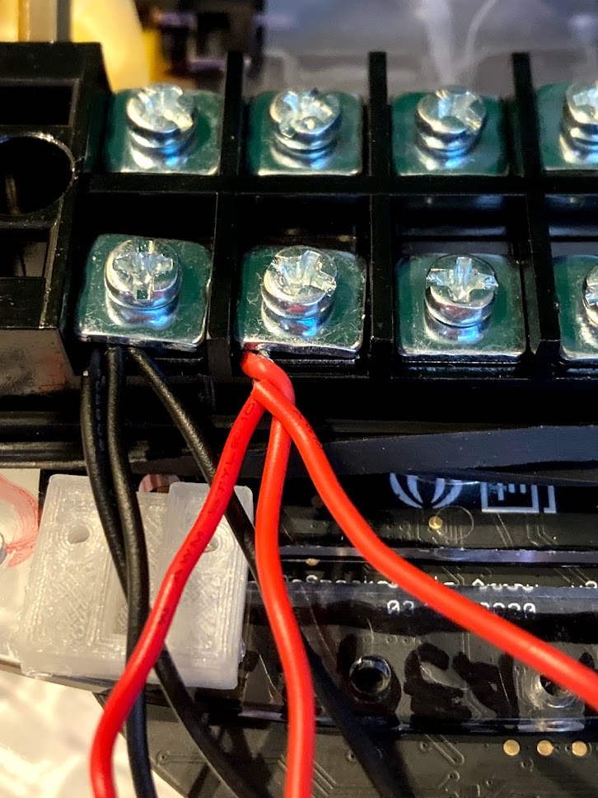
data/images/build-instructions/IMG_4089.jpg
