ScottMonaghan/robud-pi/data/images/build-instructions/IMG_4090.jpg

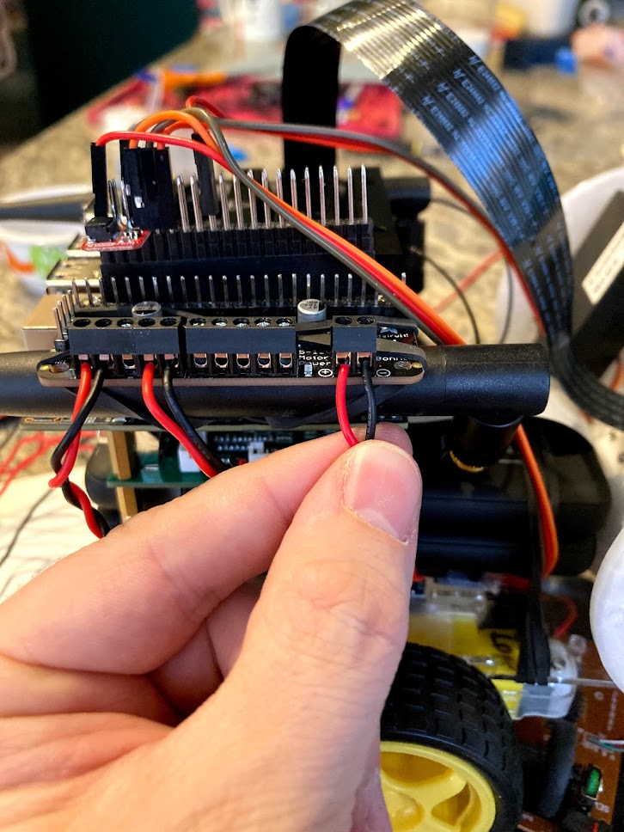
data/images/build-instructions/IMG_4090.jpg
