ScottMonaghan/robud-pi/data/images/build-instructions/IMG_4091.jpg

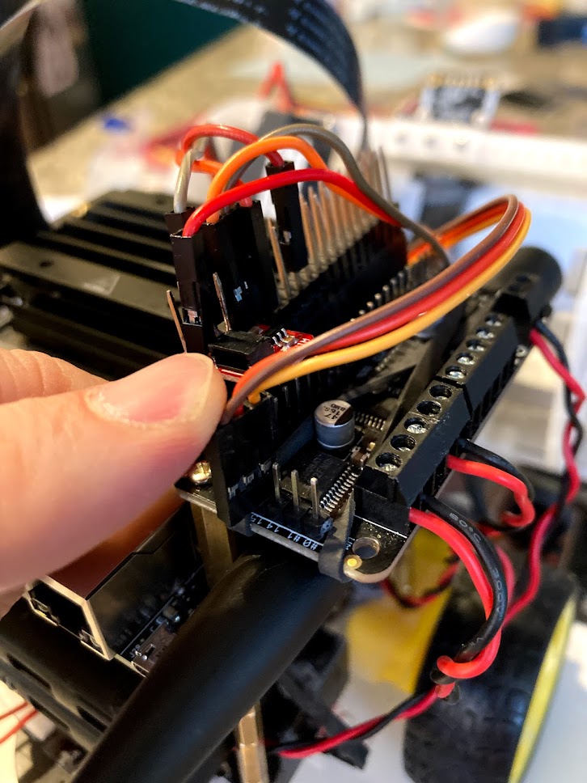
data/images/build-instructions/IMG_4091.jpg
