ScottMonaghan/robud-pi/data/images/build-instructions/IMG_4092.jpg

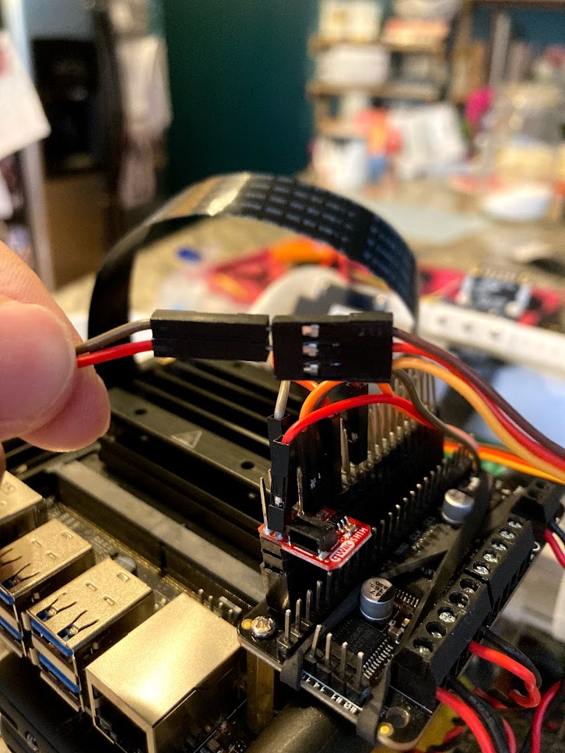
data/images/build-instructions/IMG_4092.jpg
