ScottMonaghan/robud-pi/data/images/build-instructions/IMG_4093.jpg

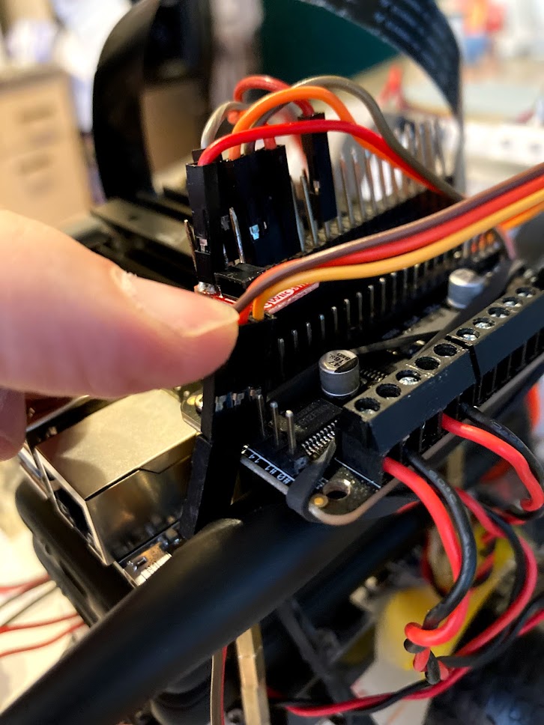
data/images/build-instructions/IMG_4093.jpg
