ScottMonaghan/robud-pi/data/images/build-instructions/IMG_4094.jpg

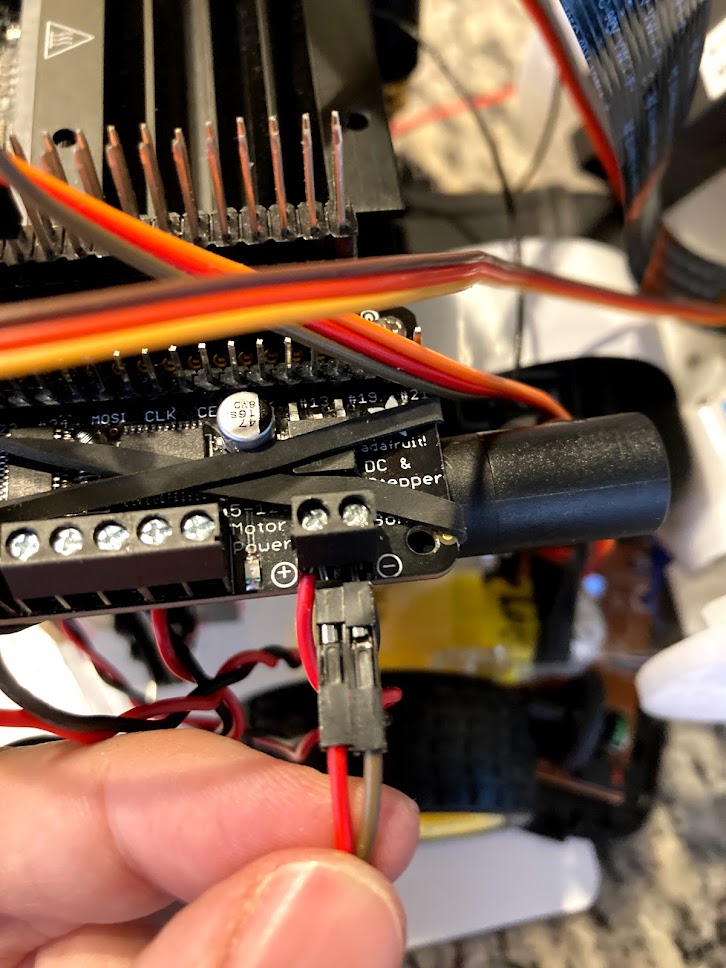
data/images/build-instructions/IMG_4094.jpg
