ScottMonaghan/robud-pi/data/images/build-instructions/IMG_4095.jpg

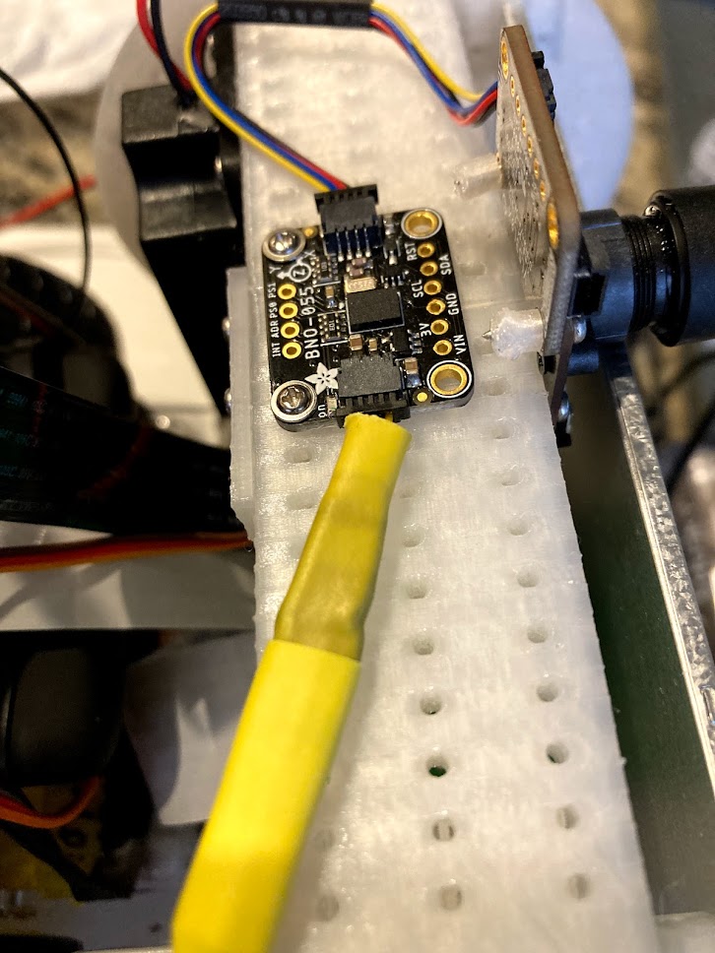
data/images/build-instructions/IMG_4095.jpg
