ScottMonaghan/robud-pi/data/images/build-instructions/IMG_4096.jpg

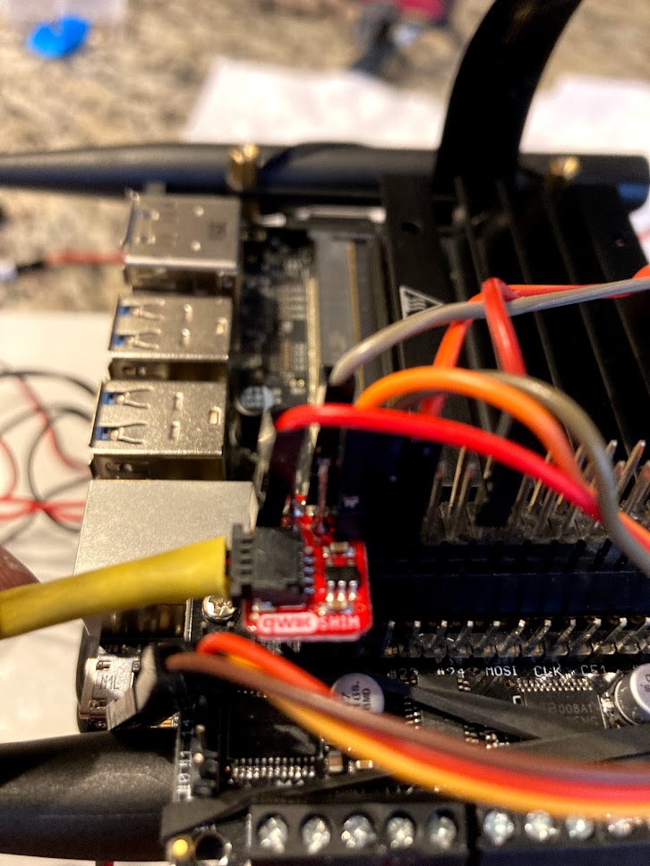
data/images/build-instructions/IMG_4096.jpg
