ScottMonaghan/robud-pi/data/images/build-instructions/IMG_4097.jpg

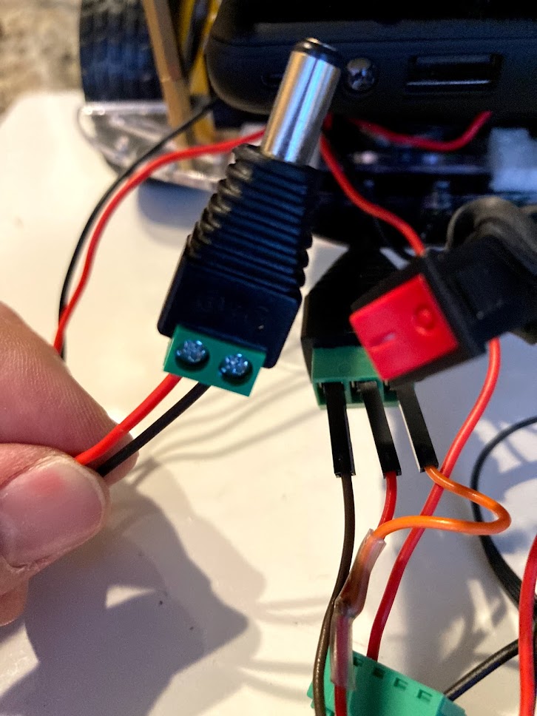
data/images/build-instructions/IMG_4097.jpg
