ScottMonaghan/robud-pi/data/images/build-instructions/IMG_4098.jpg

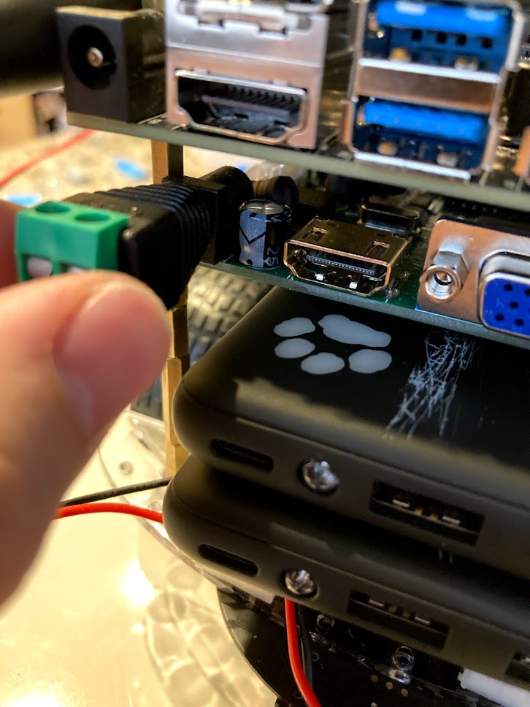
data/images/build-instructions/IMG_4098.jpg
