ScottMonaghan/robud-pi/data/images/build-instructions/IMG_4099.jpg

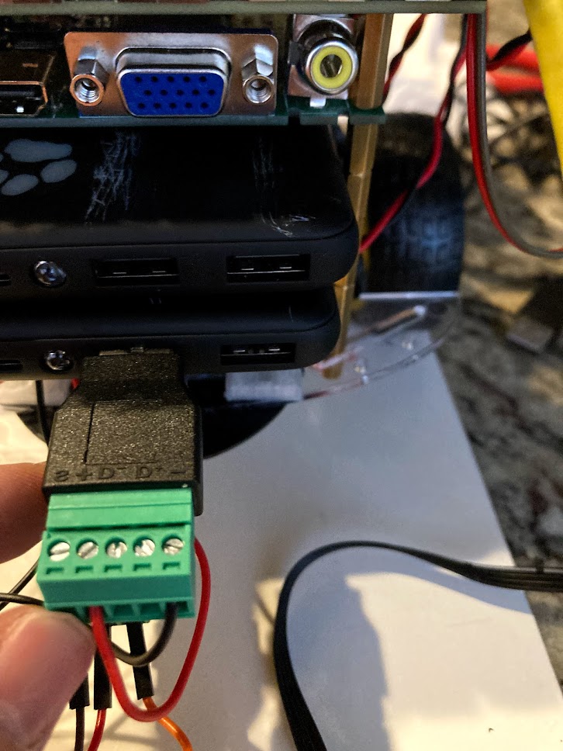
data/images/build-instructions/IMG_4099.jpg
