ScottMonaghan/robud-pi/data/images/build-instructions/IMG_4100.jpg

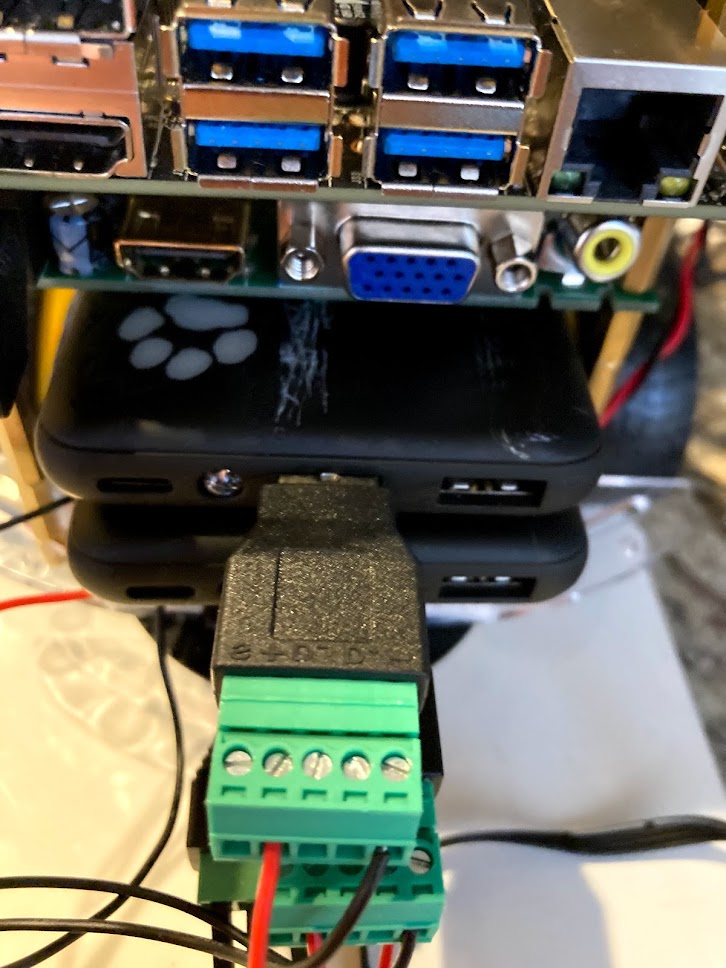
data/images/build-instructions/IMG_4100.jpg
