ScottMonaghan/robud-pi/data/images/build-instructions/IMG_4101.jpg

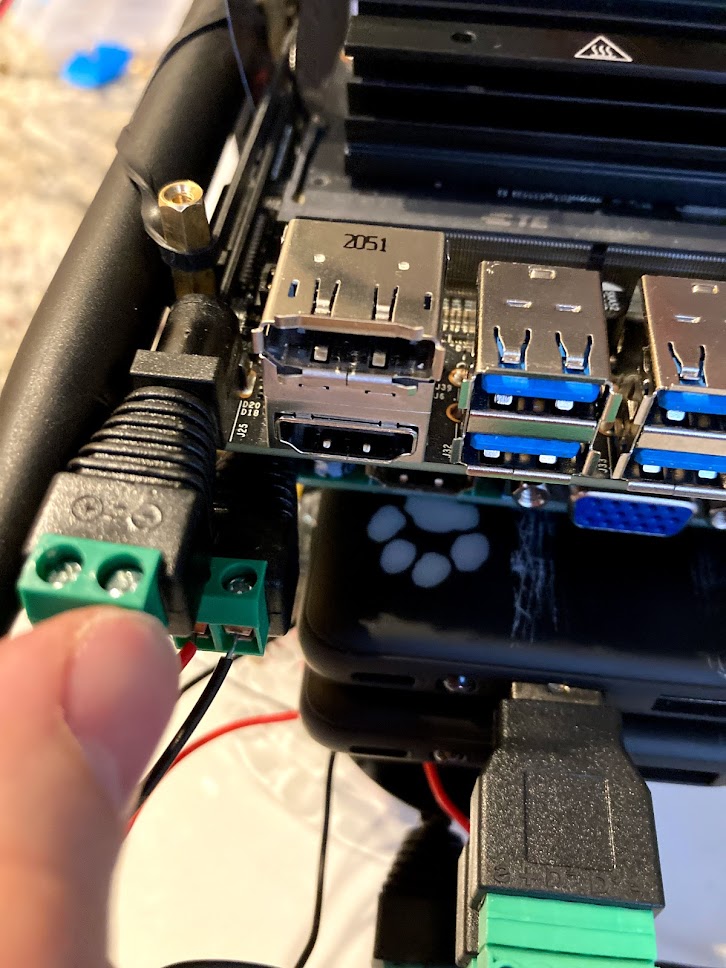
data/images/build-instructions/IMG_4101.jpg
