ScottMonaghan/robud-pi/data/images/build-instructions/IMG_4102.jpg

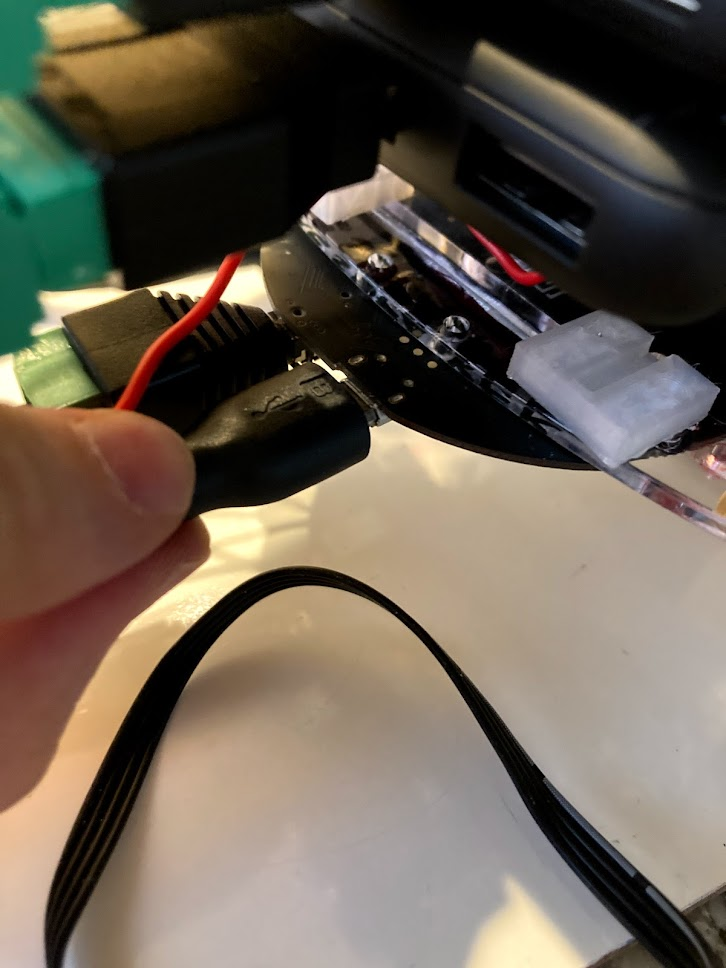
data/images/build-instructions/IMG_4102.jpg
