ScottMonaghan/robud-pi/data/images/build-instructions/IMG_4103.jpg

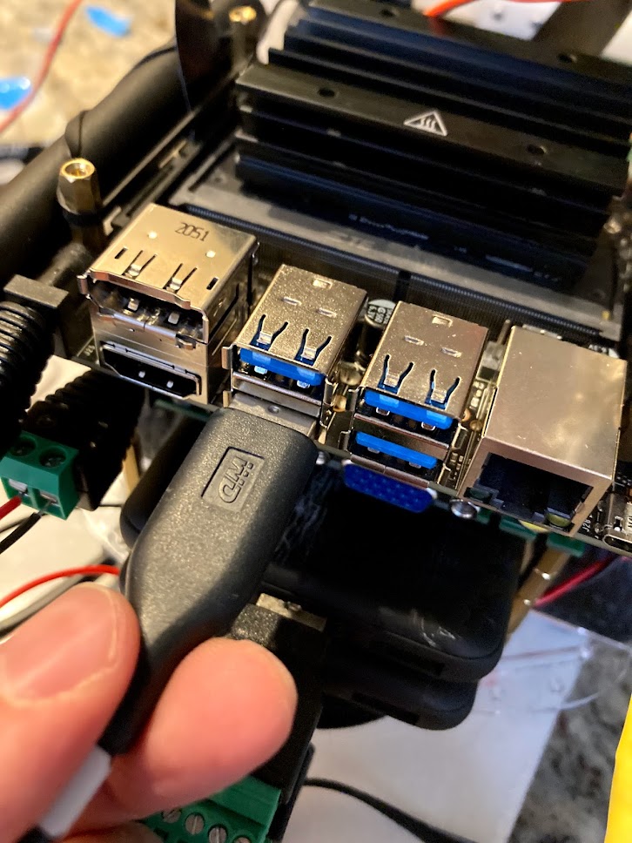
data/images/build-instructions/IMG_4103.jpg
