ScottMonaghan/robud-pi/data/images/build-instructions/IMG_4104.jpg

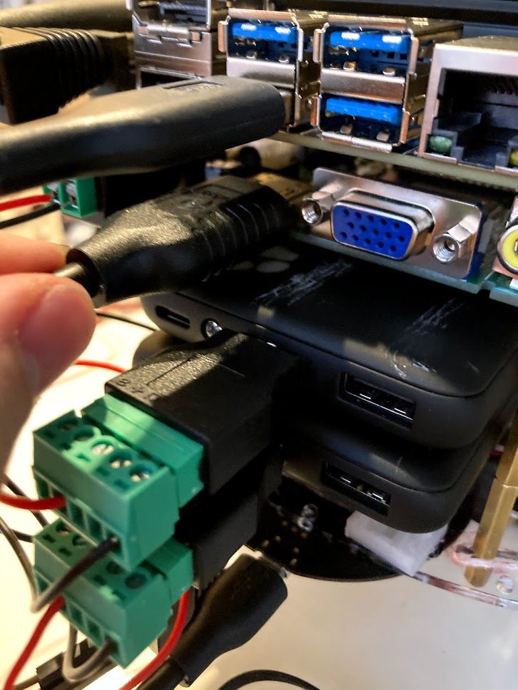
data/images/build-instructions/IMG_4104.jpg
