ScottMonaghan/robud-pi/data/images/build-instructions/IMG_4105.jpg

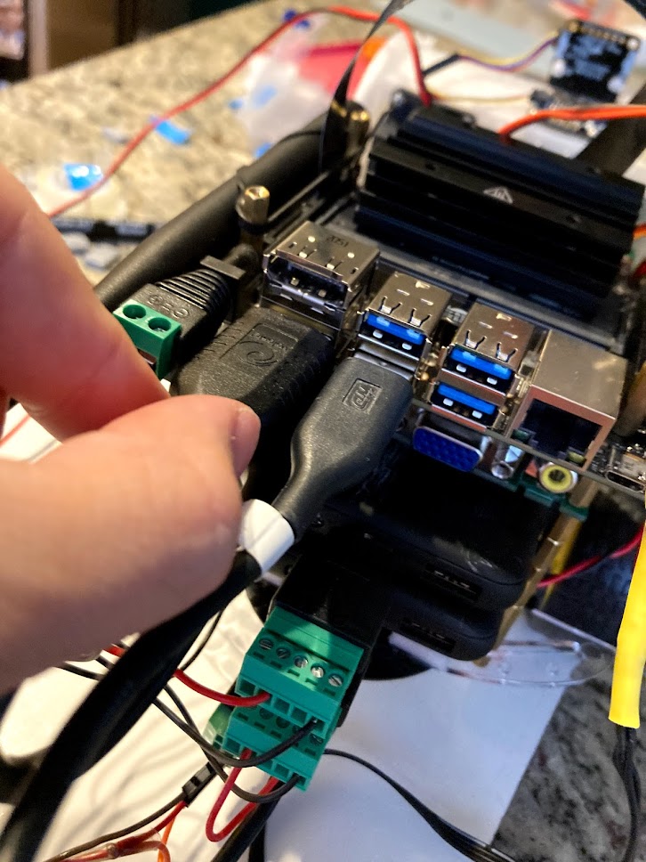
data/images/build-instructions/IMG_4105.jpg
