ScottMonaghan/robud-pi/data/images/build-instructions/IMG_4106.jpg

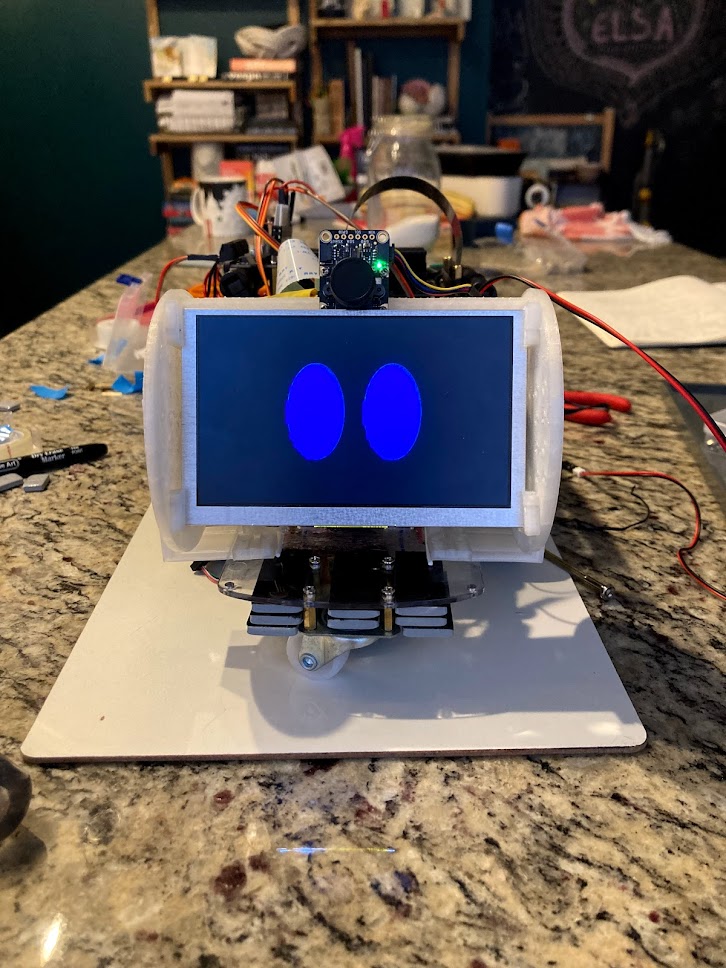
data/images/build-instructions/IMG_4106.jpg
