ScottMonaghan/robud-pi/data/images/build-instructions/IMG_4107.jpg

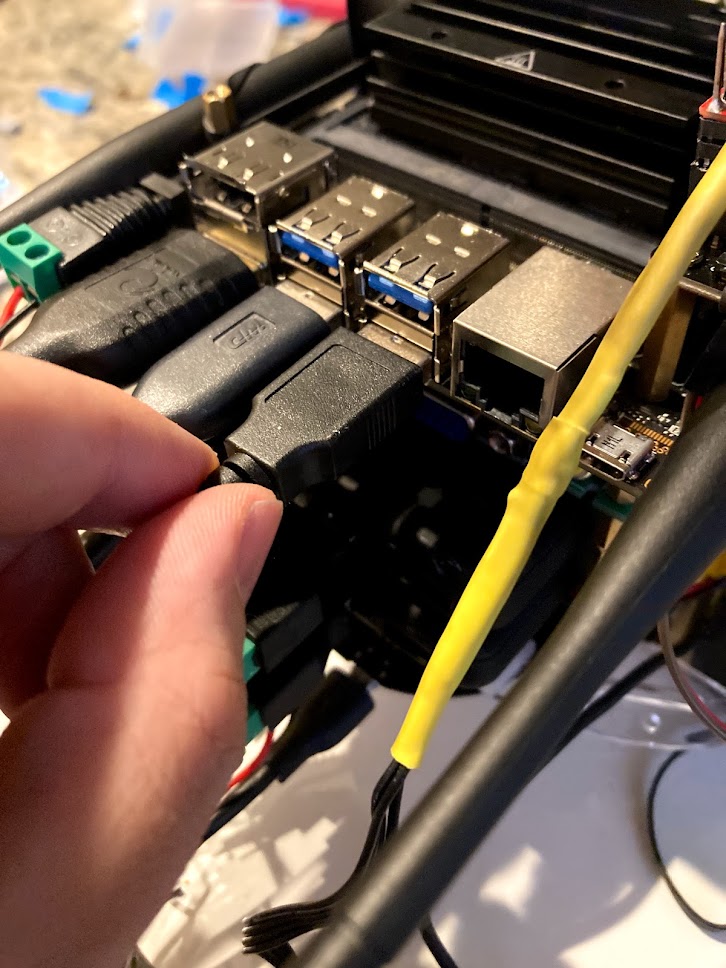
data/images/build-instructions/IMG_4107.jpg
