ScottMonaghan/robud-pi/data/images/build-instructions/IMG_4108.jpg

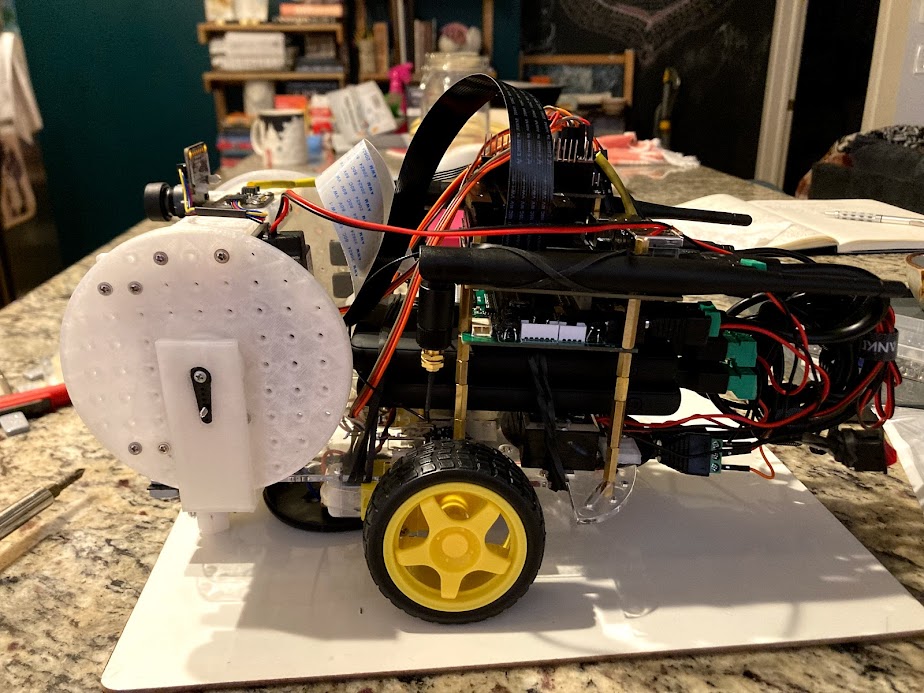
data/images/build-instructions/IMG_4108.jpg
