ScottMonaghan/robud-pi/data/images/build-instructions/IMG_4109.jpg

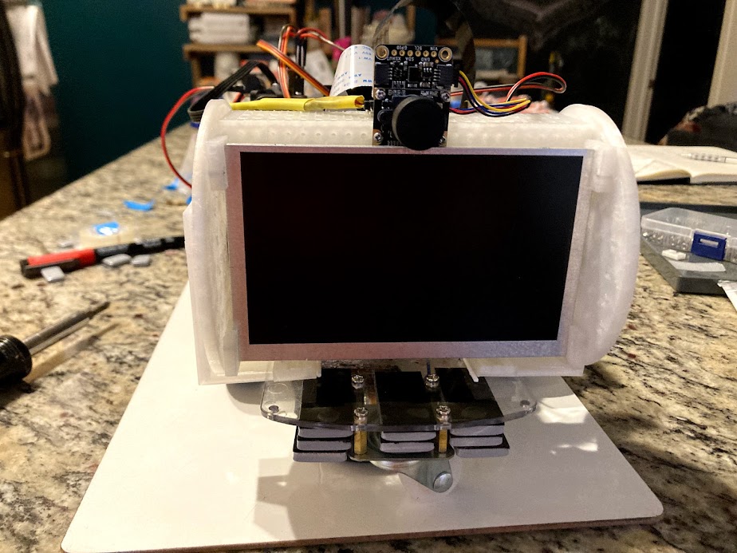
data/images/build-instructions/IMG_4109.jpg
