ScottMonaghan/robud-pi/data/images/build-instructions/IMG_4110.jpg

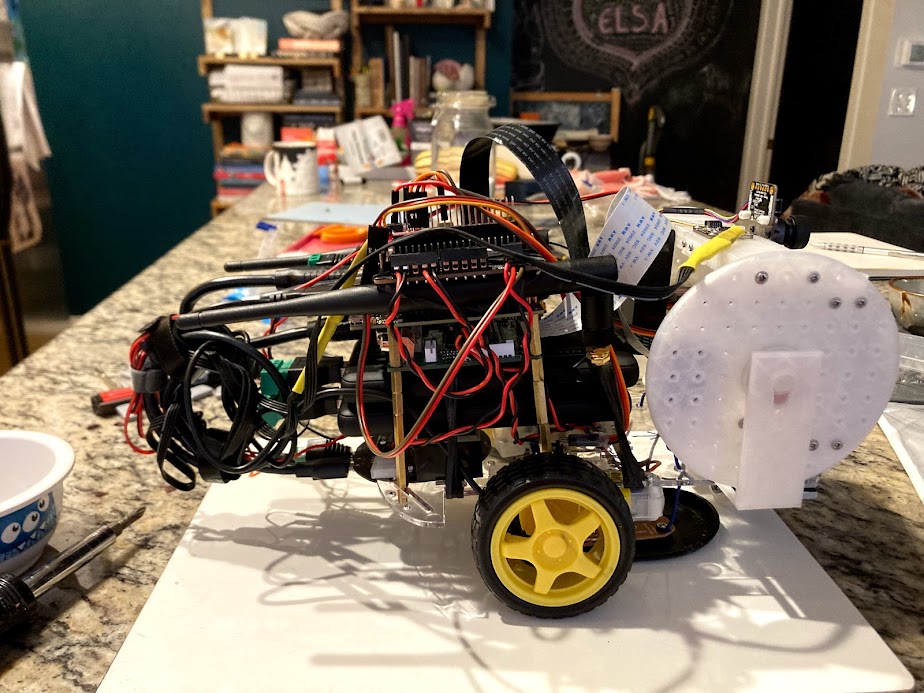
data/images/build-instructions/IMG_4110.jpg
