ScottMonaghan/robud-pi/data/images/build-instructions/motor-bonnet-extra-pwm.png

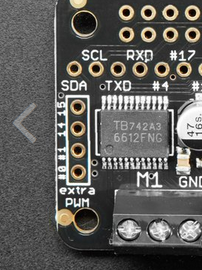
data/images/build-instructions/motor-bonnet-extra-pwm.png
