ScottMonaghan/robud-pi/sensors/orientation.py

import board
import busio
import time
import paho.mqtt.client as mqtt
import adafruit_bno055
import random
from robud.robud_logging.MQTTHandler import MQTTHandler
import argparse
import logging
from datetime import datetime
import os
import sys
import traceback
from time import sleep

while True:
    random.seed()

    MQTT_BROKER_ADDRESS = "robud.local"
    MQTT_CLIENT_NAME = "orientation.py" + str(random.randint(0,999999999))

    TOPIC_ROBUD_LOGGING_LOG = "robud/robud_logging/log"
    TOPIC_ROBUD_LOGGING_LOG_SIGNED = TOPIC_ROBUD_LOGGING_LOG + "/" + MQTT_CLIENT_NAME
    TOPIC_ROBUD_LOGGING_LOG_ALL = TOPIC_ROBUD_LOGGING_LOG + "/#"
    LOGGING_LEVEL = logging.DEBUG

    #parse arguments
    parser = argparse.ArgumentParser()
    parser.add_argument("-o", "--Output", help="Log Ouput Prefix", default="logs/orientation_log_")
    args = parser.parse_args()

    #initialize logger
    logger=logging.getLogger()
    file_path = args.Output + datetime.now().strftime("%Y-%m-%d") + ".txt"
    directory = os.path.dirname(file_path)
    if not os.path.exists(directory):
        os.makedirs(directory)
    log_file = open(file_path, "a")
    myHandler = MQTTHandler(hostname=MQTT_BROKER_ADDRESS, topic=TOPIC_ROBUD_LOGGING_LOG_SIGNED, qos=2, log_file=log_file)
    myHandler.setFormatter(logging.Formatter('%(asctime)s - %(levelname)s: %(filename)s: %(message)s'))
    logger.addHandler(myHandler)
    logger.level = LOGGING_LEVEL

    try:
        logger.info("Starting")

        i2c = busio.I2C(board.SCL, board.SDA)
        sensor = adafruit_bno055.BNO055_I2C(i2c)
        rate = 15 #publish rate in hz
        topic_orientation_euler = "robud/sensors/orientation/euler"
        topic_orientation_heading = "robud/sensors/orientation/heading"
        topic_orientation_pitch = "robud/sensors/orientation/pitch"
        topic_orientation_roll = "robud/sensors/orientation/roll"
        topic_orientation_calibration_status_sys = "robud/sensors/orientation/calibration_status/sys"
        topic_orientation_calibration_status_gyro = "robud/sensors/orientation/calibration_status/gyro"
        topic_orientation_calibration_status_accel = "robud/sensors/orientation/calibration_status/accel"
        topic_orientation_calibration_status_mag = "robud/sensors/orientation/calibration_status/mag"


        client = mqtt.Client(MQTT_CLIENT_NAME) #create new instance
        client.connect(MQTT_BROKER_ADDRESS)
        client.loop_start()
        while True:
            loop_start = time.time()
            orientation_euler = sensor.euler
            orientation_heading = orientation_euler[0]
            orientation_roll = orientation_euler[1]
            orientation_pitch = orientation_euler[2]
            orientation_calibration_status = sensor.calibration_status
            orientation_calibration_status_sys = sensor.calibration_status[0]
            orientation_calibration_status_gyro = sensor.calibration_status[1]
            orientation_calibration_status_accel = sensor.calibration_status[2]
            orientation_calibration_status_mag = sensor.calibration_status[3]

            client.publish(topic=topic_orientation_heading,payload=orientation_heading,retain=True)
            client.publish(topic=topic_orientation_roll,payload=orientation_roll,retain=True)
            client.publish(topic=topic_orientation_pitch,payload=orientation_pitch,retain=True)
            client.publish(topic=topic_orientation_calibration_status_sys,payload=orientation_calibration_status_sys,retain=True)
            client.publish(topic=topic_orientation_calibration_status_gyro,payload=orientation_calibration_status_gyro,retain=True)
            client.publish(topic=topic_orientation_calibration_status_accel,payload=orientation_calibration_status_accel,retain=True)
            client.publish(topic=topic_orientation_calibration_status_mag,payload=orientation_calibration_status_mag,retain=True)
            loop_time = time.time()-loop_start
            if (loop_time<1/rate):
                time.sleep( 1/rate - loop_time)
    except Exception as e:
        logger.critical(str(e) + "\n" + traceback.format_exc())
        logger.info('Restarting in 1 second...')
        sleep(1)
    except KeyboardInterrupt:
        logger.info("Exited with Keyboard Interrupt")
        exit(0)



  
