ScottMonaghan/robud-pi/(commit log)

2022-10-22 Copied https://github/scottmonaghan/robud
    [robud-1-hole-fastener.stl, robud-3-hole-fastener.stl, robud-display-fastener.stl, robud-head-L-bracket.stl, robud-head-barrel-wall.stl, robud-head-shaft-adapter.stl, robud-horizontal-brace.stl, robud-servo-adapter.stl]
2023-01-06 Many changes for RPi conversion
    [hey-mycroft.pb.params]
2023-01-13 Updated camera.py to use picamera2
2023-01-17 Throttled camera service to 15fps
2023-01-18 Fixed BGR to RGB conversion
    [camera.py]
2023-01-27 Added base STLs
    [Battery Fastener FL.stl, Battery Fastener FR.stl, Board Fastener.stl]
2023-02-08 Allowed motors.py to work without servo driver
2023-02-10 Create Back Wheel Cap.stl
    [Back Wheel Cap.stl]
2023-02-10 Added Track STLs
    [Back Wheel Cap.stl, Back Wheel Sprocket.stl, Bearing Peg & Spacer.stl, Front Wheel 1.stl, Front Wheel Hubcap.stl, Inner-Chassis-Brace_Left.stl, Inner-Chassis-Brace_Right.stl, Outer-Chassis-Brace_Left.stl]
2023-02-11 Remodeled sprocket, hub fastener, & inner chassis
    [Back Wheel Sprocket.stl, Inner-Chassis-Brace_Left.stl, Inner-Chassis-Brace_Right.stl, hub fastener.stl]
2023-04-19 Update README.md
    Add open-cv requirement for camera monitor
2023-05-27 Made updates to chat & motors
